epatel/discrete6502/pico-controller/README.md

# pico-controller: firmware for the discrete6502 bring-up Pico

The board carries an unpopulated **Raspberry Pi Pico 2 W** site. Factory-fitted
1k series resistors wire it to the CPU data bus, 14 address bits, clock, reset,
R/W and SYNC. Solder a Pico on and flash one of these firmwares. The Pico then
becomes the **clock master and memory emulator**, and the 6502 runs real
programs with no other hardware attached.

## Projects

| Folder | Purpose |
|---|---|
| `common/` | Shared bus engine (`bus6502.c/h`): pin map, clocking, memory serving, trace ring, reset. Also `functest.c/h` (functional-test watcher), `ihex.c/h` (streaming Intel hex loader), `retention.c/h` (charge-retention measurement) and the SDK import cmake. |
| `tester/` | **Bring-up harness.** A USB serial CLI. It resets the CPU, runs or traces N cycles, steps instructions, reads and writes memory, sets the clock speed, loads an Intel hex image, and runs the functional test. The default image is an A-register counter loop. Watch the A LEDs count. |
| `general/` | **Free-runner.** It boots the CPU and lets it run. A memory-mapped character-output port at `$3F00` prints to USB serial. The default image prints `HELLO 6502` forever. |
| `wifi/` | **Browser control panel.** The same bus engine runs on core 1. WiFi and a small HTTP server run on core 0. Upload an Intel hex, run, stop, step, reset, set the clock, and watch the bus and the functional-test progress live. It is built for unattended overnight test runs. |

Add a new project as a sibling folder (`pico-controller/<name>/`). Reuse
`common/`.

## Pin map (fixed by the board, do not change)

| Pico GPIO | Signal | Direction (Pico view) |
|---|---|---|
| GP0–7 | db0–7 | bidirectional |
| GP8–21 | ab0–13 | in |
| GP22 | clk0 | out (clock master) |
| GP26 | /res | out, open-drain |
| GP27 | r/w | in |
| GP28 | sync | in |

The CPU sees only 14 address bits. Memory is a **16 KB image**, mirrored across
the 64 KB space. The reset vector `$FFFC/D` is at offset `0x3FFC/D` in the
image.

## Bring-up sequence: read before first power-up

**The procedure of record is [`docs/bring-up.html`](../docs/bring-up.html)**
(live at `epatel.github.io/discrete6502/bring-up.html`), and what actually
happened, with every measurement, is in
[`docs/actual-bring-up.html`](../docs/actual-bring-up.html). This file used to
restate the whole sequence and drifted out of date against both — Step 1 kept a
gate that hardware falsified, Step 2 kept a prediction that was wrong by 4x. So
it no longer restates it. **The numbering below matches `docs/bring-up.html`
(Steps 0–8)**; what is written out here is the part that belongs to the
firmware, and everything else is a one-line pointer.

| | Step | Power |
|---|---|---|
| 0 | Receiving inspection | none |
| 1 | VCC↔VSS resistance | none |
| 2 | Board alone at 5 V, unclocked, no Pico | 5 V |
| 3 | Optional: external clock, watch the LEDs | 5 V |
| 4 | The eight-site 10 kΩ rework | none |
| 5 | **Solder the Pico** | none |
| 6 | First clocked run: the A-register counter | 5 V |
| 7 | Measure the clock window | 5 V |
| 8 | The functional test: the acceptance gate | 5 V |

Steps 0–4 need no Pico and no firmware — U1 is DNP, so the board arrives with no
3.3 V part on it and no logic-level question exists at any rail. Two results from
those steps set the numbers everything later is judged against, and **both
contradict what this file used to say**:

- **Step 1 does not "read high".** There is no resistor-only path between VCC and
  VSS at all: **1,899 FET body diodes across 947 nets** conduct VSS → drain → 10 kΩ
  → VCC, so the meter reads a *junction*, and the displayed value depends on the
  range. Board #1 read **195 Ω / 314 Ω / 3.77 kΩ** on the 200 Ω / 2k / 20k ranges
  while the voltage across it stayed at 0.36–0.47 V. **A fault is under 1 Ω, or a
  value that does not change with range.** And it is a *positive* test: that
  forward path cannot exist unless the pull-ups are populated, so one measurement
  confirms ~1,000 back-side 0402s are present.
- **Step 2 draws 1.4 A at 5 V, not 0.35 A** — but only because no Pico is fitted
  yet, so `clk0`, the data bus and reset are floating and the dynamic nodes drift.
  **Once the Pico is on, a parked clock draws 0.30 A** (the designed passive
  budget) and **executing draws 1.70 A** (measured, board #1, 2026-08-26). Treat a
  *change* from those figures as the signal, not an absolute.

Step 4's rework **has been done on board #1**. It is still required on any board
that has not had it; it fixes an invalid logic level, not a thermal problem —
that alarm was retracted on 2026-08-24.

### Step 5: solder the Pico

**Flash the firmware onto the bare module first**, on the bench, and confirm it
enumerates over USB. Then solder the Pico 2 W module on the underside site.
**Solder pin 39.** See Powering for why pin 39 must be a soldered joint and not a
decision.

Pin 38 is `vss` and pin 39 is `vcc`, side by side on 2.54 mm pitch. A solder
bridge between them is a dead short across the board supply. **Repeat the Step 1
resistance measurement after you solder the module**, and apply power only after
that measurement — reading it the range-aware way described above.

> **⚠ CHANGED 2026-08-25 — a powered board now clocks itself immediately.**
> This file used to say the firmware was "inert at boot", blocking on
> `while (!stdio_usb_connected())` so that a pre-programmed board powered with no
> terminal attached "does nothing: no clocking and no reset ceremony". **That is
> no longer true, and the change was deliberate.** No firmware here blocks
> waiting for a terminal, because the old blocking path left clk0 parked LOW —
> which was believed to be the board's peak current state. **That was wrong on a
> populated board** — see the correction under Powering: a parked clock draws
> **0.30 A** and executing draws **1.70 A**, so parking is the cheapest state, not
> the most expensive. Autorun remains the right default because you want the CPU
> doing something, not to save power.
>
> With `autorun` on, which is the **default**, applying power runs the reset
> ceremony and free-runs the stored or built-in image straight away. That is the
> cooler state and the more useful one, but it means **first power-up is now an
> event, not a decision.** Do the resistance measurement before you apply power,
> not after.
>
> If you want the old behaviour for a first power-up, set `S autorun off` (tester)
> or turn Autorun off in the panel's Diagnostics section *before* soldering — the
> setting lives in flash and survives. The clock then stays parked, which costs
> the extra 0.5 A but touches nothing.

#### Flash before soldering, even though it can be reflashed in place

The module can be reprogrammed in place indefinitely, and with no button press:
`pico_stdio_usb/reset_interface.c` is linked into all three firmwares, so the SDK
1200-baud-touch reset works and `picotool load -f -x` reboots the module into its
bootloader over USB. Flash it once beforehand anyway, for three reasons.

- **A bad module is cheap to reject before it is soldered.** The
  `RaspberryPi_Pico_W_SMD` pads are 3.2 × 1.6 mm and run *under* the module, so
  desoldering one is a poor operation to perform beside 4,051 transistors.
- **The first flash is the one that needs BOOTSEL**, held while the board
  power-cycles. That is the awkward step, and it is the step you can do off the
  board.
- **The first power-up becomes a known state**, not merely a harmless one. A blank
  module is safe, because RP2350 GPIOs default to inputs, but safe and known are
  not the same property.

**Verify what is on the module rather than trusting the banner**: the banner is
identical across recent builds, so use `picotool verify -f wifi/build/wifi.uf2`,
which diffs flash against the binary and prints the mismatching bytes. If you
have more than one module on the bench, `picotool` reports a per-board serial —
worth writing on a sticker, because two provisioned boards both answer to
`discrete6502.local` and you cannot tell from the panel which one you have.

**Unverified, worth checking before you choose a workholding setup:** the module
mounts pads-down, so its component side — USB connector and BOOTSEL button —
faces away from the PCB, which is downward when the board lies flat on its back.
Prop the board up or use standoffs to reach the connector. This is reasoned from
the footprint, not from a board in hand.

### Step 6: first clocked run

Power the board at 5 V. The firmware is already on the module from Step 5;
reflash in place if you have changed it, no button press needed. USB may stay
connected for serial.

With autorun on it is **already running** when you attach — the tester reports
how many cycles it free-ran while waiting, and the wifi firmware's banner reports
the cycle count. Run the default A-register counter image and watch the A LEDs
count.

Watch the supply current here. Measured on board #1, a clocked board sits at
**1.70 A executing against 0.30 A with the clock stopped** (2026-08-26). The
stopped figure is the passive network as designed; the 1.40 A difference is
contention. Treat a *change* as the signal.

**Two tie-offs that are not optional**, both learned the hard way on board #1:

- **Tie the data bus to `$EA` (NOP) through 10 kΩ** if the Pico is not driving it.
  A floating bus fetches random opcodes and **12 of the 256 are undocumented
  KIL/JAM**, so the CPU halts within ~20 instructions. With the Pico serving
  memory this is moot, but it matters for any external-clock experiment.
- **Tie `irq` and `nmi` high.** Neither has a pull-up on this board. A spurious
  IRQ is *absorbed* by the functional test's BRK handler at `$3819` — live code,
  not a trap — and resurfaces as a failure at an unrelated address. That is a
  wrong verdict that looks like a real CPU defect, which is worse than a stopped
  run. The firmware warns at load time.

### Step 7: measure the clock window

Walk the clock up with `p` (tester) or the panel's clock chips to find the real
ceiling; simulation says ~20 kHz at 5 V.

**The floor no longer needs measuring**: it was established at **456–871 Hz**
(leakage 1.9–2.3 nA per FET) from LED decay on board #1 — see
`docs/actual-bring-up.html` Step 2b. `W` is now a confirmation, not a first
measurement, and the "never run it before the rework" warning is retired along
with the thermal alarm. **Recommended working clock: 4–5 kHz**, the geometric
centre of the measured window.

Note the panel and the tester both display the clock as `1e6/(2*half)` — the
*nominal* rate. Measured, the loop costs about 1.2 µs per cycle, so 10,000 Hz
nominal is **9,878 Hz actual** (1.2% low; ~2.4% at the 20 kHz ceiling). It does
not matter for running programs, but it does if you are predicting frequencies —
`tools/pc_ripple.py` takes the true clock as an argument for exactly that reason.

### Step 8: the functional test

See "Running the 6502 functional test suite" below, and `docs/bring-up.html`
Step 8. Tie `irq` high first (above), and turn the console **off** — it
intercepts three addresses inside the range the suite checksums.

3.3 V is **not** a step in this sequence. It is a diagnostic fallback. See
"3.3 V operation" below.

## Logic levels

The Pico is a 3.3 V device. The CPU core runs at 5 V. This is the one
**unresolved hardware question** for bring-up. It does not affect the PCB.

- **Inputs to the Pico** (db on writes, ab, rw and sync at 5 V). The 1k series
  resistors limit the clamp current to about 1.4 mA per pin, and to about
  34 mA in total with all 24 input lines high. This is the common practical
  arrangement, but it is formally outside the RP2350 specification. It is
  acceptable for bring-up. Do not leave the CPU powered at 5 V while the Pico
  has no power. A soldered pin 39 makes that state impossible.
- **Clock drive.** The board has no pull-up on clk0. clk0 is a pure input: two
  FET gates, a 100R series resistor and the clamp diodes. Nothing holds a
  level. The clock source must therefore drive clk0 push-pull. An open-drain
  driver pulls clk0 low and then leaves it floating, and a dynamic CPU cannot
  survive that. `bus_init(false)` is the default and the correct mode.
  `bus_init(true)` works only if you first croc-clip an external **10k resistor
  from the Φ0 bond pad to the VCC bond pad**.
- **A 3.3 V clock into a 5 V core is safe**, and needs no pull-up. clk0 does
  not gate the pass transistors. It drives two pull-down gates, and the board
  regenerates the internal clock phases (`cclk`, 482 gates, and `cp1`, 198
  gates) at full VCC swing. In simulation, a 3.3 V clk0 into a 5 V core gives
  an input-inverter low of 1.7 mV and 17 ns of delay. A 5 V clock gives 1.4 mV
  and 7 ns. There is no functional difference.

## Powering

Board VCC feeds the Pico VSYS pin (pin 39). The two grounds are common. VSYS
accepts 1.8 V to 5.5 V, thus 3.3 V and 5 V are both in specification. Pin 39 is
the only supply pin. The Pico 3V3OUT pin (pin 36) is not connected, thus the
Pico regulator cannot feed the board.

### Either end can supply the power

A soldered pin 39 makes board VCC and Pico VSYS one node. Power therefore flows
in whichever direction you supply it, and **the bond pads are not mandatory**.

- **Bench supply on the bond pads.** The board runs, and the same rail feeds
  VSYS. The Pico then needs no USB power. Connect USB for serial only.
- **USB into the Pico.** VBUS goes through the module Schottky diode to VSYS
  and on to board VCC. One cable runs the whole CPU, with no croc clips.

Only Step 2 of the bring-up sequence needs the bond pads, and only because no
Pico is fitted at that point.

Use the bench supply for test runs, and USB-only mode to demonstrate the board.
The next two sections give the reasons.

### Pin 39 must be soldered

Solder pin 39 when you solder the module. Board VCC and Pico VSYS then become
the same node, and two problems disappear together.

- **No power-up sequence to remember.** The hazard is a 5 V core that drives 26
  clamp diodes into a dead 3V3 rail. One supply for both parts makes that
  condition unreachable.
- **No intermittent joint.** The `RaspberryPi_Pico_W_SMD` footprint has 3.2 x
  1.6 mm pads that extend inward, under the module. An unsoldered pin 39 is two
  flat copper faces that rest against each other, held apart only by the
  standoff that the adjacent solder joints happen to give. That gap is
  uncontrolled, and board flex or a croc clip can close it. An unsoldered pin 39
  is an intermittent contact, not an open circuit. A rail that makes and breaks
  corrupts every dynamic node at once, and the result looks like a random CPU
  fault.

The two rails do not rise together. Board VCC rises immediately. The Pico 3V3
rail follows some milliseconds later, through the buck-boost soft start. The
GPIO clamps do conduct during this interval, but from the same supply and
through the 1k series resistors. This is the usual arrangement on a Pico
carrier board. Board bulk capacitance is only about 50 uF (96 x 100 nF plus
4 x 10 uF), thus there is no inrush that can hold the ramp down.

At 5 V you can keep USB connected for serial at the same time. The module
Schottky diode drops USB VBUS to about 4.7 V to 4.8 V at VSYS, thus a 5.0 V
bench supply wins the node, and the diode blocks all back-feed into the host.

### USB-only demo mode

With no bench supply, Pico USB power runs the whole board through VBUS, the
module Schottky diode and VSYS. Three limits apply.

- **The rail is not 5.0 V.** It is VBUS minus the diode drop, and the board draws
  far more than this section once assumed, so through a Schottky and a USB cable
  it is a collapse rather than a droop. Cable resistance subtracts more still.
- **Current — USB-only mode is NOT viable at 5 V.** Measured on board #1:
  **0.30 A with the clock parked, 1.70 A executing** (measured 2026-08-26 with the
  Pico fitted; the 1.4 A recorded earlier was a *bare* board with clk0 and the bus
  floating). Use a **2–3 A bench supply**. The `wifi` firmware adds about 50 mA
  average with 200 mA transmit bursts on top of that.

  > **Corrected 2026-08-24.** This entry previously said ≈2.1 A from driver
  > contention — the eight data-bus drivers at 262 mA each — and before that
  > 0.35 A typical. **Both were wrong, in opposite directions.** Thermal imaging
  > found no hot spot anywhere (peak ~30 °C against 25 °C ambient), which a 0.9 W
  > SOT-323 could not hide, so the excess is spread over ~4,051 near-threshold
  > FETs at ~210 µA each rather than concentrated in a few contending pairs. The
  > 2 A charger that the 2.1 A figure ruled out is in fact adequate.
- **Use a bench supply for test runs.** This is dynamic logic. A rail sag does
  not degrade gracefully. It corrupts the dynamic nodes, and you read the
  result as a logic fault in the CPU. Use a bench supply with margin for the
  functional-test run, which is hours long. Keep USB-only mode for
  demonstrations.

All board current in this mode goes through one castellation and one via to
the In4 VCC plane. That is sufficient at these currents, but it is a single
feed.

### Talking to the CPU: a memory-mapped console

Three addresses, shared by all three firmwares (`common/console.c`):

| Address | Access | Meaning |
|---|---|---|
| `$3F00` | write | a character the CPU is printing |
| `$3F01` | read | the character waiting for the CPU, or 0 if none |
| `$3F01` | write | **acknowledge** — discards it, the next one appears |
| `$3F02` | read | bit0 = input waiting, bit1 = output has room |

The read at `$3F01` is **non-destructive**, and acknowledging is a separate
write. Consume-on-read is the usual design but it punishes ordinary 6502 code:
`LDA $3F01` then `CMP $3F01` reads twice and would silently eat a character.
Read as often as you like; say when you are done.

    wait:   LDA $3F01       ; character waiting?
            BEQ wait
            PHA
            STA $3F01       ; acknowledge; the next one appears
            PLA

Panel: a **Console** section with the CPU's output and a field to send text.
Tester: `C` shows it, `C on` / `C off`, and `C <text>` sends. `general` enables
it at boot and mirrors output to USB serial as well.

> **Off by default, and turn it off for the acceptance suite.** This board
> decodes 14 address bits, so every address is inside the 16 KB window, and the
> functional test checksums RAM up to `$3FFF` with `ram_top = $40`. An
> intercepted address never reaches memory, so the readback differs and the
> suite fails a RAM-integrity check that has nothing to do with the CPU. Both
> firmwares warn if you enable it with a test image loaded.

### There is no single-step, and the panel no longer pretends otherwise

This is dynamic logic. `bus_step_cycle()` rests the clock **LOW**, and the worst
node holds charge for about **1.1 ms** in exactly that state (measured, board #1).
A human takes 200 ms to click anything. So pressing step twice does not resume
the first step — it resumes decayed garbage that still looks like a machine.

The same applies to *any* two commands issued in sequence. The old documented
workflow was `R` then `t 40`; the clock parks while you type, and the reset state
is gone before the trace starts.

**The rule: the clock never stops, and a command is a bounded interruption.**
Anything needing a defined starting state must reset and run atomically.

| Instead of | Use | Why |
|---|---|---|
| step, step, step | `R N` / **Reset and run** | Deterministic — always starts from reset, so it is reproducible |
| stop, then trace | `t N` / **Capture 200 cycles** | The clock runs throughout the capture; reading the ring afterwards costs nothing |

**The trace ring is the debugger.** You cannot step through execution on this
machine, but you can step through *history*, and history does not decay.

### The panel

Summary first: a state pill (Running / Passed / Failed / Stopped), what is
loaded, a progress bar, and the time remaining. Then one primary button, then
everything else folded behind `<details>` — program, clock, activity log, bus
trace, diagnostics.

Progress comes from **cycles**, not checkpoints: `program_cycles` divided into
`bus_cycle_count` is exact, needs no checkpoint table, and works for any image
whose measured cycle count was stored.

**The verdict is now reported, not left to you.** Built with
`-DEMBED_FUNCTEST=ON`, the trap table maps a self-loop address to pass or fail
and its line in the assembly listing; `/status` carries `tk`, `tp` and `tl`, so
the panel says *"6502_functional_test complete — self-loop at $34D8, listing
line 3078"* with a green pill. Without the flag it reports the bare address and
says so, rather than guessing.

### Storing a program also stores the clock

`S store` (and the panel's **store as boot image**) writes the whole settings
record, so **whichever clock is set at that moment becomes the clock the stored
program boots at**. That is deliberate — a program and the speed it should run at
belong together — but it is worth stating, because getting it wrong is quiet and
expensive:

| clock | 6502 functional test |
|---|---|
| 20 kHz | 1 h 20 m |
| 10 kHz | **2 h 41 m** |
| 3 kHz | 8 h 58 m |
| 1 kHz | **26 h 52 m** |

Store the acceptance suite while the clock happens to sit at 1 kHz — perfectly
reasonable if you had been watching LEDs — and the board boots into a 27-hour run
instead of a 3-hour one, with nothing to tell you until it hasn't finished
overnight.

So the board now says so. Storing prints the image, the clock and the runtime;
`S` shows it; the panel's status line carries it:

    > S store
    stored 16 KB as the boot image, with the clock now set
      6502_functional_test at 50 us half-period (10000 Hz) -- runs for about 2 h 41 m

The estimate needs a known cycle count, which comes from the emulator runs that
validated the images (`tools/build_functest.py`, measured 2026-08-08: 96,779,996
cycles functional, 46,089,513 decimal). An image you upload yourself has no such
number and simply shows no estimate rather than a wrong one.

### Finding the board: discrete6502.local

Once it joins your network the board answers to **`http://discrete6502.local/`**, so you
never have to hunt for its address in the router's admin page. It also advertises the
panel over DNS-SD, so it shows up in network browsers.

mDNS runs on the station interface only. In setup mode the DNS hijack already
sends every name to us, so a responder there would be answering a question
nobody asks — use `http://192.168.4.1/`.

**Resolution is not universal.** macOS, iOS, Windows 10 (1703+) and Linux with
`avahi-daemon` all resolve `.local` natively. **Android is the gap** — system
`.local` resolution only arrived in Android 12 and Chrome on Android still often
fails. From an Android phone, expect to use the IP address, which the serial
console prints at boot and the panel shows in its heading.

Costs `LWIP_IGMP` (mDNS is multicast) and one netif client-data slot;
**+18 KB flash**.

### Storing a program as the boot image

A 6502 image saved to flash becomes what runs at power-up, on all three
firmwares. Load it however you like, then store it:

| Firmware | Store | Forget |
|---|---|---|
| `tester` | `S store` after `L`, `T f`/`T d` or `m` | `S forget` |
| `wifi` | **store as boot image** button, after uploading the hex | **forget stored image** |
| `general` | — (runs whatever is stored) | — |

The panel's status line says whether an image is stored and how large it is.

**Storing refuses while the CPU is running, and that is deliberate.** A flash
erase parks the bus engine's core for tens of milliseconds against a measured
~1.1 ms retention floor, so the 6502's state cannot survive one. Refusing is
better than silently corrupting a run that looked healthy a moment earlier. Both
firmwares reset the CPU after a successful store, so what runs next is what is
now stored.

`general` changed more than the others: it no longer waits for a USB terminal
before starting. It exists to free-run, and waiting meant a demo board with no
computer attached sat with its clock **parked** indefinitely — the board's peak
current state. It now resets and runs at boot, and prints a line if and when
somebody plugs a terminal in.

### WiFi setup: no credentials in the build

The `wifi` firmware no longer needs credentials at compile time. On boot it
tries what is stored in flash; with nothing stored, or if two attempts fail, it
raises its own access point and serves a setup page.

1. Join **`discrete6502-setup`** (open, no password).
2. The phone should offer "Sign in to network". If not, open **http://192.168.4.1/**.
3. Pick a network from the scan list, type the password, Save.
4. It stores them and reboots onto your network.

`common/netsrv.c` provides the two servers this needs, written from the
protocols rather than vendored. **DHCP is mandatory** — join an access point
that hands out no address and nothing can talk at all. **DNS is what makes it
*captive*:** answering every lookup with our own address means the phone's
connectivity probe reaches us instead of its expected reply, which is what
raises the sign-in prompt.

`-DWIFI_SSID=` / `-DWIFI_PASSWORD=` still exist, but only as a **one-time seed**
for a board you want to arrive pre-provisioned. They are copied into flash on
first boot and never used again. They still have no defaults, so nothing can be
committed by accident.

**The page is served from the Pico deliberately, and hosting it elsewhere is
impossible rather than merely worse.** GitHub Pages is HTTPS, and an HTTPS page
may not call an `http://` address on a private network — browsers block it as
mixed content and no CORS header changes that. And in setup mode there is no
internet at all, which is precisely when the page is needed. It costs 1.5% of
flash.

**The setup AP is open.** It only runs when the board is unprovisioned or its
network is unreachable, and it is a bench tool, but do not leave it in that
state on a network you do not control.

**To change networks later**, open the panel's **Network** section and use
*Forget this network*. It clears the stored credentials and reboots into setup
mode. That is a reboot rather than a teardown in place on purpose: the reply has
to reach the browser that asked for it, and that browser is on the link being
dropped, so the board answers first and reboots 1.2 s later. The CPU keeps
running throughout — only the way you talk to it changes.

### The link is watched, in both directions

Joining once at boot is not enough. Nothing in the SDK reconnects a dropped
station link, so an AP reboot, a lapsed DHCP lease or a walk out of range used to
cost the panel until someone power-cycled the board. That matters here because a
functional-test run is nearly three hours and **core 1 keeps clocking straight
through a network outage** — the run survives one, so the observability has to as
well.

`link_watch()` polls `cyw43_tcpip_link_status` every 5 s (not
`cyw43_wifi_link_status`: associated-but-no-address is still unreachable, and a
lapsed lease fails exactly that way). It allows **20 s of grace** before acting,
because roaming and rekeying both look like a brief outage and tearing down a
working setup for those is worse than the problem. Then it retries, and falls
back to the setup AP.

Setup mode is not terminal either: it **re-tries the stored network every 5
minutes**, but never while someone has the portal open. Without that, a board
whose network merely happened to be *down* at boot would sit in setup mode
forever after the network came back.

**Belt and braces: the verdict also prints on the serial banner.** It used to
exist only in `/status`, so a completed three-hour run was readable only over the
network. USB now reports PASS/FAIL with the trap address and its listing line, so
a network outage can cost you the live progress but never the result.

> **A trap worth remembering, fixed 2026-08-25.** A *wrong* stored password left
> the portal stuck on `scanning…` with no network list, while a virgin board
> worked fine. `try_sta()` enables station mode and nothing turned it off when it
> failed, so the AP came up on a radio still retrying an association — which
> starves the scan: it stays "active" forever, `busy` never clears, and the page
> never replaces its placeholder. A virgin board never hit it because `try_sta()`
> returns *before* enabling station mode when no SSID is stored. `start_ap()` now
> disables station mode first, and a scan that has not finished in 15 s is
> treated as finished, so the portal cannot hang on a spinner whatever the cause.

### Persistent settings and a stored boot image

The top **64 KB of flash** holds a settings record and a 16 KB 6502 image, so the
clock period, the boot behaviour, the WiFi credentials and a program all survive
a power cycle. `common/settings.c`; 1.6% of a 4 MB part.

From the tester CLI:

    S                    show current settings
    S autorun on|off     clock the CPU at boot, or park it
    S clock 50           half-period in us (50 us = 10 kHz)
    S store              save what is in memory as the boot image
    S forget             drop it; the built-in counter becomes default again
    S save               persist the above

**A flash write destroys the 6502's state, and that is not avoidable.** Erasing
turns XIP off, so the bus engine's core must be parked, and a sector erase takes
tens of milliseconds while the worst dynamic node holds charge for about
**1.1 ms** (measured, board #1). Stop the CPU and reset it after saving. Never
save while a program is running.

On the dual-core `wifi` build, core 1 calls `multicore_lockout_victim_init()` at
entry. Without it `flash_safe_execute()` refuses and every save fails.

### The board clocks itself at boot

`bus_init()` leaves clk0 an output driven **LOW**, so the old sequence -- init,
then block on `stdio_usb_connected()` -- left an unattended board with its clock
parked. That was believed to be the board's **peak** current state, from a
**1.4 A unclocked** measurement. > **⚠ CORRECTED 2026-08-26.** That 1.4 A was measured with **no Pico on the board**, so `clk0`
> (which has no pull-up here), the data bus and reset were all **floating** — which really does
> drift the dynamic nodes and bias thousands of FETs near threshold. **It is not the state a
> populated board sits in.** With the Pico fitted and the clock parked, board #1 draws **0.30 A**,
> the designed passive budget. Executing, it draws **1.70 A**. So on a board with a Pico,
> **clocking costs about 1.4 A rather than saving it**, and parking the clock is the *cheapest*
> state, not the most expensive.

So the clock-parked state is fine to leave a board in. Autorun is still the right
default, for the ordinary reason that a board on a shelf may as well be running,
not because it saves current.

With `autorun` on, which is the default, the tester runs the reset ceremony and
free-runs the stored or built-in image while nobody is attached, then stops and
reports the cycle count when a terminal appears. `g` resumes.

**No firmware here ever blocks waiting for a terminal.** That was fixed on
2026-08-25, and the `autorun off` path was the reason: it sat in
`while (!stdio_usb_connected()) sleep_ms(100)` with clk0 parked LOW, for as long
as nobody attached, which might be forever. (The current argument that originally
motivated this is corrected above — parking is not the expensive state — but a
firmware that waits forever for a terminal is wrong regardless.)
The tester now has one wait, in its main loop, and it does not block: with
autorun on the CPU free-runs in 500-cycle chunks, otherwise it polls cheaply.
`read_line()` polls rather than calling `getchar()` and returns −1 when the
terminal goes away, so a disconnect mid-line — or mid-paste during a 37.6 kB
Intel hex load — unwinds instead of wedging.

The banner also **reprints every time a terminal appears**, not just the first.
You cannot attach before the board boots, so a greeting emitted once into the
void tells nobody anything. The `wifi` firmware does the same on the DTR rising
edge. Its only blocking wait is under `-DBOOT_TRACE=ON`, which is off by default
precisely because a headless board must never wait for a terminal; `general`
never had one.

### Optional modification: bridge VBUS to VSYS (demo boards only)

Pin 40 is VBUS. On our board it is `nc40`, a net with one pad and nothing else
on it, thus a solder bridge across the pin 39 and pin 40 castellations ties
VBUS to VSYS and touches no other net. It bypasses the module Schottky diode.
The modification is reversible.

It improves USB-only mode:

- The rail becomes VBUS, about 5.0 V minus the cable drop, instead of 4.7 V to
  4.8 V. This is the full 5 V margin.
- The supply is stiffer for the WiFi bursts, because the diode dynamic
  resistance leaves the path.
- The diode stops dissipating the ~0.4 W it sees at the 1.70 A the board actually
  draws when executing. That is real, but it does not rescue USB-only
  operation at 5 V: the current is the limit, not the diode.

**It also removes the reverse blocking, thus a bridged board must never have a
bench supply on its bond pads.** Board VCC becomes VBUS, thus a bench supply
drives current back through the cable into the USB host port. This is outside
the USB specification, and different hosts tolerate it differently. The
"connect USB for serial while the bench supply runs the board" arrangement is
no longer available on a bridged board. Two smaller effects: the USB connector
VBUS contact sits at board voltage when no cable is connected, and the Pico W
VBUS sense reads "USB present" whenever the board has power.

Use this per board, not as a general change. One board of the four can become a
USB-only demonstration unit: one cable, a true 5 V rail and the brightest LEDs.
**Mark that board physically.** Leave the other boards unmodified, so they keep
the bench-supply and serial workflow.

## 3.3 V operation: a fallback, not a first step

The whole CPU can run at VCC = 3.3 V. Simulation clears it: `sim/passpair_33v.sp`
(2026-07-25) shows that the dynamic latches still work at 3.3 V and at 3.0 V,
and that the clock-edge bootstrap keeps the stored '1' at or above the rail.

**Do not use it as the first power-up.** 3.3 V is the tighter operating point,
not the safer one, and it squeezes the usable clock window from both ends.

| | 5 V | 3.3 V |
|---|---|---|
| Clock ceiling (`sim/fanout_speed.sp`) | about 20 kHz | about 10 kHz |
| Retention floor: worst-node leakage budget | under 53 nA per FET | under 27 nA per FET |
| Usable clock window | about 50x | about 13x |
| Register LED current (`sim/led_tap.sp`) | 1.42 mA | 0.67 mA |

The dim LEDs are cosmetic, not a fault, but the LEDs are one of the few
observation channels at bring-up. The important cost is the ambiguity: a board
that misbehaves at 3.3 V does not tell you whether the cause is an assembly
fault or the reduced margin, and you must go to 5 V to find out. A first test
with an ambiguous failure mode is a bad first test.

3.3 V is useful **after** Step 2 has given a good current reading, as a
diagnostic lever: if the CPU behaves erratically at 5 V, a lower rail changes
the timing and the LED currents, and the difference is informative.

To run at 3.3 V, remove the competing supply, because a soldered pin 39 plus
USB pulls board VCC to about 4.8 V and a 3.3 V bench setting cannot win against
it. Two ways:

- **No USB.** Flash over USB first. The board sits at about 4.8 V during
  flashing with the clock idle, which does no harm. Then disconnect USB and
  apply 3.3 V. Use the `wifi` firmware to keep full control with no cable.
- **A data-only USB cable**, if you want serial at 3.3 V. **Unverified:** the
  RP2350 may need VBUS present to enumerate when it is self-powered. Test this
  on a spare Pico before you rely on it.

## Build

The build needs the [pico-sdk](https://github.com/raspberrypi/pico-sdk) (2.x
for RP2350) and the ARM GCC toolchain. The build was **verified on 2026-07-26**
with pico-sdk 2.1.1 and arm-none-eabi-gcc. `tester` is 37 KB text and 32 KB
bss, and `general` is similar. The 16 KB memory image and the 1024-entry trace
ring dominate bss. Both fit the 520 KB of the RP2350 with room to spare. The
build needs only the `lib/tinyusb` submodule. Expect btstack, cyw43 and lwip
warnings, because neither firmware uses the radio.

A `Makefile` here wraps the cmake commands:

```sh
make                 # tester + general
make wifi WIFI_SSID=yournet WIFI_PASSWORD=secret
make all-wifi        # all three
make size            # flash/RAM use of whatever is built
make flash-tester    # hold BOOTSEL while plugging USB first
make clean
```

Put the credentials in `pico-controller/wifi.local.mk`. Git ignores this file,
so the credentials stay out of your shell history:

```make
WIFI_SSID := yournet
WIFI_PASSWORD := secret
```

You can also run cmake directly:

```sh
export PICO_SDK_PATH=/path/to/pico-sdk
cd pico-controller/tester        # or general/
cmake -B build && cmake --build build -j
```

The development machine is already set up. The SDK is at
**`~/Development/pico-sdk`**, version 2.1.1, with the `tinyusb`, `cyw43-driver`
and `lwip` submodules fetched. `btstack` and `mbedtls` are not needed.
`~/.zshrc` exports `PICO_SDK_PATH`, so `cmake -B build` works without more
setup. On another machine, clone the SDK and set the variable yourself. Nothing
in this repository depends on that path.

To flash a firmware:

1. **Board supply off**, hold BOOTSEL, **board supply on**, release.
2. Copy `build/tester.uf2` to the mass-storage device.

**"Hold BOOTSEL and plug in USB" does not work on this board** (corrected
2026-08-30). Pin 39 is soldered, so VSYS *is* board VCC: unplugging USB does not
remove power and therefore does not reset the module, and BOOTSEL is only
sampled at reset. Cycling the *board* supply is the real power-on reset. This is
doubly true with a data-only cable, where USB carries no power at all.

If cycling the supply is inconvenient, **`RUN` (pin 30) is `nc30` — unconnected,
a free castellation.** Hold BOOTSEL and momentarily short pin 30 (board
`30.31, 102.27`) to pin 28 (`vss`, `30.31, 107.35`). **Pin 29 sits between them
and it is `clk0`** — use a fine probe, not a clip.

You can also run `picotool load -f build/tester.uf2`, or
`python3 tools/pico_flash.py <target>`, which uses the 1200-baud touch and needs
no button at all — but that needs an already-enumerated port, so BOOTSEL remains
the recovery path when the firmware on the board will not stay up.

**BOOTSEL mode is always safe**: the bootrom runs instead of your firmware, so
nothing drives `clk0` and the board stays at its ~0.24 A rest current.

The `wifi/` build also needs the `lib/cyw43-driver` and `lib/lwip` SDK
submodules. It needs credentials as well. The credentials have no defaults, so
nobody can commit them by accident:

```sh
cd pico-controller/wifi
cmake -B build -DWIFI_SSID=yournet -DWIFI_PASSWORD=secret && cmake --build build -j
```

Measured on 2026-07-26, `wifi` uses 342 KB of flash and 92 KB of RAM. This is
8% of the 4 MB flash and 18% of the 520 KB SRAM, and about 430 KB of RAM stays
free. The fixed `w43439A0` radio firmware blob is two thirds of the flash, not
code.

## The wifi control panel

Flash the firmware. Watch the USB serial output for `[wifi] http://<address>/`.
Open that address in a browser. The firmware serves the page from flash with no
external dependencies. There is no CDN and no framework. The page therefore
works on a bench network with no internet, and on a phone next to the board.

The controls are reset, run, stop, step-instruction, clock half-period,
functional-test watcher on and off, `vector→$0400`, and Intel hex upload. The
page shows the live bus cycle and the last 24 cycles. It also builds a log of
`test_case` progress and the final verdict.

**Why the firmware has this structure.** The bus engine runs on **core 1** and
touches nothing else. WiFi, lwIP and HTTP run on **core 0**. This split is not
tidiness. The board uses dynamic logic, so a stretched clock phase is a
correctness bug. Association and DHCP block for milliseconds at a time. Inside
the clock loop that is fatal. On another core it is invisible. Two consequences
matter before you edit the firmware:

- The firmware puts the watcher in **quiet mode** (`functest_set_quiet`). Pico
  `stdio_usb` blocks for up to 500 ms when a terminal is attached but does not
  read. A `printf` on core 1 would stretch a 50 µs clock phase ten thousand
  times. Progress reaches the browser through the shared snapshot instead.
- Both cores share the memory image. The firmware therefore returns `409` for a
  hex upload or a vector patch while the CPU runs. Stop the CPU first. The page
  buttons follow this order.

The per-cycle snapshot that core 0 reads is lock-free on purpose. Every field
is word-sized and atomic on ARM. The worst case is a display that mixes two
adjacent cycles for one 500 ms refresh. A lock inside the clock loop would cost
more than this cosmetic race.

Two physical limits apply:

- **The range is short.** The module sits on the underside of a 291 × 322 mm
  board, between the GND and VCC planes. The antenna strip has an all-layer
  keepout, so the radio works. The antenna still radiates at the edge of a
  large ground structure. Expect same-room range, not whole-house range.
- **Power. Use a bench supply with this firmware.** WiFi adds about 50 mA
  average, with transmit bursts of 200 mA to 300 mA. The WL LED is also left on
  permanently. On top of the measured board current — **1.70 A executing**
  (board #1) — USB-only mode is **not viable** at 5 V. Two earlier
  figures here are superseded: 0.9 A worst case assumed a 0.35 A board, and
  ≈2.1 A assumed concentrated driver contention that thermal imaging falsified on
  2026-08-24.

  The bursts matter more than the average. A 200 mA to 300 mA step lands on the
  same rail that holds 456 dynamic storage nodes, and the board has only about
  50 uF of bulk capacitance to absorb it. Short croc leads from a bench supply
  make this a non-event. A USB cable and the module Schottky diode make it a
  real dip, and a dip that corrupts the dynamic nodes reads back as a CPU logic
  fault, not as a power problem. This firmware exists for the unattended
  overnight functional-test run, which is the longest possible exposure to that
  failure mode.

  This firmware does not manage power in any way. There is no `cyw43_wifi_pm()`
  call, no `set_sys_clock*` call, and no sleep or dormant mode. `cyw43_arch_init()`
  takes the SDK default, and the core 1 bus loop never idles. The core split is
  a timing decision, not a power decision.

## Using the tester

Connect a serial terminal to the Pico USB port at any baud rate, then:

```
R          # reset sequence
t 32       # run 32 cycles, watch the bus: cycle addr data r/W SYNC
s 5        # step 5 instructions
x 300 10   # hexdump $0300.. (the counter byte lives here)
p 100      # slow the clock to 5 kHz (half-period 100 us)
L          # load an Intel hex image pasted into the terminal
T f        # or load a built-in test image (needs -DEMBED_FUNCTEST=ON)
k on       # arm the functional-test watcher (see below)
g          # free-run with the watcher until a self-loop
```

After `R`, a healthy CPU shows the 7-cycle reset sequence and a vector fetch at
`3FFC/3FFD`. The fetch and execute rhythm follows, with SYNC on each opcode.
The default image increments A forever. The A-register LEDs count in binary and
`$0300` follows them.

## Running the 6502 functional test suite

[Klaus Dormann's `6502_65C02_functional_tests`](https://github.com/Klaus2m5/6502_65C02_functional_tests)
(GPLv3) is the standard acceptance test for a 6502 *re-implementation*. This
board is a re-implementation, not an emulator. The suite fits this hardware.
With the stock configuration (`zero_page = $0A`, `data_segment = $200`,
`code_segment = $400`, 13.1 kB of code) the image ends near `$3800`. That is
inside the 16 KB mirrored window, and it leaves the reset vector at `$3FFC`
clear. The `ram_top` option of the suite even offers `$40 = 16k` as a preset
for mirrored systems. **The loss of ab14 and ab15 does not block the suite.**

### Build the images with `tools/build_functest.py`

Do not assemble by hand. `tools/build_functest.py` drives the suite's own
assembler and then does the four board-specific things:

```sh
python3 tools/build_functest.py            # both tests
python3 tools/build_functest.py decimal    # just one
```

It expects a checkout of the suite as a sibling directory
(`../6502_65C02_functional_tests`, override with `--suite`) and Docker, because
AS65 1.42 is an i386 binary and the suite's `BUILDING.md` documents
`--platform linux/386` as the working recipe on Apple Silicon. Outputs go to
`gen/functest/`:

| file | what it is |
|---|---|
| `<test>.hex` | Intel hex of the folded 16 KB image, reset vector already patched |
| `<test>_traps.csv` | every self-loop: address, kind, `test_case` at that point, source line |

What the script does beyond assembling:

1. **Sets `ram_top = $40`**, the suite's own preset for a 16k mirrored system.
2. **Folds 64 KB to 16 KB** the way the hardware does, and **fails on a genuine
   aliasing collision.** The vectors at `$fffa` alias onto `$3ffa`, thus this is
   a real check and not a formality.
3. **Patches the reset vector**, because the suite aims RES at `res_trap` on
   purpose. `m 3FFC 00 04` is therefore no longer needed.
4. **Extracts the verdict map.** Pass and fail are both self-loops, told apart
   only by address, thus an address-to-source table is what makes a failure
   diagnosable.

Verified: with stock configuration the same toolchain reproduces upstream's
committed `bin_files/6502_functional_test.bin` **byte for byte**, and both
generated images were executed in an emulator against a mirrored 16 KB memory
before any hardware existed.

### The addresses you need

| | functional test | decimal test |
|---|---|---|
| Entry | `$0400` | `$0200` |
| Highest code byte | `$38A2` (1,880 bytes spare) | `$02F5` |
| Progress address | **`$0200`** (`test_case`) | **`$0001`** (`N2`) |
| Progress range | 0..43, then `$F0` for the final phase | 0..255, twice |
| **PASS** | **`$34D8`** | **`$024F`** |
| FAIL | any other self-loop — look it up in the CSV | `$0252` |
| Spurious NMI | `$380B` — a self-loop, so it stops visibly | `$02F3` |
| Spurious IRQ | `$3819` — **live code, NOT a self-loop** | `$02F3` |

**The IRQ row is the one to read twice** (established 2026-08-16 by reading
upstream's source against the generated trap map, correcting an earlier claim
that both were identifiable traps). `nmi_trap` uses the suite's `trap` macro and
so parks in a `jmp *` — a spurious NMI stops the CPU at `$380B`, which the
firmware names for you. `irq_trap` at `$3819` is **not a trap at all**: it is the
BRK-test handler, live code beginning `php / dey / dey / dey`. A spurious IRQ is
therefore *absorbed*, corrupts Y and the stack pointer, and surfaces later as a
failure at an unrelated address — a wrong verdict rather than a stopped run.

Since `irq` and `nmi` carry only a 100R and the clamp diodes on this board — no
pull-up, unlike `rdy` and `so` — **tie both bond pads high before any long run.**
That is not tidiness; for `irq` it is what separates a trustworthy result from a
plausible-looking lie. The decimal test is safe either way: our added `int_trap`
gives both vectors a distinct self-loop of their own.

### Optionally, skip the paste: `-DEMBED_FUNCTEST=ON`

Pasting 37.6 kB of Intel hex through a terminal by hand is the step most likely
to go wrong at the hour you are least fresh. The firmware can carry both images
instead:

```sh
cmake -B build -DEMBED_FUNCTEST=ON ..
```

Then `T f` (functional) or `T d` (decimal) loads the image, arms the watcher at
the right progress address, and warns about the IRQ vector above. `T` alone
lists what is built in. Cost: **+39 KB of flash and 0 bytes of RAM** — the
images are `const` and stay in XIP flash, and the 16 KB destination buffer
already existed. Tester text goes 41.6 KB → 81.3 KB, against 4 MB of flash.

It also buys a **named verdict**. Without it the firmware can only say "self-loop
at `$34D8`" and you go to the CSV; with it, it says which trap that is, its
listing line, and whether it is the PASS one.

**It is off by default for a licensing reason, not a technical one.** The suite
is GPLv3 and this project is CC BY-NC-SA 4.0 — incompatible, since GPLv3 forbids
adding a NonCommercial restriction. Separate files in `gen/functest/` are mere
aggregation; a binary with the images compiled in is a combined work. So the
generated `common/functest_images.c` is gitignored, no firmware binary
containing GPLv3 material is ever produced by default, and one you build with
the flag on is fine to use but not to redistribute. See
`gen/functest/README.md` and `common/functest_images.h`.

### Run it

```
p 50          # start at the conservative default clock
T f           # built-in image, if compiled with -DEMBED_FUNCTEST=ON;
              # otherwise: L, then paste gen/functest/<test>.hex
k 0200        # watcher on at the progress address ($0001 for the decimal test)
              # (T already does this for you)
R             # reset
g             # go: run until a self-loop, print progress
```

The suite has no I/O. The watcher therefore reads two side channels from the
bus:

- **Progress.** Every write to `test_case` marks a passed sub-test. The tester
  prints `[functest] test $NN at cycle N (+delta)`. The value `$F0` means the
  opcode tests are complete and the final RAM-integrity check has started.
- **Verdict.** A pass and a failure are both branch-to-self loops. The watcher
  reports any address whose opcode fetch repeats 4 times, and it stops the run.
  Look the address up in `gen/functest/<test>_traps.csv`. `$34D8` means **PASS**.
  Any other address is the trap for the opcode above it, and the CSV gives the
  source line and the `test_case` number that was current.

**Human-readable error messages are not available on this board, and that is
measured rather than assumed.** The suite's `report = 1` option produces text
through an I/O channel, but it adds 3.5 kB: the image then ends at **`$466B`**,
past the `$3FFA` ceiling of the mirrored window. The two side channels above are
the whole story. This is the reason the verdict map matters.

**Tie `irq` and `nmi` high before a long run.** Neither has a pull-up on the
board — only a 100R and the clamp diodes, unlike `rdy` and `so`, which carry 10k
(`R48`, `R991`) — and the Pico does not drive either one. Both float. A floating
gate on a dynamic input can drift across threshold and fire a spurious
interrupt, which would end an overnight run for no reason. Croc-clip both bond
pads to VCC, directly or through 10k. If one does fire anyway it is
**identifiable rather than confusing**: the run stops at `$380B` for NMI or
`$3819` for IRQ, and neither is a test trap.

**Plan the time — measured, not estimated.** Both images were executed to
completion in an emulator against a mirrored 16 KB memory:

| | cycles to PASS | at 10 kHz | at 20 kHz |
|---|---|---|---|
| `6502_decimal_test` | 46,089,513 | 1 h 17 m | 38 m |
| `6502_functional_test` | 96,779,996 | **2 h 41 m** | 1 h 21 m |

That is an afternoon, not an overnight run — the earlier "overnight" figure was
conservative, though the 10⁷ to 10⁸ order of magnitude was right. Run the
decimal test first: it is half the length, and decimal mode comes free from the
visual6502 netlist while emulators get it wrong more often than any other
feature. For runs of these lengths the **`wifi/` firmware is the better
harness**. It uses the same watcher, but you upload the hex over HTTP and read
the progress in a browser instead of a tethered terminal.

These are also the numbers to compare against. A run that reaches PASS in
substantially more cycles than the table says did not execute the same path.

`g` accepts an optional cycle cap, for example `g 500000`. Any keypress stops
it.

## Charge retention: measuring the clock's *lower* bound

This CPU uses dynamic NMOS logic. A bit is charge on the capacitance of a wire,
so the clock has a floor as well as a ceiling. If you stop the clock for too
long, the machine forgets its state mid-instruction.

> **SAFETY — read before running `w` or `W`.** Stalling the clock is not a
> read-only experiment. Eric Schlaepfer documents the MOnSter 6502's low-clock
> failure as *"if the clock slows down too much, the latch will change state,
> causing both pullup and pulldown to be turned on"* — **shoot-through, not just
> lost data**. He added protective resistors between pullup and pulldown to
> survive it, which is also what caps his clock speed.
>
> Our 1,018 pull-ups are 10k **resistors**, so those nodes are current-limited to
> 0.5 mA and are safe. But **266 nets have a FET-to-FET path** (a VCC-side FET
> sourcing against pull-down FETs, no series resistance), and only 105 of those
> also carry a 10k pull-up. Each is a **single** pull-up FET against its pull-downs
> — a 1:1 ratio where the die had a weak load — so a contended net draws about
> **262 mA and 0.90 W** (measured, `sim/driver_contention.sp`), well past the
> 220 mA and ~0.3 W a SOT-323 is rated for.
>
> Therefore, before any stall test:
> 1. **Use a current-limited bench supply, set to about 0.5 A. Never USB.** A
>    charger will deliver 3 A into a partially-conducting clock driver; a bench
>    supply folds back. This is the real reason for the bench-supply rule, more
>    than the rail-sag argument.
> 2. **Run the first scans at VCC = 3.3 V**, where the shoot-through current is
>    lower.
> 3. **Start sub-millisecond and ramp**, rather than jumping to `W`'s 4000 ms
>    default.
> 4. **Watch the supply current, not just the pass/fail line.** A rising current
>    during the stall is the signal to stop; the firmware cannot sense it.
>
> Caveat both ways: this is a topology result read out of `gen/netlist.json`, not
> proof that the overlap actually occurs at a stalled clock. It may be harmless.
> But the boards are built, protective resistors are not an option, and the
> mitigations above cost nothing.

**Nobody knows this number, and simulation cannot supply it.**
`tools/dynamic_nodes.py` finds the weakest node: the special-bus bits, 32 pF
against twelve leaking FET channels. Its retention spans three orders of
magnitude with part leakage. A typical 1 nA per FET gives 2.6 ms. The 500 nA
datasheet guardband gives 5.3 µs. `sim/retention.sp` records why ngspice cannot
resolve leakage at that level. Its answer moves 3.5 orders of magnitude with
the solver tolerances, and its leakage falls with temperature when it must
rise. You must therefore measure the number on real copper:

**Both commands take MICROSECONDS** (changed 2026-07-31 from milliseconds — the
change is in the safe direction, since an old `w 5` now stalls 5 µs instead of
5 ms):

```
w 500        # freeze the clock for 500 us. Did the CPU survive?
W            # ramp from 64 us, doubling, then bisect (default ceiling 4 s)
W 20000000   # if it survives 4 s, search further
```

`W` **ramps from 64 µs** rather than opening at a millisecond, so it approaches
the boundary from below instead of starting deep in the hazardous condition.
The bisection stops once the bracket is within about 6% of the answer, which is
all the precision the measurement deserves and saves ~18 trials.

`W` prints output like this:

```
control passed (0 us survives). searching...
        64 us -> survived
       128 us -> survived
       ...
   512.000 ms -> lost
retention boundary: survives 256.000 ms, fails at 512.000 ms
```

The counter image stores an incrementing A to `$0300` on every pass. The test
records one stored value. It then freezes the clock and requires the next store
to be exactly one greater. A forgotten register breaks the sequence. A
forgotten PC stops the stores. `W` runs a **0 µs control first**. If the CPU
cannot survive a stall of zero, the harness is broken and every later number is
meaningless. `W` then stops and reports the fault.

Two limits apply, besides the safety rules above:

- **Both commands reload the counter image**, because they need a known
  program. Upload your own hex again afterwards.
- The clock rests **low** between cycles, so the test measures retention during
  φ1. Retention in the other phase can differ. A test for it needs a half-step
  stall, which the firmware does not implement.

The result has a practical use. It is the hard limit on a single-step pause,
before the step corrupts the state you want to observe.

The **wifi firmware has the same test** in its own panel, with *one shot* and
*find the boundary* buttons. It logs each trial live and gives a stop button.
The measurement runs on core 1 with the bus engine, like everything else that
touches the clock. Core 0 only starts it and reports the result. A scan can
take minutes, so core 1 checks for a stop command between trials.
`common/retention.c` holds the shared implementation.

## Reading the LEDs

The 55 register LEDs sit at their die-true positions inside the transistor
field. There is no room for a silk label at each LED. A measurement found a
pad-free spot for only 3 of the 55, even at 1.0 mm text. Use `gen/led_map.svg`
as the reference. The layout is:

| Register | Column | Order |
|---|---|---|
| Y | x ≈ 60 mm | bit 0 top → bit 7 bottom |
| X | x ≈ 64 mm | bit 0 top → bit 7 bottom |
| S | x ≈ 75 mm | bit 0 top → bit 7 bottom |
| A | x ≈ 145 mm | bit 0 top → bit 7 bottom |
| PCH | x ≈ 164 mm | bit 0 top → bit 7 bottom |
| PCL | x ≈ 190 mm | bit 0 top → bit 7 bottom |

All six register columns span y ≈ 183 mm to 270 mm. The 7 **P status flags** are
not in a row. They sit where the die puts them, in the control-logic band:
`I(197,116) B(212,161) C(216,144) D(223,147) V(238,153) Z(242,161) N(264,144)`.
The two values are x and y in mm from the top-left of the front view.

The default tester image increments A forever. The A column at x ≈ 145 mm must
therefore count in binary. This is the fastest visual proof that the CPU is
alive.

## Clock speed: start slow

The firmware default is a **50 µs half-period**, which is 10 kHz. The project
first targeted 50 kHz. `sim/fanout_speed.sp` found the real ceiling. The
decode-PLA input lines drive up to 71 discrete gates, about 1.9 nF, behind one
10k pull-up. After the pull-down releases, the receiving stage needs about 7 µs
at 5 V to change state, and about 11 µs at 3.3 V. The line needs about 25 µs to
reach a comfortable level. A 50 kHz clock gives only a 10 µs half-cycle. That
is marginal at 5 V and too short at 3.3 V.

At bring-up, start at the default and confirm correct execution. Then increase
the clock with `p` (`p 25` is 20 kHz, `p 10` is 50 kHz) and find where it
fails. Expect decode errors first, because the PLA input lines are the slowest
nets on the board.

## Roadmap

- A PIO bus engine. It is cycle-accurate, faster than bit-banging, and it frees
  the CPU.
- A host-side loader script. The `L` command already accepts pasted Intel hex.
  A script would make overnight functional-test runs unattended.
- Lock-step co-verification against `tools/switchsim.py` traces. This compares
  the board against the golden model during bring-up.
- Address-bus and data-bus LED support, if the optional LEDs are added.
