epatel/discrete6502/initial-idea.md

Recreate this https://monster6502.com/

But maybe try to make it smaller if possible

Using these with as much assembly as possible https://jlcpcb.com/capabilities/pcb-capabilities

Maybe helpful? http://visual6502.org/JSSim/index.html
