epatel/discrete6502/docs/clk0-pulldown.md

# Proposal: a pull-down resistor from CLK0 to VSS

**Status: FITTED AND MEASURED 2026-08-30. The mechanism is confirmed; the SIZING BELOW IS WRONG.**

> **Correction, same day, from hardware.** A 31 kΩ pull-down was fitted and the node measured at
> **0.77 V (board 0.24 A) and 1.76 V (board 2.5 A)** — straddling the 0.8–1.5 V Vgs(th) band, which
> confirms §1 and §2 exactly. But it also shows **25–57 µA is being sourced into that node**, where
> §3 below assumed the only load was two FET gates drawing nothing. At that leak, 47 kΩ would sit at
> ~2.7 V — **fully on, the worst possible outcome** — and 31 kΩ demonstrably does. **Use 4.7 kΩ**:
> 0.12–0.27 V parked, still 2.72 V driven, against a 1.5 V worst-case threshold. 10 kΩ works with
> less margin (0.57 V at the observed leak). §3's table is left as written so the error is visible;
> read this box instead of it. **What sources the 25–57 µA is not yet known** and is question 5.

Origin: [user suggestion, endorsed] recorded in `project-plan.md`'s 2026-08-29 (later) handoff entry.

**The claim being reviewed:** fitting a 10 kΩ (better 47 kΩ) resistor from the `CLK0` bond pad to
`VSS` would hold the board in its ~0.30 A quiet state whenever nothing is driving the clock —
BOOTSEL, reset, power-up before firmware starts, and between firmware loads — which is when every
failure of the evening of 2026-08-29 happened. **A pull-UP would be the worst possible choice**, for
the reason developed below.

This file is self-contained. Every claim states how to check it; nothing needs to be taken from the
plan on trust.

---

## 1. The mechanism, traced rather than asserted

`clk0` reaches the internal clock phase `cclk` through **two inversions**, so the chain is
non-inverting: **the level on `clk0` is the level on `cclk`.**

```mermaid
flowchart LR
  clk0 -->|gate| Q2229 --> n519
  clk0 -->|gate| Q2420 --> n358
  n358 -->|gate| Q536 --> n1129
  n358 -->|gate| Q1175 --> n1467
  n1129 -->|gate Q432 vcc_side| cclk
  n1467 -->|gate Q3504 pulldown| cclk
  cclk -->|gate| P32["32 precharge FETs<br/>adh0-7 adl0-7 idb0-7 sb0-7"]
```

Walk it in both directions (`R219`, `R675` are 10 kΩ pull-ups):

| `clk0` | `n358` | `n1129` | `n1467` | `cclk` | the 32 precharge FETs |
|---|---|---|---|---|---|
| **HIGH** | Q2420 on ⇒ **LOW** | Q536 off, R675 ⇒ **HIGH** | Q2300 on ⇒ **LOW** | Q432 on, Q3504 off ⇒ **HIGH** | **all ON** |
| **LOW** | Q2420 off, R219 ⇒ **HIGH** | Q536 on ⇒ **LOW** | Q1175 on ⇒ **HIGH** | Q432 off, Q3504 on ⇒ **LOW** | **all OFF** |

Reproduce the whole table from the netlist alone:

```bash
python3 - <<'PY'
import json; C = json.load(open("gen/netlist.json"))["components"]
on = lambda n: [c for c in C if n in c["pins"].values()]
for n in ("clk0","n519","n358","n1129","n1467","cclk"):
    print(n, [(c["ref"], c.get("role"), c["pins"]) for c in on(n)])
pre = [c for c in C if c.get("role")=="vcc_side" and c["pins"].get("1")=="cclk"]
print(len(pre), "cclk-gated precharge FETs")
PY
```

It prints **32**, on `adh0-7`, `adl0-7`, `idb0-7`, `sb0-7`. Sixteen of them (`adh`, `adl`) have the
10 kΩ series rework; **`idb0-7` and `sb0-7` do not**, which is the standing hardware fault.

## 1b. THE HOLE IN §1, found 2026-08-30 by experiment

§1 traces `clk0` to `cclk` and stops. **It never traces `cp1`, and `cp1` is the other half of the
clock.** Traced now, from the same netlist:

`clk0` LOW → `n358` HIGH → Q2891 on → `n1715` LOW → Q1537 off → R841 pulls `n1399` HIGH →
Q2482 on → **`cp1` HIGH** (and Q1957 on → `n1105` LOW → Q1705 off, which agrees).

So `clk0` LOW gives **`cclk` LOW *and* `cp1` HIGH** — complementary, as a two-phase clock must be.
`cp1` gates **198 loads**, and in a 6502 φ1 is when the pass gates conduct. So "clk0 low is the
quiet state" was only ever half-established: the half that was checked (32 precharge FETs off) is
right, and the half that was not (198 gates on) may be where the current goes.

**The experiment that exposed this** (`SELFTEST_BUS_ONLY`, three builds, board #1):

| Test | Result |
|---|---|
| Nothing driven, `stdio` only | **91 lines over 45 s — stable** |
| `bus_init(open_drain=true)`: 22 pins to inputs, `clk0` left an input | **8.5 s, 17 prints — healthy** |
| Drive `clk0` LOW, push-pull | **dead in 230 ms** |
| Drive `clk0` LOW for **1 ms**, then release | **dead** |

So one millisecond of *driving* the pin is fatal, while leaving it undriven is indefinitely fine —
even though the undriven node sits at 0.77 V, below the 0.8 V threshold and therefore logically the
same level. **That contradiction is unresolved.** The DC states should be equivalent and the
observed behaviour is not.

Two things this rules out. The Mac is **not** cutting the port — macOS logs show no overcurrent and
no "device disabled" across the whole session. And 1 ms does **not** rule out a sagging rail, as an
earlier version of this note claimed: the Pico carries ~10 µF on VSYS, which at 2.5 A collapses in
microseconds, so a 1 ms current step is more than enough to brown it out.

**Consequence for the firmware:** `pico-controller/selftest/main.c` parks `clk0` LOW on the strength
of §1, and the tester and wifi builds do the same through `bus_init`. If `cp1` HIGH is the expensive
state, **that is backwards** — and it would be the second time the parking polarity has been wrong.
Do not treat either polarity as settled until the ammeter has been read in both.

## 2. Why the polarity matters so much

`clk0` has **no pull-up and no pull-down anywhere on the board.** Its only connections are:

| Part | Role | Note |
|---|---|---|
| `Q2229`, `Q2420` | pull-down FET gates | 2 gates ≈ 54 pF of Ciss, the whole DC load |
| `R1079` 100 R | input protect | `clk0_ext` → `clk0` |
| `D66` / `D67` | clamp to VCC / VSS | 1N4148WS, leakage only |
| `R1107` 1 k | Pico series | `clk0_ext` → `pico_p29` (GP29) |

So the pin floats whenever GP29 is an input — **which includes BOOTSEL, reset, and the whole
interval between power-up and firmware `bus_init()`**. A floating gate drifts, and if it drifts
above the ~1.5 V threshold the table above puts all 32 precharge FETs on at once.

**That is the entire supply problem.** At `sim/driver_contention.sp`'s 262 mA per contended pair,
eight simultaneously is ~2.1 A — the order that folded a 2.4 A charger to 3.6 V at 2.5 A and tripped
a 3 A adapter outright. It also reconciles two figures the plan carried as contradictory for weeks:

- *"clock parked, 0.30 A"* — measured with the Pico fitted, where `bus_init` **drives clk0 low**
- *"clock parked, 2.2 A"* — measured with clk0 **floating**

Same words, opposite pin states, 7× apart.

**Therefore: pull DOWN, never UP.** A pull-up parks `cclk` HIGH and turns all 32 precharge FETs on
permanently — it would guarantee the failure state rather than prevent it.

## 3. Sizing

Node capacitance is ~54 pF of gate plus the `TP25` bond pad (11.6 mm, over planes) and its track —
call it 100–200 pF. Drive is Pico GP29 at 3.3 V through 1.1 kΩ total (`R1107` + `R1079`).

| R | V(clk0) when driven high | Current while high | Decay when released (200 pF) |
|---|---|---|---|
| 10 kΩ | 3.3 × 10/11.1 = **2.97 V** | 297 µA | 2 µs |
| 47 kΩ | 3.3 × 47/48.1 = **3.22 V** | 69 µA | 9.4 µs |

Both leave the high level far above the 0.8–1.5 V threshold, and both are orders of magnitude faster
than the 400 µs low phase. **47 kΩ is the better choice** — it gives up almost nothing on the high
level and still slews in microseconds. 10 kΩ is acceptable and is what is already in the BOM.

Neither loads the Pico meaningfully (GP29 is rated 12 mA).

## 4. Where to fit it — and this is the part most worth reviewing

**Option A — `TP25` → `TP35`, i.e. the bond pads.** Croc clips onto two 11.6 mm pads, no soldering,
instantly reversible. **But they are on opposite edges of the board**: `TP25` (Φ0) is at
x 234.06, y 7.05 and `TP35` (VSS) at x 130.20, y 314.95 — **about 308 mm apart on a 322 mm board.**
There is exactly one VSS pad in the whole 36-pad ring, so this cannot be shortened.

**Option B — on the Pico side of the series resistors**, i.e. from `R1107`'s `pico_p29` pad to any
nearby VSS (a back-side decoupling pad). This is **electrically strictly better**: the pull-down sits
on the *driver* side of the 1.1 kΩ, so when GP29 drives high there is no DC path through the series
resistors and `clk0` sees the full 3.3 V with **no divider loss at all**, while a floating GP29 is
still pulled to VSS and takes `clk0` with it. Cost is 0402-scale soldering beside the Pico instead of
two croc clips.

**Recommendation: Option A with 47 kΩ for the bench, now.** The wire carries ~70 µA at ~2.3 kHz, so
its length is not a signal-integrity problem, and the value of the change is that it works when
nothing else is powered — which argues for the version that needs no soldering. Option B is the
right answer if this becomes permanent.

## 5. What this does *not* fix

- **It is not a fix for the 16 un-reworked precharge sites** (`idb0-7`, `sb0-7`). Those still contend
  whenever the clock is genuinely high, which is most of what a running board does. The pull-down
  only removes the *undriven* failure mode.
- **It does not preserve CPU state.** Parked low, the dynamic nodes decay in ~1.13 ms (measured,
  board #1, 2026-08-24). That is fine — nothing is running when nothing drives the clock.
- **The 2.1 A figure is directional, not exact.** It assumes eight pairs each at the simulated
  262 mA. Whether all eight (or sixteen) contend simultaneously at DC depends on the state of their
  pull-downs, which is undefined on an unclocked board. The *direction* is certain; the magnitude is
  an estimate.

## 6. Questions for the reviewer

1. Is the two-inversion trace in §1 right? It is the load-bearing claim, and it is derived from
   `gen/netlist.json` only — no simulation was run to confirm the DC levels.
2. Is there a reason to prefer 10 kΩ over 47 kΩ that the table in §3 misses — noise pickup on a
   308 mm wire, say, at a node whose only load is two FET gates?
3. Option A vs Option B: is the divider loss (3.3 → 2.97 V at 10 kΩ) worth any concern at all given
   Vgs(th) is 0.8–1.5 V, or is the convenience argument decisive?
4. Anything in `D66`/`D67` (the clamp pair) that a permanent DC path to VSS interacts with badly?
5. **What sources 25–57 µA into `clk0`?** Two FET gates draw no DC current and the clamp diodes leak
   nanoamps, so this was not predicted. Candidates: an internal pull-up on the Pico's GP pin (a
   ~30 kΩ pull-up through `R1107`'s 1 kΩ fits the arithmetic closely), or the meter reading the mean
   of a driven clock rather than a DC level. **A scope on TP25 settles it** — a flat 1.76 V is one
   answer, a 3.3 V square wave is quite another, and they call for opposite fixes.

## Sources

- `gen/netlist.json` — every part and net named above; the snippet in §1 regenerates the trace.
- `navigator/data/board.json` — the pad positions in mm (or query the navigator: `navctl.py part TP25`).
- `project-plan.md`, handoff 2026-08-29 (later) — where the finding and the suggestion are recorded.
- `cards/driver-contention.md` — the 262 mA figure, its provenance, and both of its retractions.
- `sim/driver_contention.sp`, `sim/fanout_speed.sp` — the contention current and the ~25 µs settling bound.
