epatel/discrete6502/docs/adl7-stuck-marked.jpg

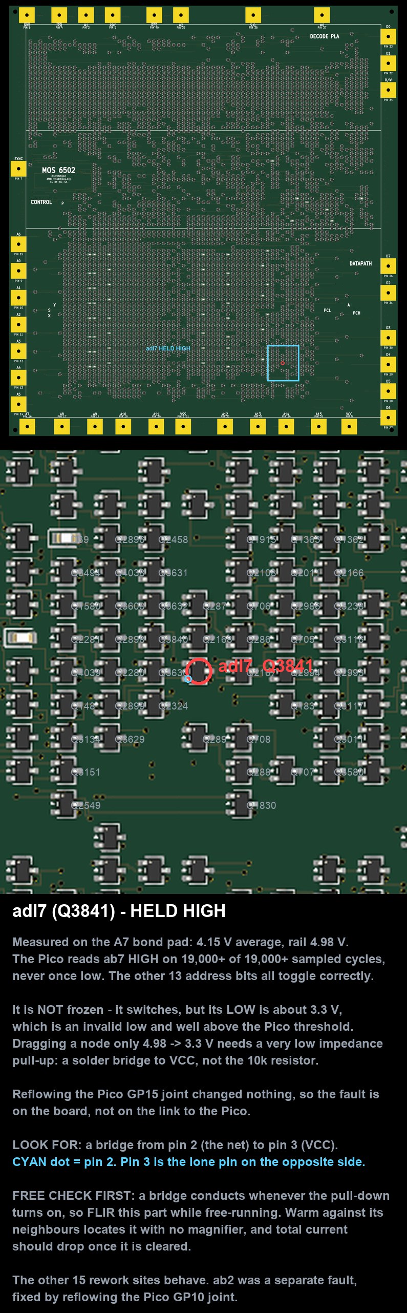
docs/adl7-stuck-marked.jpg
