epatel/discrete6502/docs/cclk-bridge-check.jpg

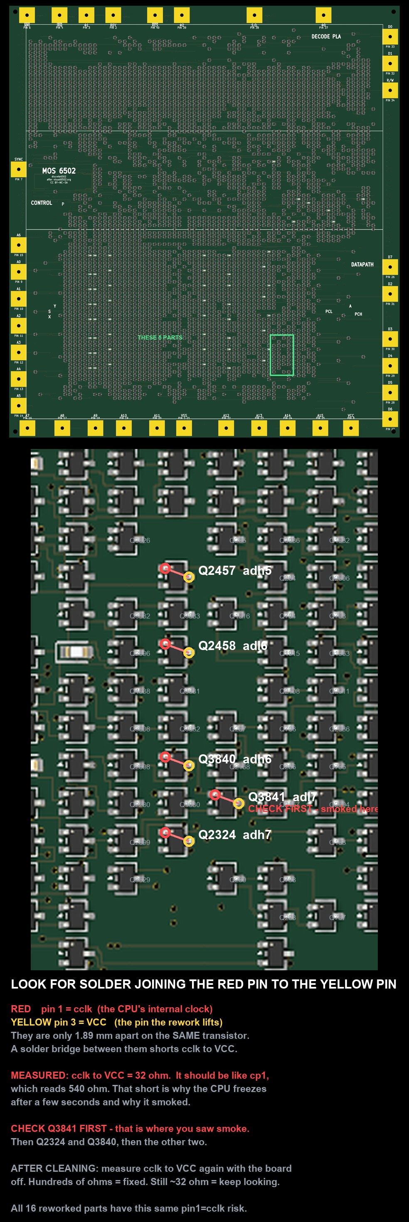
docs/cclk-bridge-check.jpg
