epatel/discrete6502/docs/hotsites-marked.jpg

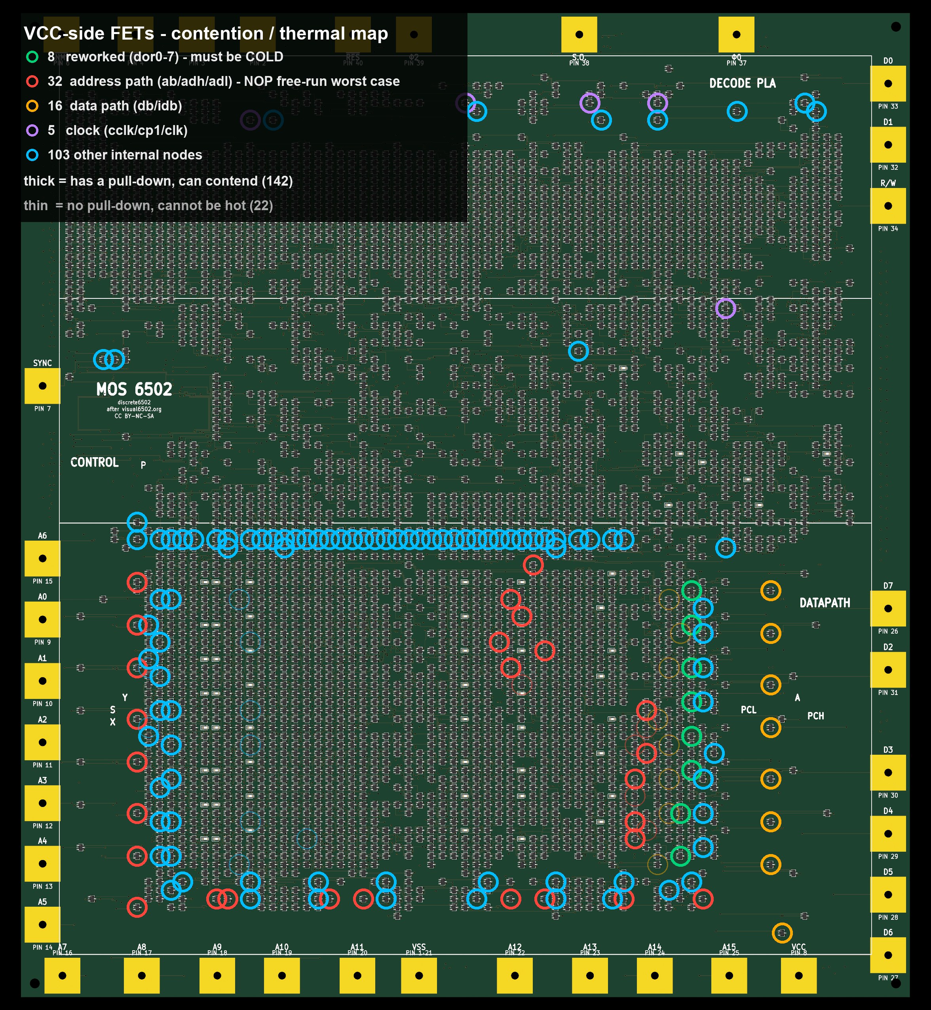
docs/hotsites-marked.jpg
