epatel/discrete6502/docs/img/detail-texture.jpg

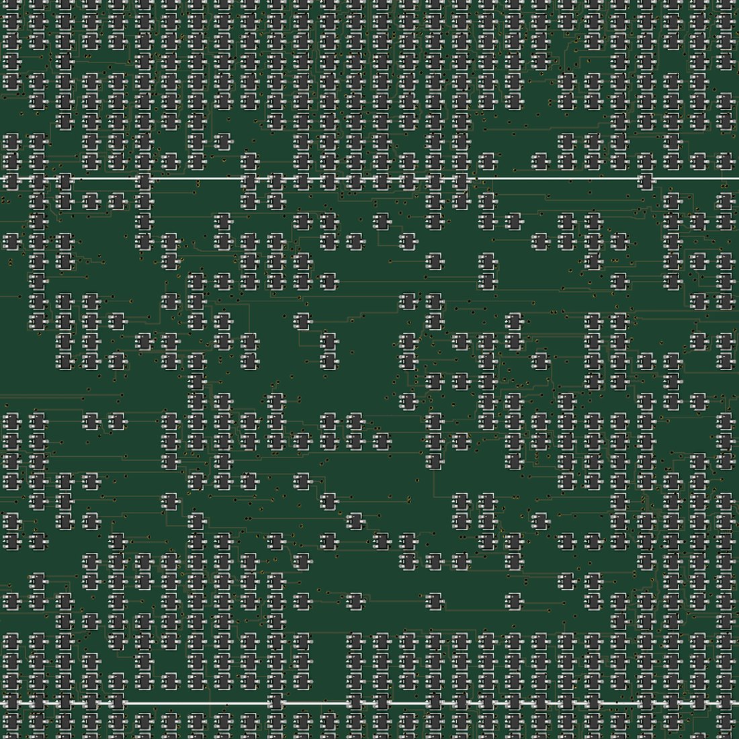
docs/img/detail-texture.jpg
