epatel/discrete6502/docs/img/die-vec.webp

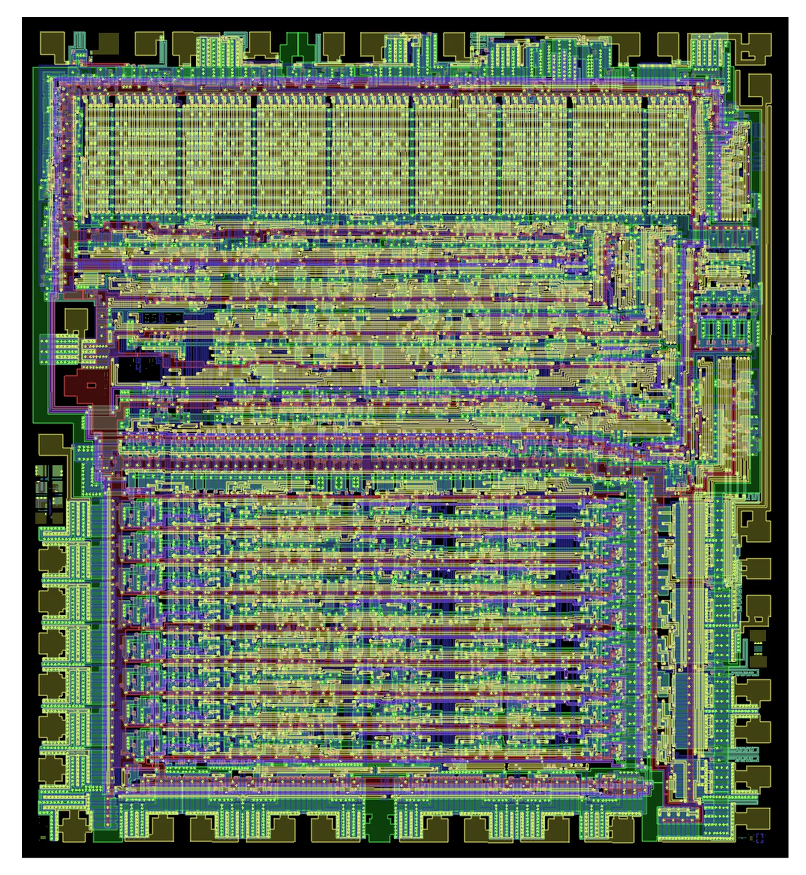
docs/img/die-vec.webp
