epatel/discrete6502/docs/img/og-card.jpg

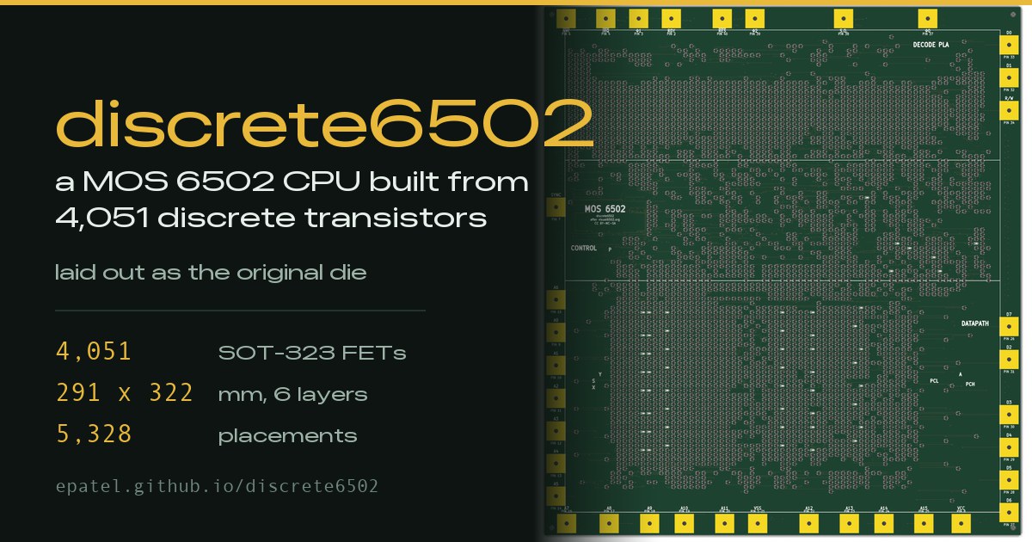
docs/img/og-card.jpg
