epatel/discrete6502/docs/img/rework-adh-sites.jpg

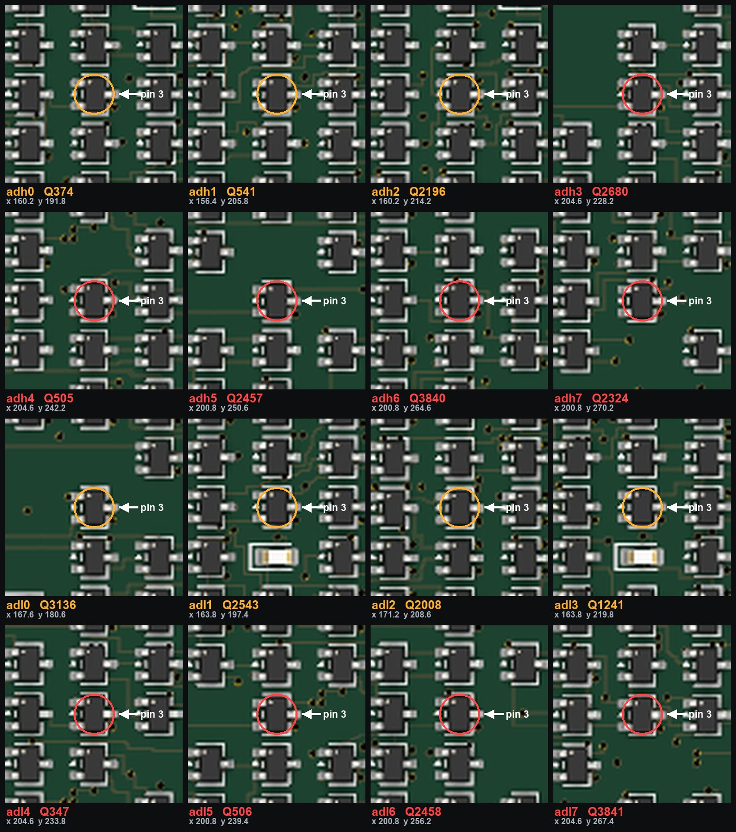
docs/img/rework-adh-sites.jpg
