epatel/discrete6502/docs/img/running-leds.jpg

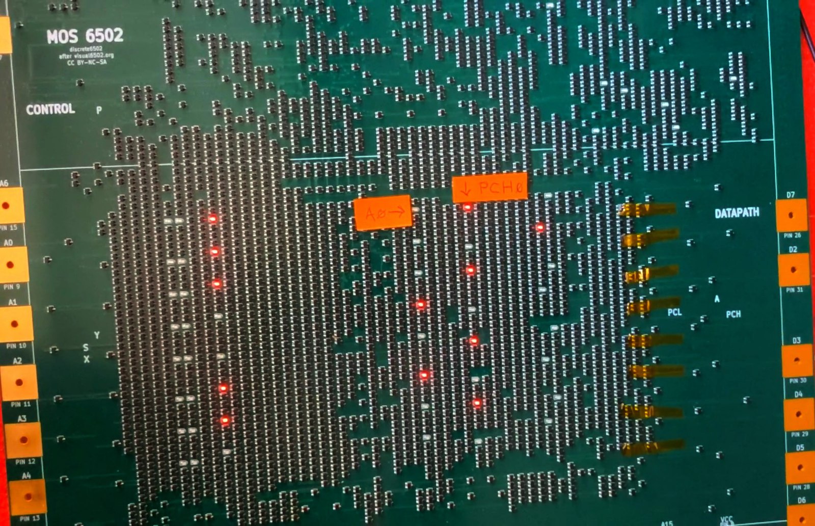
docs/img/running-leds.jpg
