epatel/discrete6502/docs/precharge-rework-idb-sb.jpg

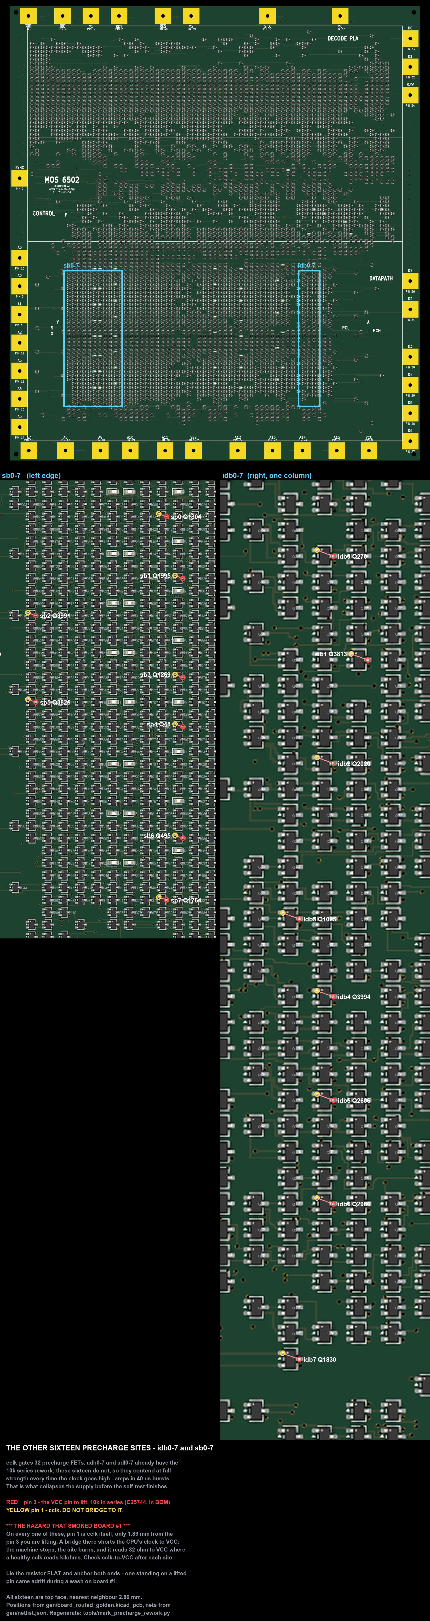
docs/precharge-rework-idb-sb.jpg
