epatel/discrete6502/docs/probe-cclk-cp1.jpg

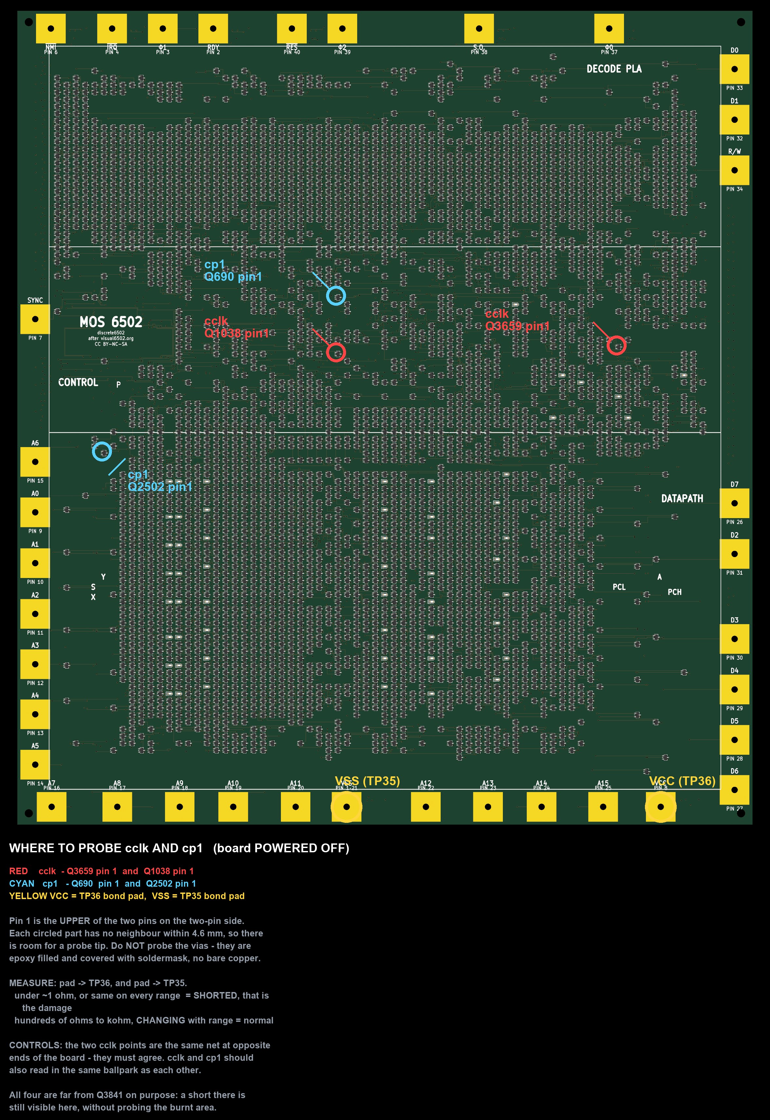
docs/probe-cclk-cp1.jpg
