epatel/discrete6502/docs/q289-vs-q3841.jpg

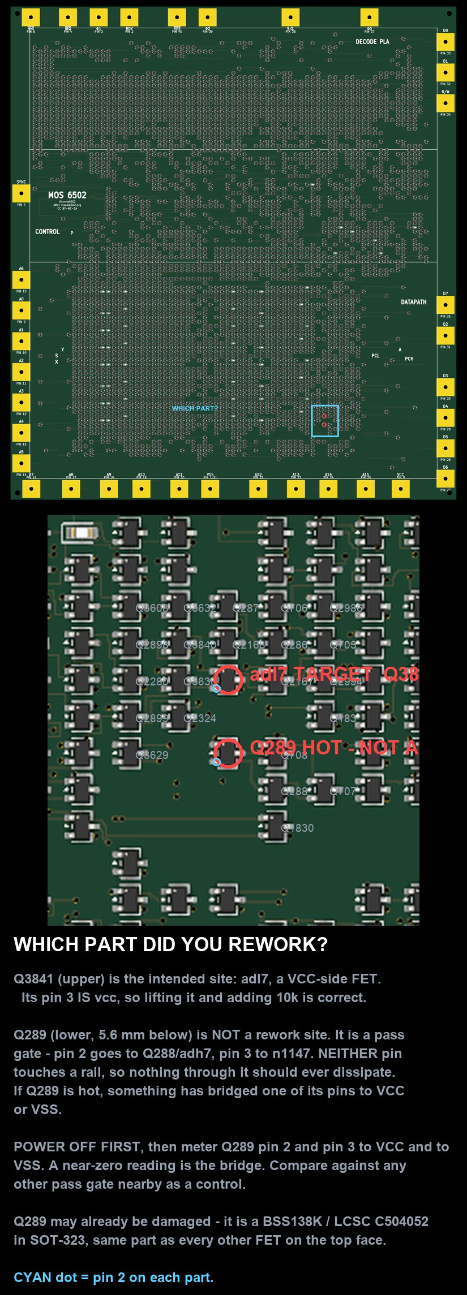
docs/q289-vs-q3841.jpg
