epatel/discrete6502/docs/q2577-transplant.jpg

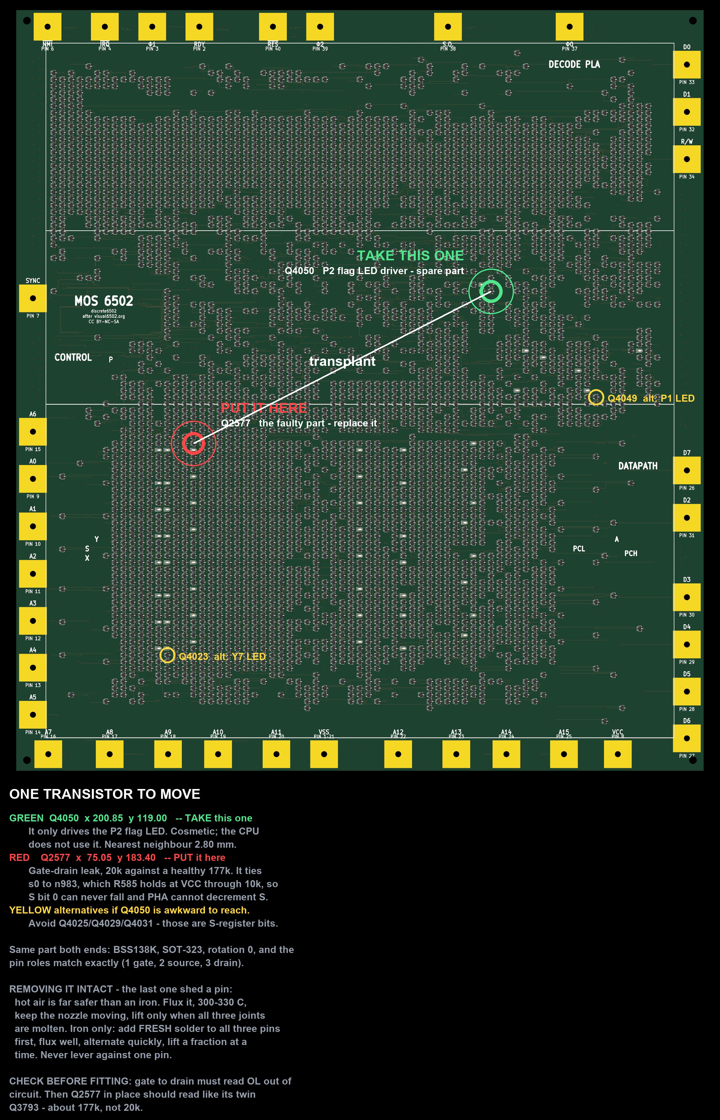
docs/q2577-transplant.jpg
