epatel/discrete6502/docs/rework-8-sites-marked.jpg

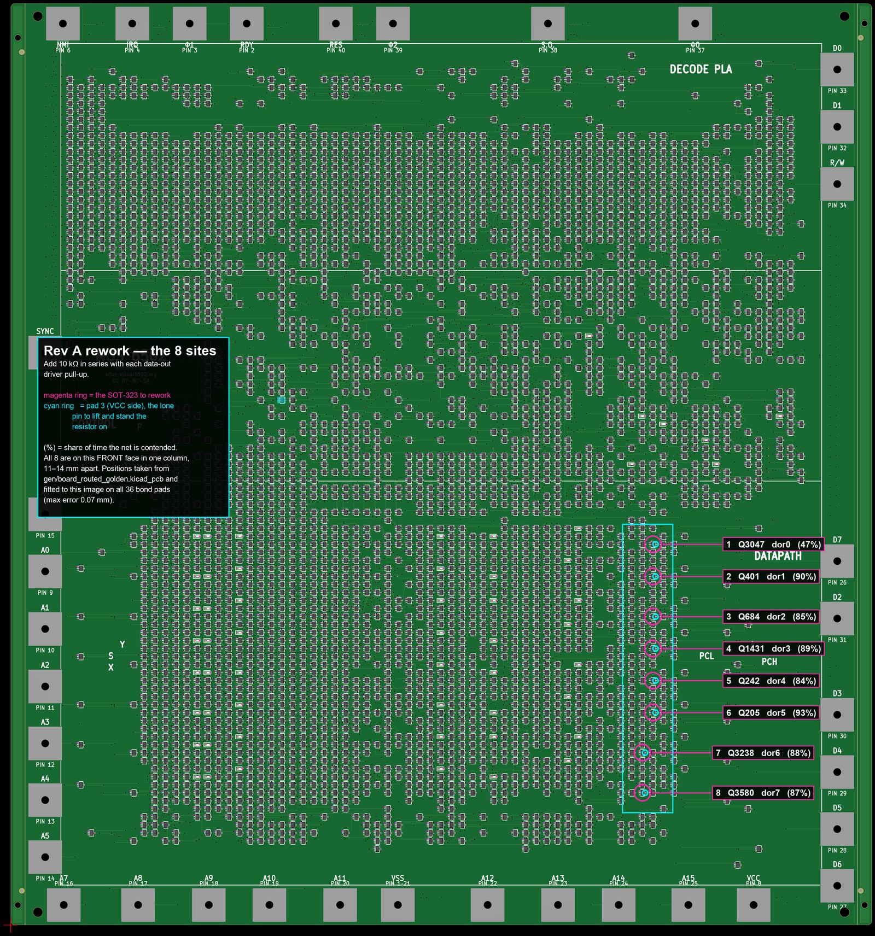
docs/rework-8-sites-marked.jpg
