epatel/discrete6502/docs/rework-adh-marked copy.jpeg

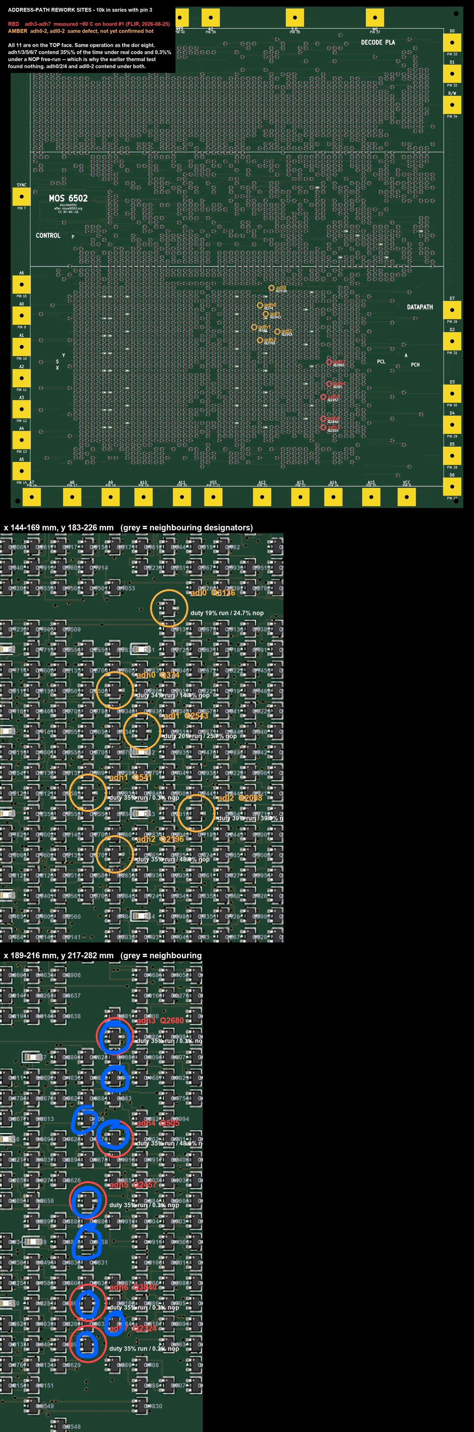
docs/rework-adh-marked copy.jpeg
