epatel/discrete6502/docs/rework-precharge-marked.jpg

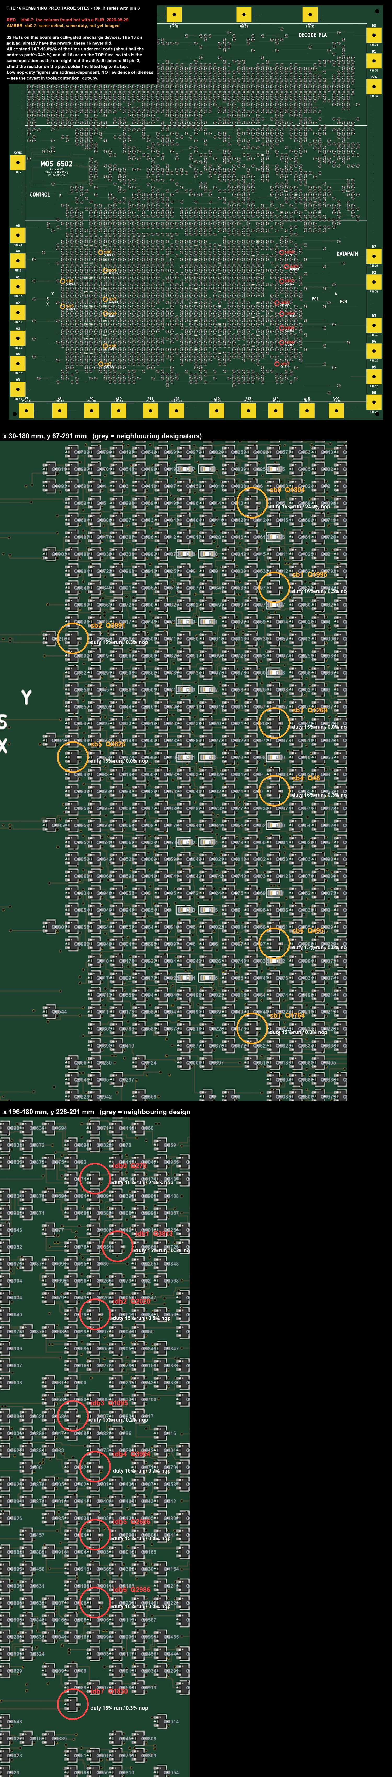
docs/rework-precharge-marked.jpg
