epatel/discrete6502/docs/s0-stuck-probe-map.jpg

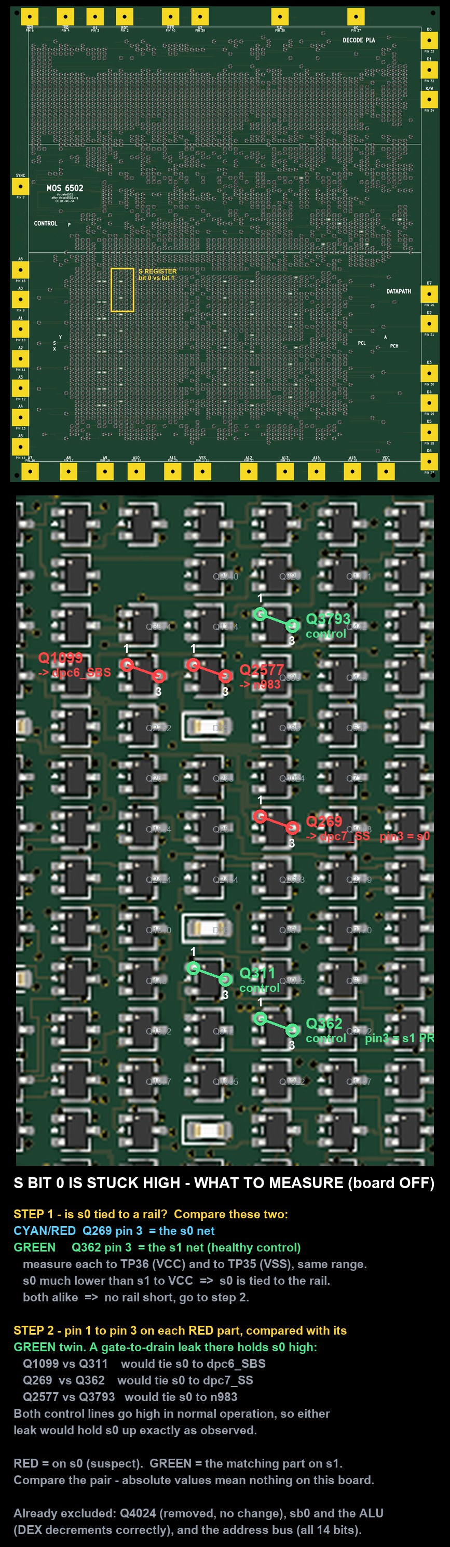
docs/s0-stuck-probe-map.jpg
