epatel/discrete6502/docs/stack-sites-marked.jpg

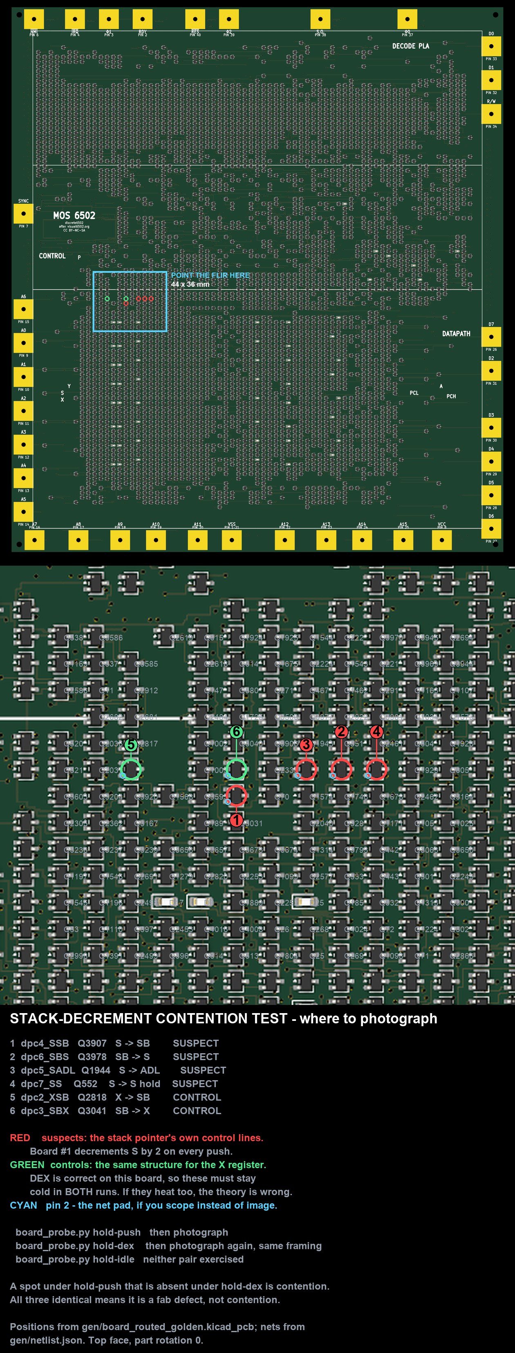
docs/stack-sites-marked.jpg
