epatel/discrete6502/cards/verification.md

# verification

How the transformed discrete netlist is proven correct — the switch-level equivalence harness, its results, and the analog vendor-model findings (M4, 2026-07-18).

**Switch-level equivalence** — `tools/switchsim.py` implements the visual6502/perfect6502 algorithm (conduction-group BFS; value priority vss > vcc > pulldown > pullup > "floating group is high if any member held charge") and runs the *same* 6502 program on both the original visual6502 netlist and `gen/netlist.json`, behind the same memory harness. Results: after the reset sequence flushes arbitrary initial charge (~20 half-cycles), traces (buses, rw, sync, A, X, PC) are **identical for the full run**, and a program exercising stack, JSR/RTS, ADC with carry, DEX/BNE looping, and PHA/PLA completes with correct state on both (A=$20, X=0, stores verified). Runtime ~1s. Pitfalls encoded in the code, learned the hard way:

- Group value resolution must be deterministic and prioritized (pulldown before pullup); early-returning on the first flag found in set order silently corrupts ALU results.
- A floating group reads high if *any* member was high (perfect6502 rule) — majority voting breaks DEX and friends.
- Memory harness order matters: service reads after driving clk low, capture writes after driving clk high; capturing on both halves writes garbage at transient addresses.

Extend the test by editing `TEST_PROGRAM`; any new netlist transform must keep this equivalence green.

**Analog verification with the manufacturer model** — `sim/2N7002_onsemi.lib` (onsemi BSIM3v3 subckt `F2N7002`, pins D G S; needs `set ngbehavior=psa`, provided by `sim/.spiceinit`). Testbench `sim/passpair_vendor.sp`: driver inverter → pass pair → 20pF bus → pass pair → 5pF storage node with LED-tap load → output inverter.

- **Source-driven transfers work for both levels**, even through a 4-FET series chain: stored '1' ≈ 5.1V (bootstrap-assisted, no threshold drop), stored '0' ≈ −1.6V, output inverter levels clean.
- **Writing '0' between two floating islands fails**: the clock edge injects gate-capacitance charge into the island (observed: −1.1V → +3.4V jump), starving both FETs of Vgs so the pair never conducts. Root cause: discrete gate caps (~30pF) rival node caps, inverting the die's Cnode >> Cgate hierarchy.
- Why this is acceptable: the 6502 never relies on floating-to-floating '0' transfer — buses are precharged high and conditionally discharged through driven pull-down paths, which is exactly what the golden model's "floating = high if any member high" rule encodes. The switch-level equivalence run passing under that rule is the logical-side evidence.
- Insurance for layout (M5): reserve DNP ballast-capacitor footprints (~100–220pF) on the main bus nets so the capacitance hierarchy can be restored at bring-up if edge injection misbehaves in reality. **Done** — 56 DNP 100pF 0402 sites are on the board, ready to hand-populate at bring-up.

**Board-level checks (M5, all green on the golden board):** `tools/check_parity.py` (5,421 components, board vs. netlist, 0 errors), `tools/check_gaps.py` (independent union-find over copper — the *only* trusted connectivity metric; 0 broken connections) and `kicad-cli pcb drc` (0 electrical violations; exactly 2 benign items internal to the Pico library footprint). Any board change must re-pass all three.

**Reverse validation — the netlist read back out of the copper** (`tools/extract_netlist.py`, 2026-07-27). Every gate above reads *forwards* and ultimately trusts KiCad's net bookkeeping: `check_parity` compares pad net labels to the netlist, and `check_gaps` groups copper **by KiCad's net codes** before asking whether each intended net is connected — and it never looks at zones at all, so the GND/VCC planes were covered only by KiCad's own unconnected count. This tool discards every net label and unions copper purely geometrically — pads, tracks, vias **and zone fill polygons**, with exact `SHAPE::Collide` — to recover the conductors that physically exist, then reports LVS in both directions and emits `gen/extracted_netlist.json` for `switchsim.py`'s third loader (`load_extracted`).

Results on the golden board: **2,639 conductors, 0 opens, 0 shorts, 0 unmapped pads**; 4,051 FETs and 1,078 pull-up conductors recovered; the VCC rail identified *from copper alone* (the conductor touched by 1,078 resistor pads) agreeing with the zone labels. The extracted netlist then runs the 6502 test program and matches the original visual6502 trace for half-cycles 28..219 — **the copper, read as copper, executes 6502 instructions**. Runtime ~85 s extraction, ~1 s simulation.

- **Negative controls, as a tool** — `tools/test_extract.py` (KiCad python, ~4 min). Builds damaged copies of the golden board in a temp dir and requires the extractor to notice: **clean** → 0/0, **cut** (longest track removed, `ab8`, 162 mm) → ≥1 OPEN, **bridge** (two adjacent pads joined) → ≥1 SHORT. All three PASS. Two things it taught: (a) deleting an *arbitrary* track often changes nothing — the router emits chains of short collinear segments and the neighbours still overlap across the gap, so the victim must be the longest segment; (b) each board edit needs its **own process**, because a second `LoadBoard` in a process that has already loaded and saved one returns a bare `SwigPyObject` instead of a `BOARD` (same fragility that splits `add_silk.py`). The bridge case reports `cp1 + pipeT4out + vss` — a *three-way* short, because it also clipped a VSS pad and the extractor traced it through that pad's stitching via into the ground plane; that transitive path through a zone is precisely what the forward gates cannot see.
- **Traps that cost a debug cycle each:** (a) KiCad's copper layer IDs are **not in stack order** (`[0,4,6,8,10,2]` — B_Cu is 2), so slicing a via's span out of the *numeric* range gives it only F and B; slice out of `GetEnabledLayers().CuStack()` instead (symptom: 1,153 phantom opens). (b) `board.Zones()` returns **new wrappers every call**, so keying anything on `id(z)` matches only by accidental address reuse — it silently dropped an entire plane (symptom: VCC split into 1,350 conductors). (c) Running the tool on a non-golden board must not overwrite the canonical artifact; it now suffixes the filename instead.
- **What this still assumes, because copper cannot show it:** pad number → device terminal (pad 1 of a SOT-323 is the gate) comes from the footprint library the generator also used; component *values* are invisible (10k and 100k are the same copper — switch-level does not need them, so this proves topology, not values); and the ~82 harness pin names are anchored from `gen/netlist.json` by `(ref, pad)` — the other ~2,600 nets are never consulted.
- The extracted netlist carries 55 spurious pull-ups (the LED ballast resistors also hang off VCC). They sit on LED anode nodes that nothing reads, so they are harmless — visible only as a slightly longer settling window (28 half-cycles vs the transformed netlist's 20).

**Structural blind spot — ratio errors (found 2026-08-01).** `switchsim._value()` returns low
whenever `vss` is in the conducting group: it *assumes* the pull-down wins any contention. The
gate is therefore incapable of seeing a **ratio** error, only a topology error. That is how a
1:1 pull-up/pull-down ratio on the eight data-out drivers survived five green gates — see
"Driver contention" in `project-plan.md` and `sim/driver_contention.sp`. Any future claim that
"switchsim is green" should be read as *the topology is right*, never as *the levels are right*.

**The blind spot's practical rule: a ratio change needs a SPICE deck, not a green gate.**
`sim/revb_driver.sp` (2026-08-01) is what that looks like for rev B — the same two-stage chain
taken out of `gen/netlist.json` (`dor1 → Q401 → n798 → Q192 → db1`, the worst-measured contender)
simulated as rev A and rev B side by side, at both rails and at typical *and* datasheet-max Vth.
It confirms the fix on the numbers switchsim cannot produce: contention current 262 mA → 0.5 mA,
contended level 1.86 V → 2.9 mV, rise 18 ns → 271 ns against a 25 µs budget, fall unchanged. Two
things it found that reasoning had not: rev B's high levels come out *higher* than rev A's (the
10k keeps bootstrap charge that rev A's stiff VCC drain dumps back into the supply), and the
**two 100R sites (`cclk`, `cp1`) dissipate 200 mW in an 0402 rated 0.0625 W while contended** —
harmless at ~4% duty, a real limit if the clock is ever stopped with `cclk` contended. It also
carries a **rev A worst-Vth chain purely so the comparison stays fair**, which is what showed the
3.3 V marginality is pre-existing rather than caused by rev B.

**Closed 2026-07-25:** the pass pair was SPICEd at VCC = 3.3 V — see `cards/pass-pair-validation.md`. 3.3 V is now a diagnostic fallback rather than the first bring-up rail (`pico-controller/README.md`).
