epatel/discrete6502/cards/pass-pair-validation.md

# pass-pair-validation

Decision + evidence: NMOS transmission gates are implemented as back-to-back 3-terminal MOSFET pairs; validated by SPICE on a 6502-style dynamic latch (2026-07-18).

Decision: every bidirectional pass transistor in the netlist becomes two identical N-MOSFETs in series — drains facing outward, common source/body node in the middle, both gates on the clock signal. No 4-terminal FETs or array chips anywhere in the design. Ordinary pull-downs stay single FETs; depletion pull-ups become 10k resistors (ratioed NMOS logic, 5V supply).

Evidence — `sim/passpair_latch.sp` (ngspice, VDMOS models): a full latch chain (ratioed driver inverter → pass pair → floating storage node → output inverter) simulated at 6502-like clocking for three candidates:

| FET (model approx.) | stored '1' | stored '0' | output low | output high |
|---|---|---|---|---|
| BSS138 (Vto 1.1V) | 6.06 V | −0.23 V | 1.3 mV | 5.00 V |
| 2N7002 worst (Vto 2.4V) | 6.05 V | −0.36 V | 1.5 mV | 5.00 V |
| AO3400A (Vto 0.9V, Ciss≈1nF) | 6.83 V | −0.42 V | 37 µV | 5.00 V |

Key findings:

- **Clock-edge bootstrap over-charges the stored '1' above VDD** (~6V): the floating common-source node couples up on clock edges through the two gate capacitances and rectifies charge into the storage node through the pair's body diodes. This *eliminates the classic pass-gate threshold drop* — even a worst-case Vto=2.4V 2N7002 stores a robust '1'. Result held from 5pF to 50pF storage-node loading. Caveat: this mechanism is doing load-bearing work; it must be re-verified with manufacturer SPICE models (the VDMOS models here are hand-approximated from datasheet values) and on other 6502 circuit topologies (series pass-gate chains, clock drivers, register file) before layout.
- **Retention** is a non-issue at 50 kHz: droop over a 25µs hold was <2mV.
- **Speed** rules out high-capacitance FETs: node rise time ≈ 2.2·R_pullup·C_node. At 10k, 2N7002/BSS138-class (~30pF) gives ~0.3µs (fine to a few hundred kHz); AO3400A (~1nF) gives ~10µs (too slow). Choose FETs by *low Ciss*, not low Rds_on.

Part selection (JLCPCB, checked 2026-07-18): primary FET **2N7002, part C8545** — basic library, SOT-23, huge stock, cheapest available; fallback **BSS138, C52895** if lower Vto proves necessary with real vendor models. Pull-ups: 10kΩ 0402 (basic). Power estimate at 10k pull-ups: ~half of 1,018 pulled-up nodes low at any time → ~0.25 A / ~1.3 W core power (vs. MOnSter's ~10 W incl. LEDs). A SOT-323/SOT-723 2N7002 variant (extended part, one-time reel fee only) is the lever for shrinking the board.

Board-size target derived from this: ~4,022 FETs + ~1,018 resistors, double-sided assembly, 4 layers → roughly 225×225 mm with SOT-23, ~180×185 mm with SOT-323. Target: **fit within 200×250 mm** (about half the MOnSter's 305×380 mm footprint).

**Superseded by later decisions (this section is the M2 record, kept for the reasoning):**
the part is now **BSS138W, LCSC C504052, SOT-323** (the fallback above, chosen at order time —
2N7002W was out of stock); the board is **290.7 × 322 mm, 6 layers**, deliberately larger than
the packing minimum because the die-mimicry directive requires preserving the die's empty space.
~~The power estimate held: measured-by-calculation ≈ 1.4–1.5 W at 5 V (see README).~~
**Wrong, corrected 2026-08-01: ≈ 10 W as built.** That estimate counted pull-up resistors, LEDs
and switching but not **driver contention** — eight data-bus output drivers burn 262 mA each
because their VCC-side FET is the same BSS138W as the pull-down it fights. See "Driver
contention" in `project-plan.md` and `sim/driver_contention.sp`. The rework restores ≈ 1.6 W.

## 3.3 V validation (2026-07-25) — `sim/passpair_33v.sp`

3.3 V operation was originally planned as the *first* power-up (one supply domain with the Pico),
so the bootstrap was re-checked at that rail. **Superseded 2026-07-28** — bring-up now starts at
5 V with no Pico fitted, and 3.3 V is a diagnostic fallback (rationale in
`pico-controller/README.md`); the simulation results below are unchanged and still gate the
fallback. Same worst-path topology as the M4 vendor bench
(driver → pass pair → 20 pF bus → pass pair → 5 pF storage node + LED tap → output inverter),
three FET flavours in parallel — onsemi vendor 2N7002 BSIM3v3 (pessimistic Vth), BSS138 typical
(Vto 1.1), BSS138W worst case (Vto 1.5) — swept over 5.0 / 3.3 / 3.0 V by `alterparam`.

| Measurement (vendor model — the pessimistic one) | 5.0 V | 3.3 V | 3.0 V |
|---|---|---|---|
| Stored '1' after transfer, held 13 µs | 5.17 V | 3.39 V | 3.08 V |
| … as a fraction of the rail | 1.035× | 1.027× | 1.027× |
| Next-stage output driven low by that '1' | 0.9 mV | 1.0 mV | 1.2 mV |
| Source-driven '0' through a pass pair | −1.11 V | −1.09 V | −1.08 V |
| 10k pull-up recovery (10→90%) | 1.10 µs | 1.31 µs | 1.36 µs |

**All four pass gates in the deck pass at every rail, including 3.0 V.** The bootstrap is not a
5 V-only effect: it over-charges the storage node slightly *above* the rail at 3.3 V too, so the
classic pass-gate threshold drop stays cancelled and the next stage sees full overdrive
(1.4 V over Vth on the vendor model, 2.7 V on BSS138W worst case — the ordered part is the
*better* case here, which is why its lower Vth was welcome). Pull-up recovery slows only 19% at
3.3 V (1.3 µs), so a 50 kHz clock (10 µs half-cycle) still has ~7× margin.

Known non-regression: writing '0' from one *floating* island to another still fails at 3.3 V
exactly as it does at 5 V (the M4 finding) — the storage node holds ~2.6 V instead of going low.
This is the documented, accepted limitation; the 6502 never relies on floating-to-floating '0'
transfer, and the switch-level equivalence run is the logic-side evidence. The 56 DNP ballast
caps exist as the hardware fallback if reality disagrees.

## Clock floor — the other end of the window (2026-07-27)

Dynamic logic is bounded on *both* sides: a stored bit is charge, so refresh it too late and it is gone. `tools/dynamic_nodes.py` finds the worst node from `gen/netlist.json` and `sim/retention.sp` tests the physics.

- **456 dynamic storage nodes** (no pull-up, drives at least one gate). The worst are the internal special-bus bits **`sb1..sb7`**: one gate driven (32 pF including copper) against **twelve** FET channel terminals leaking it. Least charge per leakage path on the board. Counter-intuitively the *big* nets are the safe ones — `cclk` holds 13 nF against 2 channels and survives ~259 ms.
- Retention is `t = C·ΔV/I`, **confirmed exactly** by `sim/retention.sp` section C (12 nA on 32 pF: predicted 4.625 V at 1 ms and 4.000 V at 2.67 ms; measured 4.62500 and 3.99875).
- The unknown is the leakage, and it spans three orders:

| per-FET I_DSS | worst-node retention | clock floor |
|---|---|---|
| 1 nA (typical part) | 2.6 ms | 378 Hz |
| 10 nA | 266 µs | 3.8 kHz |
| 100 nA | 26.7 µs | 37.5 kHz |
| 500 nA (datasheet max) | 5.3 µs | **187 kHz** |

- **The number that decides it:** at the measured 20 kHz ceiling the worst node must leak **< 53 nA per FET** (5 V), or < 27 nA at 3.3 V. Above that the floor rises through the ceiling and there is *no working clock at all*. Typical parts are ~1 nA, so expected margin is ~50×, i.e. about 57 °C of temperature rise before the window closes (leakage roughly doubles per 10 °C).
- **SPICE could not pin the leakage down, and the deck says so.** ngspice with the onsemi BSIM3 model does not converge reliably at tens of picoamps: the answer moves 3.5 orders with solver tolerances (0.49 nA at defaults, 2.3 µA with `abstol`/`gmin` tightened, "source stepping failed"), and the temperature control comes out **non-monotonic — leakage *falling* as the part heats**, which is physically impossible and is the tell that it is solver artifact. ngspice's default `gmin` alone injects 5 pA per node at 5 V, the same order as the quantity. The deck keeps that control visible rather than quoting a number from it.
- **Therefore: measure it at bring-up.** Two-line experiment with the existing firmware — run a program, stop the clock for N ms, restart, see whether the CPU carries on or has forgotten itself; bisect N. That is the real number on the real board, and it also directly bounds how long the tester's single-step pause may last.

## Clock ceiling is set by fanout, not by the pass pairs — `sim/fanout_speed.sp` (2026-07-25)

The M2 speed rule (`rise ≈ 2.2·R·C` = 0.3 µs at 10k/30pF) silently assumed a node driving
**one** gate. Real fanout, extracted from `gen/netlist.json` (gate pads per net × 27 pF Ciss):

| net | gates | C | pulled up by | 10–90% rise |
|---|---|---|---|---|
| `cclk` | 482 | 13.0 nF | vcc_side FET (source follower) | fast — FET sources ~100 mA |
| `cp1` | 198 | 5.4 nF | vcc_side FET | fast |
| `ir2` | 71 | 1.9 nF | **10 kΩ resistor** | **43 µs** |
| `ir4` | 69 | 1.9 nF | 10 kΩ resistor | 41 µs |
| `irline3` | 63 | 1.7 nF | 10 kΩ resistor | 37 µs |

Of 760 resistor-pulled nets, 17 rise slower than 10 µs and 2 slower than 40 µs — all of them
decode-PLA input lines, exactly where you would expect the fanout to concentrate. The big
clock nets are fine because the transform gave them FET pull-ups (`vcc_side`), not resistors.

Simulated with a receiving stage on the far end, the functional numbers are better than the
10–90% figure suggests, because the receiver flips as soon as the line crosses its threshold:

| | 5.0 V | 3.3 V |
|---|---|---|
| Worst line (1.9 nF): delay until receiving stage flips | 7.0 µs | 11.4 µs |
| Worst line: level reached 10 µs after release | 1.98 V | 1.31 V |
| Worst line: level reached 25 µs after release | 3.60 V | 2.37 V |
| Median net (27 pF): delay until receiver flips | 0.32 µs | 0.48 µs |

**Consequence: the ≥50 kHz target from M2 is optimistic.** A 50 kHz clock gives a 10 µs
half-cycle — marginal at 5 V, insufficient at 3.3 V. A realistic figure is **~20 kHz at 5 V**
(25 µs half-cycle, ~3.5× margin) and **~10 kHz at 3.3 V**. The bring-up firmware default was
changed to a 50 µs half-period (10 kHz) accordingly; the `p` command walks it up so the real
ceiling can be measured rather than guessed. Expect *decode* errors first when it breaks.

Levers if more speed is ever wanted: smaller pull-ups on the ~17 slow nets (costs static power,
6.8k would buy ~30%), or a lower-Ciss FET. Neither is worth a respin — the MOnSter 6502 itself
tops out at ~50 kHz with lower-capacitance array transistors.

## LED tap brightness vs rail — `sim/led_tap.sp` (2026-07-25)

The only practical 3.3 V caveat, and it is not a logic problem. Deck models the real topology
(VCC → 2.2 kΩ → red 0603 LED → tap FET → GND) with a diode fitted to Vf ≈ 1.90 V at 2 mA;
the tap FET's saturation voltage turns out to be negligible (2–4 mV), so brightness is set
entirely by (VCC − Vf)/2.2 kΩ.

| VCC | LED current | LED Vf | vs 5 V | perceived (∝ I^⅓) |
|---|---|---|---|---|
| 5.0 V | 1.42 mA | 1.88 V | 100% | 100% |
| 3.3 V | 0.67 mA | 1.83 V | 47% | ~78% |
| 3.0 V | 0.54 mA | 1.82 V | 38% | ~72% |

So the 3.3 V bring-up loses over half the LED *current* but only about a fifth of the apparent
brightness — dim, clearly readable, not a fault. Nothing can be done about it without reworking
the 2.2 kΩ ballasts, and it is not worth it.

Consequence for the power budget: 55 LEDs at 1.42 mA is **~78 mA / 0.39 W at 5 V** with every
LED lit (about half that in typical operation) — the README's earlier 75 mW figure for this row
confused mA with mW. Board total is ≈ 1.6–1.8 W at 5 V, ≈ 0.7 W at 3.3 V.
