epatel/discrete6502/gen/functest/6502_functional_test_traps.csv

address | kind | test_case | listing_line | source
$0412 | jmp * | 0 | 766 | jmp * ;failed anyway
$0421 | jmp * | 0 | 781 | jmp * ;failed anyway
$0430 | jmp * | 0 | 797 | jmp * ;failed anyway
$0435 | jmp * | 0 | 802 | jmp * ;failed anyway
$0470 | bne * | 0 | 872 | bne * ;failed not equal (non zero)
$05a0 | jmp * | 1 | 1175 | jmp * ;failed anyway
$05b9 | bne * | 1 | 1197 | bne * ;failed not equal (non zero)
$05c4 | jmp * | 2 | 1209 | jmp * ;failed anyway
$05cb | bne * | 2 | 1215 | bne * ;failed not equal (non zero)
$05cd | bcc * | 2 | 1218 | bcc * ;failed carry clear
$05cf | bmi * | 2 | 1221 | bmi * ;failed minus (bit 7 set)
$05d3 | beq * | 2 | 1225 | beq * ;failed equal (zero)
$05d5 | bcs * | 2 | 1228 | bcs * ;failed carry set
$05d7 | bpl * | 2 | 1231 | bpl * ;failed plus (bit 7 clear)
$05dc | bne * | 2 | 1236 | bne * ;failed not equal (non zero)
$05de | bcc * | 2 | 1239 | bcc * ;failed carry clear
$05e0 | bmi * | 2 | 1242 | bmi * ;failed minus (bit 7 set)
$05e4 | beq * | 2 | 1246 | beq * ;failed equal (zero)
$05e6 | bcs * | 2 | 1249 | bcs * ;failed carry set
$05e8 | bpl * | 2 | 1252 | bpl * ;failed plus (bit 7 clear)
$05ed | bne * | 2 | 1257 | bne * ;failed not equal (non zero)
$05ef | bcc * | 2 | 1260 | bcc * ;failed carry clear
$05f1 | bmi * | 2 | 1263 | bmi * ;failed minus (bit 7 set)
$05f5 | beq * | 2 | 1267 | beq * ;failed equal (zero)
$05f7 | bcs * | 2 | 1270 | bcs * ;failed carry set
$05f9 | bpl * | 2 | 1273 | bpl * ;failed plus (bit 7 clear)
$0600 | bne * | 2 | 1279 | bne * ;failed not equal (non zero)
$0613 | bne * | 3 | 1296 | bne * ;failed not equal (non zero)
$0619 | bne * | 3 | 1302 | bne * ;failed not equal (non zero)
$061e | bne * | 3 | 1307 | bne * ;failed not equal (non zero)
$0623 | bne * | 3 | 1312 | bne * ;failed not equal (non zero)
$0628 | bne * | 3 | 1316 | bne * ;failed not equal (non zero)
$062d | bne * | 3 | 1321 | bne * ;failed not equal (non zero)
$0634 | bne * | 3 | 1327 | bne * ;failed not equal (non zero)
$0649 | jmp * | 4 | 1349 | jmp * ;failed anyway
$064e | jmp * | 4 | 1353 | jmp * ;failed anyway
$0653 | jmp * | 4 | 1357 | jmp * ;failed anyway
$0658 | jmp * | 4 | 1361 | jmp * ;failed anyway
$065b | jmp * | 4 | 1365 | jmp * ;failed anyway
$065e | jmp * | 4 | 1369 | jmp * ;failed anyway
$0661 | jmp * | 4 | 1373 | jmp * ;failed anyway
$0664 | jmp * | 4 | 1377 | jmp * ;failed anyway
$066b | bne * | 4 | 1383 | bne * ;failed not equal (non zero)
$0670 | bne * | 4 | 1390 | bne * ;failed not equal (non zero)
$0675 | bne * | 4 | 1395 | bne * ;failed not equal (non zero)
$0685 | jmp * | 4 | 1410 | jmp * ;failed anyway
$068a | jmp * | 4 | 1414 | jmp * ;failed anyway
$068f | jmp * | 4 | 1418 | jmp * ;failed anyway
$0694 | jmp * | 4 | 1422 | jmp * ;failed anyway
$0697 | jmp * | 4 | 1426 | jmp * ;failed anyway
$069a | jmp * | 4 | 1430 | jmp * ;failed anyway
$069d | jmp * | 4 | 1434 | jmp * ;failed anyway
$06a0 | jmp * | 4 | 1438 | jmp * ;failed anyway
$06a7 | bne * | 4 | 1446 | bne * ;failed not equal (non zero)
$06b1 | jmp * | 4 | 1460 | jmp * ;failed anyway
$06b8 | jmp * | 4 | 1466 | jmp * ;failed anyway
$06bf | jmp * | 4 | 1472 | jmp * ;failed anyway
$06c6 | jmp * | 4 | 1478 | jmp * ;failed anyway
$06d1 | jmp * | 4 | 1492 | jmp * ;failed anyway
$06d8 | jmp * | 4 | 1498 | jmp * ;failed anyway
$06df | jmp * | 4 | 1504 | jmp * ;failed anyway
$06e6 | jmp * | 4 | 1510 | jmp * ;failed anyway
$06f1 | jmp * | 4 | 1525 | jmp * ;failed anyway
$06f8 | jmp * | 4 | 1531 | jmp * ;failed anyway
$06ff | jmp * | 4 | 1537 | jmp * ;failed anyway
$0706 | jmp * | 4 | 1543 | jmp * ;failed anyway
$0711 | jmp * | 4 | 1557 | jmp * ;failed anyway
$0718 | jmp * | 4 | 1563 | jmp * ;failed anyway
$071f | jmp * | 4 | 1569 | jmp * ;failed anyway
$0726 | jmp * | 4 | 1575 | jmp * ;failed anyway
$0731 | jmp * | 4 | 1589 | jmp * ;failed anyway
$0738 | jmp * | 4 | 1595 | jmp * ;failed anyway
$073f | jmp * | 4 | 1601 | jmp * ;failed anyway
$0746 | jmp * | 4 | 1607 | jmp * ;failed anyway
$0751 | jmp * | 4 | 1621 | jmp * ;failed anyway
$0758 | jmp * | 4 | 1627 | jmp * ;failed anyway
$075f | jmp * | 4 | 1633 | jmp * ;failed anyway
$0766 | jmp * | 4 | 1639 | jmp * ;failed anyway
$0771 | jmp * | 4 | 1653 | jmp * ;failed anyway
$0778 | jmp * | 4 | 1659 | jmp * ;failed anyway
$077f | jmp * | 4 | 1665 | jmp * ;failed anyway
$0786 | jmp * | 4 | 1671 | jmp * ;failed anyway
$0791 | jmp * | 4 | 1685 | jmp * ;failed anyway
$0798 | jmp * | 4 | 1691 | jmp * ;failed anyway
$079f | jmp * | 4 | 1697 | jmp * ;failed anyway
$07a6 | jmp * | 4 | 1703 | jmp * ;failed anyway
$07ae | bne * | 4 | 1710 | bne * ;failed not equal (non zero)
$07c3 | bne * | 5 | 1734 | bne * ;failed not equal (non zero)
$07c9 | bne * | 5 | 1742 | bne * ;failed not equal (non zero)
$07d6 | bne * | 5 | 1759 | bne * ;failed not equal (non zero)
$07dc | bne * | 5 | 1767 | bne * ;failed not equal (non zero)
$07e9 | bne * | 5 | 1784 | bne * ;failed not equal (non zero)
$07ef | bne * | 5 | 1792 | bne * ;failed not equal (non zero)
$07fc | bne * | 5 | 1809 | bne * ;failed not equal (non zero)
$0802 | bne * | 5 | 1817 | bne * ;failed not equal (non zero)
$080f | bne * | 5 | 1834 | bne * ;failed not equal (non zero)
$0815 | bne * | 5 | 1842 | bne * ;failed not equal (non zero)
$0822 | bne * | 5 | 1859 | bne * ;failed not equal (non zero)
$0828 | bne * | 5 | 1867 | bne * ;failed not equal (non zero)
$0835 | bne * | 5 | 1884 | bne * ;failed not equal (non zero)
$083b | bne * | 5 | 1892 | bne * ;failed not equal (non zero)
$0848 | bne * | 5 | 1909 | bne * ;failed not equal (non zero)
$084e | bne * | 5 | 1917 | bne * ;failed not equal (non zero)
$085b | bne * | 5 | 1934 | bne * ;failed not equal (non zero)
$0861 | bne * | 5 | 1942 | bne * ;failed not equal (non zero)
$086e | bne * | 5 | 1959 | bne * ;failed not equal (non zero)
$0874 | bne * | 5 | 1967 | bne * ;failed not equal (non zero)
$0881 | bne * | 5 | 1984 | bne * ;failed not equal (non zero)
$0887 | bne * | 5 | 1992 | bne * ;failed not equal (non zero)
$0894 | bne * | 5 | 2009 | bne * ;failed not equal (non zero)
$089a | bne * | 5 | 2017 | bne * ;failed not equal (non zero)
$089f | bne * | 5 | 2023 | bne * ;failed not equal (non zero)
$08a3 | bne * | 5 | 2027 | bne * ;failed not equal (non zero)
$08aa | bne * | 5 | 2033 | bne * ;failed not equal (non zero)
$08bc | bne * | 6 | 2055 | bne * ;failed not equal (non zero)
$08c2 | bne * | 6 | 2063 | bne * ;failed not equal (non zero)
$08d0 | bne * | 6 | 2080 | bne * ;failed not equal (non zero)
$08d6 | bne * | 6 | 2088 | bne * ;failed not equal (non zero)
$08de | bne * | 6 | 2096 | bne * ;failed not equal (non zero)
$08f3 | bne * | 7 | 2121 | bne * ;failed not equal (non zero)
$08f9 | bne * | 7 | 2129 | bne * ;failed not equal (non zero)
$08fe | bne * | 7 | 2135 | bne * ;failed not equal (non zero)
$0902 | bne * | 7 | 2139 | bne * ;failed not equal (non zero)
$0912 | bne * | 7 | 2156 | bne * ;failed not equal (non zero)
$0918 | bne * | 7 | 2164 | bne * ;failed not equal (non zero)
$091d | bne * | 7 | 2170 | bne * ;failed not equal (non zero)
$0921 | bne * | 7 | 2174 | bne * ;failed not equal (non zero)
$0928 | bne * | 7 | 2180 | bne * ;failed not equal (non zero)
$093e | bne * | 8 | 2203 | bne * ;failed not equal (non zero)
$0942 | beq * | 8 | 2209 | beq * ;failed equal (zero)
$0944 | bpl * | 8 | 2212 | bpl * ;failed plus (bit 7 clear)
$0946 | bcc * | 8 | 2215 | bcc * ;failed carry clear
$0948 | bvc * | 8 | 2218 | bvc * ;failed overflow clear
$094c | bne * | 8 | 2222 | bne * ;failed not equal (non zero)
$0950 | bne * | 8 | 2226 | bne * ;failed not equal (non zero)
$0954 | bne * | 8 | 2230 | bne * ;failed not equal (non zero)
$0961 | bne * | 8 | 2241 | bne * ;failed not equal (non zero)
$0965 | beq * | 8 | 2247 | beq * ;failed equal (zero)
$0967 | bmi * | 8 | 2250 | bmi * ;failed minus (bit 7 set)
$0969 | bcc * | 8 | 2253 | bcc * ;failed carry clear
$096b | bvc * | 8 | 2256 | bvc * ;failed overflow clear
$096f | bne * | 8 | 2260 | bne * ;failed not equal (non zero)
$0973 | bne * | 8 | 2264 | bne * ;failed not equal (non zero)
$0977 | bne * | 8 | 2268 | bne * ;failed not equal (non zero)
$097e | bne * | 8 | 2274 | bne * ;failed not equal (non zero)
$0993 | bne * | 9 | 2296 | bne * ;failed not equal (non zero)
$099c | beq * | 9 | 2307 | beq * ;failed equal (zero)
$099e | bpl * | 9 | 2310 | bpl * ;failed plus (bit 7 clear)
$09a0 | bcc * | 9 | 2313 | bcc * ;failed carry clear
$09a2 | bvc * | 9 | 2316 | bvc * ;failed overflow clear
$09a6 | bne * | 9 | 2320 | bne * ;failed not equal (non zero)
$09aa | bne * | 9 | 2324 | bne * ;failed not equal (non zero)
$09ae | bne * | 9 | 2328 | bne * ;failed not equal (non zero)
$09b3 | bne * | 9 | 2333 | bne * ;failed not equal (non zero)
$09ba | bne * | 9 | 2339 | bne * ;failed not equal (non zero)
$09d3 | beq * | 10 | 2366 | beq * ;failed equal (zero)
$09d5 | bpl * | 10 | 2369 | bpl * ;failed plus (bit 7 clear)
$09d7 | bcc * | 10 | 2372 | bcc * ;failed carry clear
$09d9 | bvc * | 10 | 2375 | bvc * ;failed overflow clear
$09dd | bne * | 10 | 2379 | bne * ;failed not equal (non zero)
$09e1 | bne * | 10 | 2383 | bne * ;failed not equal (non zero)
$09e5 | bne * | 10 | 2387 | bne * ;failed not equal (non zero)
$09ea | bne * | 10 | 2392 | bne * ;failed not equal (non zero)
$09f1 | bne * | 10 | 2398 | bne * ;failed not equal (non zero)
$0a0a | bne * | 11 | 2441 | bne * ;failed not equal (non zero)
$0a0e | bne * | 11 | 2445 | bne * ;failed not equal (non zero)
$0a12 | bne * | 11 | 2449 | bne * ;failed not equal (non zero)
$0a17 | bne * | 11 | 2456 | bne * ;failed not equal (non zero)
$0a1c | bne * | 11 | 2461 | bne * ;failed not equal (non zero)
$0a30 | bne * | 11 | 2496 | bne * ;failed not equal (non zero)
$0a34 | bne * | 11 | 2500 | bne * ;failed not equal (non zero)
$0a38 | bne * | 11 | 2504 | bne * ;failed not equal (non zero)
$0a3d | bne * | 11 | 2511 | bne * ;failed not equal (non zero)
$0a42 | bne * | 11 | 2516 | bne * ;failed not equal (non zero)
$0a49 | bne * | 11 | 2522 | bne * ;failed not equal (non zero)
$0a5a | bne * | 12 | 2547 | bne * ;failed not equal (non zero)
$0a63 | bne * | 12 | 2560 | bne * ;failed not equal (non zero)
$0a6c | bne * | 12 | 2574 | bne * ;failed not equal (non zero)
$0a75 | bne * | 12 | 2587 | bne * ;failed not equal (non zero)
$0a7e | bne * | 12 | 2601 | bne * ;failed not equal (non zero)
$0a87 | bne * | 12 | 2614 | bne * ;failed not equal (non zero)
$0a90 | bne * | 12 | 2627 | bne * ;failed not equal (non zero)
$0a9c | bne * | 12 | 2646 | bne * ;failed not equal (non zero)
$0aa5 | bne * | 12 | 2659 | bne * ;failed not equal (non zero)
$0aae | bne * | 12 | 2672 | bne * ;failed not equal (non zero)
$0ab7 | bne * | 12 | 2686 | bne * ;failed not equal (non zero)
$0ac0 | bne * | 12 | 2699 | bne * ;failed not equal (non zero)
$0ac9 | bne * | 12 | 2713 | bne * ;failed not equal (non zero)
$0ad2 | bne * | 12 | 2726 | bne * ;failed not equal (non zero)
$0ade | bne * | 12 | 2745 | bne * ;failed not equal (non zero)
$0ae7 | bne * | 12 | 2758 | bne * ;failed not equal (non zero)
$0aef | bne * | 12 | 2766 | bne * ;failed not equal (non zero)
$0b00 | bne * | 13 | 2788 | bne * ;failed not equal (non zero)
$0b06 | bne * | 13 | 2796 | bne * ;failed not equal (non zero)
$0b0d | bne * | 13 | 2805 | bne * ;failed not equal (non zero)
$0b13 | bne * | 13 | 2813 | bne * ;failed not equal (non zero)
$0b1a | bne * | 13 | 2822 | bne * ;failed not equal (non zero)
$0b20 | bne * | 13 | 2830 | bne * ;failed not equal (non zero)
$0b27 | bne * | 13 | 2839 | bne * ;failed not equal (non zero)
$0b2d | bne * | 13 | 2847 | bne * ;failed not equal (non zero)
$0b34 | bne * | 13 | 2856 | bne * ;failed not equal (non zero)
$0b3a | bne * | 13 | 2864 | bne * ;failed not equal (non zero)
$0b46 | bne * | 13 | 2881 | bne * ;failed not equal (non zero)
$0b4c | bne * | 13 | 2889 | bne * ;failed not equal (non zero)
$0b53 | bne * | 13 | 2898 | bne * ;failed not equal (non zero)
$0b59 | bne * | 13 | 2906 | bne * ;failed not equal (non zero)
$0b60 | bne * | 13 | 2915 | bne * ;failed not equal (non zero)
$0b66 | bne * | 13 | 2923 | bne * ;failed not equal (non zero)
$0b6d | bne * | 13 | 2932 | bne * ;failed not equal (non zero)
$0b73 | bne * | 13 | 2940 | bne * ;failed not equal (non zero)
$0b7a | bne * | 13 | 2949 | bne * ;failed not equal (non zero)
$0b80 | bne * | 13 | 2957 | bne * ;failed not equal (non zero)
$0b8d | bne * | 13 | 2975 | bne * ;failed not equal (non zero)
$0b93 | bne * | 13 | 2983 | bne * ;failed not equal (non zero)
$0b9a | bne * | 13 | 2992 | bne * ;failed not equal (non zero)
$0ba0 | bne * | 13 | 3000 | bne * ;failed not equal (non zero)
$0ba7 | bne * | 13 | 3009 | bne * ;failed not equal (non zero)
$0bad | bne * | 13 | 3017 | bne * ;failed not equal (non zero)
$0bb4 | bne * | 13 | 3026 | bne * ;failed not equal (non zero)
$0bba | bne * | 13 | 3034 | bne * ;failed not equal (non zero)
$0bc1 | bne * | 13 | 3043 | bne * ;failed not equal (non zero)
$0bc7 | bne * | 13 | 3051 | bne * ;failed not equal (non zero)
$0bd3 | bne * | 13 | 3068 | bne * ;failed not equal (non zero)
$0bd9 | bne * | 13 | 3076 | bne * ;failed not equal (non zero)
$0be0 | bne * | 13 | 3085 | bne * ;failed not equal (non zero)
$0be6 | bne * | 13 | 3093 | bne * ;failed not equal (non zero)
$0bed | bne * | 13 | 3102 | bne * ;failed not equal (non zero)
$0bf3 | bne * | 13 | 3110 | bne * ;failed not equal (non zero)
$0bfa | bne * | 13 | 3119 | bne * ;failed not equal (non zero)
$0c00 | bne * | 13 | 3127 | bne * ;failed not equal (non zero)
$0c07 | bne * | 13 | 3136 | bne * ;failed not equal (non zero)
$0c0d | bne * | 13 | 3144 | bne * ;failed not equal (non zero)
$0c1a | bne * | 13 | 3162 | bne * ;failed not equal (non zero)
$0c20 | bne * | 13 | 3170 | bne * ;failed not equal (non zero)
$0c2a | bne * | 13 | 3182 | bne * ;failed not equal (non zero)
$0c30 | bne * | 13 | 3190 | bne * ;failed not equal (non zero)
$0c3a | bne * | 13 | 3202 | bne * ;failed not equal (non zero)
$0c40 | bne * | 13 | 3210 | bne * ;failed not equal (non zero)
$0c4b | bne * | 13 | 3226 | bne * ;failed not equal (non zero)
$0c51 | bne * | 13 | 3234 | bne * ;failed not equal (non zero)
$0c5b | bne * | 13 | 3246 | bne * ;failed not equal (non zero)
$0c61 | bne * | 13 | 3254 | bne * ;failed not equal (non zero)
$0c6b | bne * | 13 | 3266 | bne * ;failed not equal (non zero)
$0c71 | bne * | 13 | 3274 | bne * ;failed not equal (non zero)
$0c7e | bne * | 13 | 3292 | bne * ;failed not equal (non zero)
$0c84 | bne * | 13 | 3300 | bne * ;failed not equal (non zero)
$0c8e | bne * | 13 | 3312 | bne * ;failed not equal (non zero)
$0c94 | bne * | 13 | 3320 | bne * ;failed not equal (non zero)
$0c9e | bne * | 13 | 3332 | bne * ;failed not equal (non zero)
$0ca4 | bne * | 13 | 3340 | bne * ;failed not equal (non zero)
$0caf | bne * | 13 | 3356 | bne * ;failed not equal (non zero)
$0cb5 | bne * | 13 | 3364 | bne * ;failed not equal (non zero)
$0cbf | bne * | 13 | 3376 | bne * ;failed not equal (non zero)
$0cc5 | bne * | 13 | 3384 | bne * ;failed not equal (non zero)
$0ccf | bne * | 13 | 3396 | bne * ;failed not equal (non zero)
$0cd5 | bne * | 13 | 3404 | bne * ;failed not equal (non zero)
$0ce3 | bne * | 13 | 3421 | bne * ;failed not equal (non zero)
$0ce9 | bne * | 13 | 3429 | bne * ;failed not equal (non zero)
$0cf4 | bne * | 13 | 3442 | bne * ;failed not equal (non zero)
$0cfa | bne * | 13 | 3450 | bne * ;failed not equal (non zero)
$0d05 | bne * | 13 | 3463 | bne * ;failed not equal (non zero)
$0d0b | bne * | 13 | 3471 | bne * ;failed not equal (non zero)
$0d19 | bne * | 13 | 3487 | bne * ;failed not equal (non zero)
$0d1f | bne * | 13 | 3495 | bne * ;failed not equal (non zero)
$0d2a | bne * | 13 | 3508 | bne * ;failed not equal (non zero)
$0d30 | bne * | 13 | 3516 | bne * ;failed not equal (non zero)
$0d3b | bne * | 13 | 3529 | bne * ;failed not equal (non zero)
$0d41 | bne * | 13 | 3537 | bne * ;failed not equal (non zero)
$0d4f | bne * | 13 | 3555 | bne * ;failed not equal (non zero)
$0d55 | bne * | 13 | 3563 | bne * ;failed not equal (non zero)
$0d60 | bne * | 13 | 3576 | bne * ;failed not equal (non zero)
$0d66 | bne * | 13 | 3584 | bne * ;failed not equal (non zero)
$0d71 | bne * | 13 | 3597 | bne * ;failed not equal (non zero)
$0d77 | bne * | 13 | 3605 | bne * ;failed not equal (non zero)
$0d85 | bne * | 13 | 3621 | bne * ;failed not equal (non zero)
$0d8b | bne * | 13 | 3629 | bne * ;failed not equal (non zero)
$0d96 | bne * | 13 | 3642 | bne * ;failed not equal (non zero)
$0d9c | bne * | 13 | 3650 | bne * ;failed not equal (non zero)
$0da7 | bne * | 13 | 3663 | bne * ;failed not equal (non zero)
$0dad | bne * | 13 | 3671 | bne * ;failed not equal (non zero)
$0db5 | bne * | 13 | 3679 | bne * ;failed not equal (non zero)
$0dc9 | bne * | 14 | 3704 | bne * ;failed not equal (non zero)
$0dd6 | bne * | 14 | 3720 | bne * ;failed not equal (non zero)
$0de4 | bne * | 14 | 3737 | bne * ;failed not equal (non zero)
$0df1 | bne * | 14 | 3753 | bne * ;failed not equal (non zero)
$0dff | bne * | 14 | 3770 | bne * ;failed not equal (non zero)
$0e17 | bne * | 14 | 3799 | bne * ;failed not equal (non zero)
$0e1e | bne * | 14 | 3806 | bne * ;failed not equal (non zero)
$0e28 | bne * | 14 | 3819 | bne * ;failed not equal (non zero)
$0e2f | bne * | 14 | 3826 | bne * ;failed not equal (non zero)
$0e39 | bne * | 14 | 3839 | bne * ;failed not equal (non zero)
$0e40 | bne * | 14 | 3846 | bne * ;failed not equal (non zero)
$0e4d | bne * | 14 | 3862 | bne * ;failed not equal (non zero)
$0e54 | bne * | 14 | 3869 | bne * ;failed not equal (non zero)
$0e5e | bne * | 14 | 3882 | bne * ;failed not equal (non zero)
$0e65 | bne * | 14 | 3889 | bne * ;failed not equal (non zero)
$0e6f | bne * | 14 | 3902 | bne * ;failed not equal (non zero)
$0e76 | bne * | 14 | 3909 | bne * ;failed not equal (non zero)
$0e7e | bne * | 14 | 3916 | bne * ;failed not equal (non zero)
$0e9b | bne * | 15 | 3945 | bne * ;failed not equal (non zero)
$0ea3 | bne * | 15 | 3953 | bne * ;failed not equal (non zero)
$0ebe | bne * | 15 | 3977 | bne * ;failed not equal (non zero)
$0ec6 | bne * | 15 | 3985 | bne * ;failed not equal (non zero)
$0ee2 | bne * | 15 | 4010 | bne * ;failed not equal (non zero)
$0eea | bne * | 15 | 4018 | bne * ;failed not equal (non zero)
$0f06 | bne * | 15 | 4043 | bne * ;failed not equal (non zero)
$0f0e | bne * | 15 | 4051 | bne * ;failed not equal (non zero)
$0f1f | bne * | 15 | 4062 | bne * ;failed not equal (non zero)
$0f2b | bne * | 15 | 4069 | bne * ;failed not equal (non zero)
$0f39 | bne * | 15 | 4079 | bne * ;failed not equal (non zero)
$0f63 | bne * | 16 | 4106 | bne * ;failed not equal (non zero)
$0f6d | bne * | 16 | 4112 | bne * ;failed not equal (non zero)
$0f7b | bne * | 16 | 4122 | bne * ;failed not equal (non zero)
$0f98 | bne * | 17 | 4150 | bne * ;failed not equal (non zero)
$0fa0 | bne * | 17 | 4158 | bne * ;failed not equal (non zero)
$0fbb | bne * | 17 | 4182 | bne * ;failed not equal (non zero)
$0fc3 | bne * | 17 | 4190 | bne * ;failed not equal (non zero)
$0fde | bne * | 17 | 4215 | bne * ;failed not equal (non zero)
$0fe6 | bne * | 17 | 4223 | bne * ;failed not equal (non zero)
$1001 | bne * | 17 | 4248 | bne * ;failed not equal (non zero)
$1009 | bne * | 17 | 4256 | bne * ;failed not equal (non zero)
$1018 | bne * | 17 | 4267 | bne * ;failed not equal (non zero)
$1024 | bne * | 17 | 4274 | bne * ;failed not equal (non zero)
$1032 | bne * | 17 | 4284 | bne * ;failed not equal (non zero)
$105a | bne * | 18 | 4311 | bne * ;failed not equal (non zero)
$1064 | bne * | 18 | 4317 | bne * ;failed not equal (non zero)
$1072 | bne * | 18 | 4327 | bne * ;failed not equal (non zero)
$108e | bne * | 19 | 4355 | bne * ;failed not equal (non zero)
$1096 | bne * | 19 | 4363 | bne * ;failed not equal (non zero)
$10ad | bne * | 19 | 4384 | bne * ;failed not equal (non zero)
$10b5 | bne * | 19 | 4392 | bne * ;failed not equal (non zero)
$10cc | bne * | 19 | 4413 | bne * ;failed not equal (non zero)
$10d4 | bne * | 19 | 4421 | bne * ;failed not equal (non zero)
$10eb | bne * | 19 | 4442 | bne * ;failed not equal (non zero)
$10f3 | bne * | 19 | 4450 | bne * ;failed not equal (non zero)
$110a | bne * | 19 | 4472 | bne * ;failed not equal (non zero)
$1112 | bne * | 19 | 4480 | bne * ;failed not equal (non zero)
$1129 | bne * | 19 | 4501 | bne * ;failed not equal (non zero)
$1131 | bne * | 19 | 4509 | bne * ;failed not equal (non zero)
$1148 | bne * | 19 | 4530 | bne * ;failed not equal (non zero)
$1150 | bne * | 19 | 4538 | bne * ;failed not equal (non zero)
$1167 | bne * | 19 | 4559 | bne * ;failed not equal (non zero)
$116f | bne * | 19 | 4567 | bne * ;failed not equal (non zero)
$1185 | bne * | 19 | 4588 | bne * ;failed not equal (non zero)
$118d | bne * | 19 | 4596 | bne * ;failed not equal (non zero)
$11a3 | bne * | 19 | 4616 | bne * ;failed not equal (non zero)
$11ab | bne * | 19 | 4624 | bne * ;failed not equal (non zero)
$11c1 | bne * | 19 | 4644 | bne * ;failed not equal (non zero)
$11c9 | bne * | 19 | 4652 | bne * ;failed not equal (non zero)
$11df | bne * | 19 | 4672 | bne * ;failed not equal (non zero)
$11e7 | bne * | 19 | 4680 | bne * ;failed not equal (non zero)
$11fe | bne * | 19 | 4702 | bne * ;failed not equal (non zero)
$1206 | bne * | 19 | 4710 | bne * ;failed not equal (non zero)
$121d | bne * | 19 | 4731 | bne * ;failed not equal (non zero)
$1225 | bne * | 19 | 4739 | bne * ;failed not equal (non zero)
$123c | bne * | 19 | 4760 | bne * ;failed not equal (non zero)
$1244 | bne * | 19 | 4768 | bne * ;failed not equal (non zero)
$125b | bne * | 19 | 4789 | bne * ;failed not equal (non zero)
$1263 | bne * | 19 | 4797 | bne * ;failed not equal (non zero)
$126f | bne * | 19 | 4811 | bne * ;failed not equal (non zero)
$1277 | bne * | 19 | 4819 | bne * ;failed not equal (non zero)
$1283 | bne * | 19 | 4832 | bne * ;failed not equal (non zero)
$128b | bne * | 19 | 4840 | bne * ;failed not equal (non zero)
$1297 | bne * | 19 | 4853 | bne * ;failed not equal (non zero)
$129f | bne * | 19 | 4861 | bne * ;failed not equal (non zero)
$12ab | bne * | 19 | 4874 | bne * ;failed not equal (non zero)
$12b3 | bne * | 19 | 4882 | bne * ;failed not equal (non zero)
$12bf | bne * | 19 | 4896 | bne * ;failed not equal (non zero)
$12c7 | bne * | 19 | 4904 | bne * ;failed not equal (non zero)
$12d3 | bne * | 19 | 4917 | bne * ;failed not equal (non zero)
$12db | bne * | 19 | 4925 | bne * ;failed not equal (non zero)
$12e7 | bne * | 19 | 4938 | bne * ;failed not equal (non zero)
$12ef | bne * | 19 | 4946 | bne * ;failed not equal (non zero)
$12fb | bne * | 19 | 4959 | bne * ;failed not equal (non zero)
$1303 | bne * | 19 | 4967 | bne * ;failed not equal (non zero)
$130d | bne * | 19 | 4975 | bne * ;failed not equal (non zero)
$1319 | bne * | 19 | 4982 | bne * ;failed not equal (non zero)
$1324 | bne * | 19 | 4989 | bne * ;failed not equal (non zero)
$1330 | bne * | 19 | 4996 | bne * ;failed not equal (non zero)
$133b | bne * | 19 | 5003 | bne * ;failed not equal (non zero)
$1347 | bne * | 19 | 5010 | bne * ;failed not equal (non zero)
$1352 | bne * | 19 | 5017 | bne * ;failed not equal (non zero)
$135e | bne * | 19 | 5024 | bne * ;failed not equal (non zero)
$1368 | bne * | 19 | 5031 | bne * ;failed not equal (non zero)
$1384 | bne * | 20 | 5059 | bne * ;failed not equal (non zero)
$138c | bne * | 20 | 5067 | bne * ;failed not equal (non zero)
$13a3 | bne * | 20 | 5088 | bne * ;failed not equal (non zero)
$13ab | bne * | 20 | 5096 | bne * ;failed not equal (non zero)
$13c2 | bne * | 20 | 5117 | bne * ;failed not equal (non zero)
$13ca | bne * | 20 | 5125 | bne * ;failed not equal (non zero)
$13e1 | bne * | 20 | 5146 | bne * ;failed not equal (non zero)
$13e9 | bne * | 20 | 5154 | bne * ;failed not equal (non zero)
$1400 | bne * | 20 | 5176 | bne * ;failed not equal (non zero)
$1408 | bne * | 20 | 5184 | bne * ;failed not equal (non zero)
$141f | bne * | 20 | 5205 | bne * ;failed not equal (non zero)
$1427 | bne * | 20 | 5213 | bne * ;failed not equal (non zero)
$143e | bne * | 20 | 5234 | bne * ;failed not equal (non zero)
$1446 | bne * | 20 | 5242 | bne * ;failed not equal (non zero)
$145d | bne * | 20 | 5263 | bne * ;failed not equal (non zero)
$1465 | bne * | 20 | 5271 | bne * ;failed not equal (non zero)
$147c | bne * | 20 | 5293 | bne * ;failed not equal (non zero)
$1484 | bne * | 20 | 5301 | bne * ;failed not equal (non zero)
$149b | bne * | 20 | 5322 | bne * ;failed not equal (non zero)
$14a3 | bne * | 20 | 5330 | bne * ;failed not equal (non zero)
$14ba | bne * | 20 | 5351 | bne * ;failed not equal (non zero)
$14c2 | bne * | 20 | 5359 | bne * ;failed not equal (non zero)
$14d9 | bne * | 20 | 5380 | bne * ;failed not equal (non zero)
$14e1 | bne * | 20 | 5388 | bne * ;failed not equal (non zero)
$14f8 | bne * | 20 | 5410 | bne * ;failed not equal (non zero)
$1500 | bne * | 20 | 5418 | bne * ;failed not equal (non zero)
$1517 | bne * | 20 | 5439 | bne * ;failed not equal (non zero)
$151f | bne * | 20 | 5447 | bne * ;failed not equal (non zero)
$1536 | bne * | 20 | 5468 | bne * ;failed not equal (non zero)
$153e | bne * | 20 | 5476 | bne * ;failed not equal (non zero)
$1555 | bne * | 20 | 5497 | bne * ;failed not equal (non zero)
$155d | bne * | 20 | 5505 | bne * ;failed not equal (non zero)
$1569 | bne * | 20 | 5520 | bne * ;failed not equal (non zero)
$1571 | bne * | 20 | 5528 | bne * ;failed not equal (non zero)
$157d | bne * | 20 | 5541 | bne * ;failed not equal (non zero)
$1585 | bne * | 20 | 5549 | bne * ;failed not equal (non zero)
$1591 | bne * | 20 | 5562 | bne * ;failed not equal (non zero)
$1599 | bne * | 20 | 5570 | bne * ;failed not equal (non zero)
$15a5 | bne * | 20 | 5583 | bne * ;failed not equal (non zero)
$15ad | bne * | 20 | 5591 | bne * ;failed not equal (non zero)
$15b9 | bne * | 20 | 5605 | bne * ;failed not equal (non zero)
$15c1 | bne * | 20 | 5613 | bne * ;failed not equal (non zero)
$15cd | bne * | 20 | 5626 | bne * ;failed not equal (non zero)
$15d5 | bne * | 20 | 5634 | bne * ;failed not equal (non zero)
$15e1 | bne * | 20 | 5647 | bne * ;failed not equal (non zero)
$15e9 | bne * | 20 | 5655 | bne * ;failed not equal (non zero)
$15f5 | bne * | 20 | 5668 | bne * ;failed not equal (non zero)
$15fd | bne * | 20 | 5676 | bne * ;failed not equal (non zero)
$1607 | bne * | 20 | 5684 | bne * ;failed not equal (non zero)
$1613 | bne * | 20 | 5691 | bne * ;failed not equal (non zero)
$161e | bne * | 20 | 5698 | bne * ;failed not equal (non zero)
$162a | bne * | 20 | 5705 | bne * ;failed not equal (non zero)
$1635 | bne * | 20 | 5712 | bne * ;failed not equal (non zero)
$1641 | bne * | 20 | 5719 | bne * ;failed not equal (non zero)
$164c | bne * | 20 | 5726 | bne * ;failed not equal (non zero)
$1658 | bne * | 20 | 5733 | bne * ;failed not equal (non zero)
$1662 | bne * | 20 | 5740 | bne * ;failed not equal (non zero)
$167e | bne * | 21 | 5768 | bne * ;failed not equal (non zero)
$1686 | bne * | 21 | 5776 | bne * ;failed not equal (non zero)
$16a0 | bne * | 21 | 5799 | bne * ;failed not equal (non zero)
$16a8 | bne * | 21 | 5807 | bne * ;failed not equal (non zero)
$16c1 | bne * | 21 | 5830 | bne * ;failed not equal (non zero)
$16c9 | bne * | 21 | 5838 | bne * ;failed not equal (non zero)
$16e2 | bne * | 21 | 5861 | bne * ;failed not equal (non zero)
$16ea | bne * | 21 | 5869 | bne * ;failed not equal (non zero)
$16f9 | bne * | 21 | 5880 | bne * ;failed not equal (non zero)
$1705 | bne * | 21 | 5887 | bne * ;failed not equal (non zero)
$1713 | bne * | 21 | 5897 | bne * ;failed not equal (non zero)
$172f | bne * | 22 | 5924 | bne * ;failed not equal (non zero)
$1737 | bne * | 22 | 5932 | bne * ;failed not equal (non zero)
$1751 | bne * | 22 | 5955 | bne * ;failed not equal (non zero)
$1759 | bne * | 22 | 5963 | bne * ;failed not equal (non zero)
$176a | bne * | 22 | 5974 | bne * ;failed not equal (non zero)
$1787 | bne * | 22 | 5999 | bne * ;failed not equal (non zero)
$178f | bne * | 22 | 6007 | bne * ;failed not equal (non zero)
$17a8 | bne * | 22 | 6030 | bne * ;failed not equal (non zero)
$17b0 | bne * | 22 | 6038 | bne * ;failed not equal (non zero)
$17c1 | bne * | 22 | 6049 | bne * ;failed not equal (non zero)
$17e0 | bne * | 22 | 6075 | bne * ;failed not equal (non zero)
$17e8 | bne * | 22 | 6083 | bne * ;failed not equal (non zero)
$1805 | bne * | 22 | 6109 | bne * ;failed not equal (non zero)
$180d | bne * | 22 | 6117 | bne * ;failed not equal (non zero)
$1820 | bne * | 22 | 6130 | bne * ;failed not equal (non zero)
$182e | bne * | 22 | 6140 | bne * ;failed not equal (non zero)
$1855 | bne * | 23 | 6167 | bne * ;failed not equal (non zero)
$185f | bne * | 23 | 6173 | bne * ;failed not equal (non zero)
$1882 | bne * | 23 | 6194 | bne * ;failed not equal (non zero)
$18a1 | bne * | 23 | 6212 | bne * ;failed not equal (non zero)
$18c3 | bne * | 23 | 6233 | bne * ;failed not equal (non zero)
$18d1 | bne * | 23 | 6243 | bne * ;failed not equal (non zero)
$18ea | bne * | 24 | 6268 | bne * ;failed not equal (non zero)
$18f2 | bne * | 24 | 6276 | bne * ;failed not equal (non zero)
$1906 | bne * | 24 | 6294 | bne * ;failed not equal (non zero)
$190e | bne * | 24 | 6302 | bne * ;failed not equal (non zero)
$1922 | bne * | 24 | 6320 | bne * ;failed not equal (non zero)
$192a | bne * | 24 | 6328 | bne * ;failed not equal (non zero)
$193e | bne * | 24 | 6346 | bne * ;failed not equal (non zero)
$1946 | bne * | 24 | 6354 | bne * ;failed not equal (non zero)
$195a | bne * | 24 | 6372 | bne * ;failed not equal (non zero)
$1962 | bne * | 24 | 6380 | bne * ;failed not equal (non zero)
$1976 | bne * | 24 | 6398 | bne * ;failed not equal (non zero)
$197e | bne * | 24 | 6406 | bne * ;failed not equal (non zero)
$1992 | bne * | 24 | 6424 | bne * ;failed not equal (non zero)
$199a | bne * | 24 | 6432 | bne * ;failed not equal (non zero)
$19ae | bne * | 24 | 6450 | bne * ;failed not equal (non zero)
$19b6 | bne * | 24 | 6458 | bne * ;failed not equal (non zero)
$19ca | bne * | 24 | 6476 | bne * ;failed not equal (non zero)
$19d2 | bne * | 24 | 6484 | bne * ;failed not equal (non zero)
$19e6 | bne * | 24 | 6502 | bne * ;failed not equal (non zero)
$19ee | bne * | 24 | 6510 | bne * ;failed not equal (non zero)
$1a02 | bne * | 24 | 6528 | bne * ;failed not equal (non zero)
$1a0a | bne * | 24 | 6536 | bne * ;failed not equal (non zero)
$1a1e | bne * | 24 | 6554 | bne * ;failed not equal (non zero)
$1a26 | bne * | 24 | 6562 | bne * ;failed not equal (non zero)
$1a3a | bne * | 24 | 6580 | bne * ;failed not equal (non zero)
$1a42 | bne * | 24 | 6588 | bne * ;failed not equal (non zero)
$1a56 | bne * | 24 | 6606 | bne * ;failed not equal (non zero)
$1a5e | bne * | 24 | 6614 | bne * ;failed not equal (non zero)
$1a72 | bne * | 24 | 6632 | bne * ;failed not equal (non zero)
$1a7a | bne * | 24 | 6640 | bne * ;failed not equal (non zero)
$1a8e | bne * | 24 | 6658 | bne * ;failed not equal (non zero)
$1a96 | bne * | 24 | 6666 | bne * ;failed not equal (non zero)
$1aa2 | bne * | 24 | 6679 | bne * ;failed not equal (non zero)
$1aaa | bne * | 24 | 6687 | bne * ;failed not equal (non zero)
$1ab6 | bne * | 24 | 6700 | bne * ;failed not equal (non zero)
$1abe | bne * | 24 | 6708 | bne * ;failed not equal (non zero)
$1aca | bne * | 24 | 6721 | bne * ;failed not equal (non zero)
$1ad2 | bne * | 24 | 6729 | bne * ;failed not equal (non zero)
$1ade | bne * | 24 | 6742 | bne * ;failed not equal (non zero)
$1ae6 | bne * | 24 | 6750 | bne * ;failed not equal (non zero)
$1af2 | bne * | 24 | 6764 | bne * ;failed not equal (non zero)
$1afa | bne * | 24 | 6772 | bne * ;failed not equal (non zero)
$1b06 | bne * | 24 | 6785 | bne * ;failed not equal (non zero)
$1b0e | bne * | 24 | 6793 | bne * ;failed not equal (non zero)
$1b1a | bne * | 24 | 6806 | bne * ;failed not equal (non zero)
$1b22 | bne * | 24 | 6814 | bne * ;failed not equal (non zero)
$1b2e | bne * | 24 | 6827 | bne * ;failed not equal (non zero)
$1b36 | bne * | 24 | 6835 | bne * ;failed not equal (non zero)
$1b40 | bne * | 24 | 6843 | bne * ;failed not equal (non zero)
$1b4c | bne * | 24 | 6850 | bne * ;failed not equal (non zero)
$1b57 | bne * | 24 | 6857 | bne * ;failed not equal (non zero)
$1b63 | bne * | 24 | 6864 | bne * ;failed not equal (non zero)
$1b6e | bne * | 24 | 6871 | bne * ;failed not equal (non zero)
$1b7a | bne * | 24 | 6878 | bne * ;failed not equal (non zero)
$1b85 | bne * | 24 | 6885 | bne * ;failed not equal (non zero)
$1b91 | bne * | 24 | 6892 | bne * ;failed not equal (non zero)
$1b9b | bne * | 24 | 6899 | bne * ;failed not equal (non zero)
$1bad | bne * | 25 | 6922 | bne * ;failed not equal (non zero)
$1bb3 | bne * | 25 | 6930 | bne * ;failed not equal (non zero)
$1bc1 | bne * | 25 | 6947 | bne * ;failed not equal (non zero)
$1bc7 | bne * | 25 | 6955 | bne * ;failed not equal (non zero)
$1bd5 | bne * | 25 | 6972 | bne * ;failed not equal (non zero)
$1bdb | bne * | 25 | 6980 | bne * ;failed not equal (non zero)
$1be9 | bne * | 25 | 6997 | bne * ;failed not equal (non zero)
$1bef | bne * | 25 | 7005 | bne * ;failed not equal (non zero)
$1bfd | bne * | 25 | 7023 | bne * ;failed not equal (non zero)
$1c03 | bne * | 25 | 7031 | bne * ;failed not equal (non zero)
$1c11 | bne * | 25 | 7048 | bne * ;failed not equal (non zero)
$1c17 | bne * | 25 | 7056 | bne * ;failed not equal (non zero)
$1c25 | bne * | 25 | 7073 | bne * ;failed not equal (non zero)
$1c2b | bne * | 25 | 7081 | bne * ;failed not equal (non zero)
$1c39 | bne * | 25 | 7098 | bne * ;failed not equal (non zero)
$1c3f | bne * | 25 | 7106 | bne * ;failed not equal (non zero)
$1c4e | bne * | 25 | 7124 | bne * ;failed not equal (non zero)
$1c54 | bne * | 25 | 7132 | bne * ;failed not equal (non zero)
$1c63 | bne * | 25 | 7149 | bne * ;failed not equal (non zero)
$1c69 | bne * | 25 | 7157 | bne * ;failed not equal (non zero)
$1c78 | bne * | 25 | 7174 | bne * ;failed not equal (non zero)
$1c7e | bne * | 25 | 7182 | bne * ;failed not equal (non zero)
$1c8d | bne * | 25 | 7199 | bne * ;failed not equal (non zero)
$1c93 | bne * | 25 | 7207 | bne * ;failed not equal (non zero)
$1ca2 | bne * | 25 | 7225 | bne * ;failed not equal (non zero)
$1ca8 | bne * | 25 | 7233 | bne * ;failed not equal (non zero)
$1cb7 | bne * | 25 | 7250 | bne * ;failed not equal (non zero)
$1cbd | bne * | 25 | 7258 | bne * ;failed not equal (non zero)
$1ccc | bne * | 25 | 7275 | bne * ;failed not equal (non zero)
$1cd2 | bne * | 25 | 7283 | bne * ;failed not equal (non zero)
$1ce1 | bne * | 25 | 7300 | bne * ;failed not equal (non zero)
$1ce7 | bne * | 25 | 7308 | bne * ;failed not equal (non zero)
$1cef | bne * | 25 | 7316 | bne * ;failed not equal (non zero)
$1d03 | bne * | 26 | 7342 | bne * ;failed not equal (non zero)
$1d0e | bne * | 26 | 7356 | bne * ;failed not equal (non zero)
$1d17 | bne * | 26 | 7366 | bne * ;failed not equal (non zero)
$1d1d | bne * | 26 | 7374 | bne * ;failed not equal (non zero)
$1d2d | bne * | 26 | 7395 | bne * ;failed not equal (non zero)
$1d38 | bne * | 26 | 7409 | bne * ;failed not equal (non zero)
$1d41 | bne * | 26 | 7419 | bne * ;failed not equal (non zero)
$1d47 | bne * | 26 | 7427 | bne * ;failed not equal (non zero)
$1d58 | bne * | 26 | 7449 | bne * ;failed not equal (non zero)
$1d64 | bne * | 26 | 7463 | bne * ;failed not equal (non zero)
$1d6e | bne * | 26 | 7473 | bne * ;failed not equal (non zero)
$1d74 | bne * | 26 | 7481 | bne * ;failed not equal (non zero)
$1d85 | bne * | 26 | 7502 | bne * ;failed not equal (non zero)
$1d91 | bne * | 26 | 7516 | bne * ;failed not equal (non zero)
$1d9b | bne * | 26 | 7526 | bne * ;failed not equal (non zero)
$1da1 | bne * | 26 | 7534 | bne * ;failed not equal (non zero)
$1db1 | bne * | 26 | 7556 | bne * ;failed not equal (non zero)
$1dbc | bne * | 26 | 7570 | bne * ;failed not equal (non zero)
$1dc5 | bne * | 26 | 7580 | bne * ;failed not equal (non zero)
$1dcb | bne * | 26 | 7588 | bne * ;failed not equal (non zero)
$1ddb | bne * | 26 | 7609 | bne * ;failed not equal (non zero)
$1de6 | bne * | 26 | 7623 | bne * ;failed not equal (non zero)
$1def | bne * | 26 | 7633 | bne * ;failed not equal (non zero)
$1df5 | bne * | 26 | 7641 | bne * ;failed not equal (non zero)
$1dfd | bne * | 26 | 7649 | bne * ;failed not equal (non zero)
$1e11 | bne * | 27 | 7675 | bne * ;failed not equal (non zero)
$1e1c | bne * | 27 | 7689 | bne * ;failed not equal (non zero)
$1e25 | bne * | 27 | 7699 | bne * ;failed not equal (non zero)
$1e2b | bne * | 27 | 7707 | bne * ;failed not equal (non zero)
$1e3b | bne * | 27 | 7728 | bne * ;failed not equal (non zero)
$1e46 | bne * | 27 | 7742 | bne * ;failed not equal (non zero)
$1e4f | bne * | 27 | 7752 | bne * ;failed not equal (non zero)
$1e55 | bne * | 27 | 7760 | bne * ;failed not equal (non zero)
$1e66 | bne * | 27 | 7782 | bne * ;failed not equal (non zero)
$1e72 | bne * | 27 | 7796 | bne * ;failed not equal (non zero)
$1e7c | bne * | 27 | 7806 | bne * ;failed not equal (non zero)
$1e82 | bne * | 27 | 7814 | bne * ;failed not equal (non zero)
$1e93 | bne * | 27 | 7835 | bne * ;failed not equal (non zero)
$1e9f | bne * | 27 | 7849 | bne * ;failed not equal (non zero)
$1ea9 | bne * | 27 | 7859 | bne * ;failed not equal (non zero)
$1eaf | bne * | 27 | 7867 | bne * ;failed not equal (non zero)
$1ebf | bne * | 27 | 7889 | bne * ;failed not equal (non zero)
$1eca | bne * | 27 | 7903 | bne * ;failed not equal (non zero)
$1ed3 | bne * | 27 | 7913 | bne * ;failed not equal (non zero)
$1ed9 | bne * | 27 | 7921 | bne * ;failed not equal (non zero)
$1ee9 | bne * | 27 | 7942 | bne * ;failed not equal (non zero)
$1ef4 | bne * | 27 | 7956 | bne * ;failed not equal (non zero)
$1efd | bne * | 27 | 7966 | bne * ;failed not equal (non zero)
$1f03 | bne * | 27 | 7974 | bne * ;failed not equal (non zero)
$1f0b | bne * | 27 | 7982 | bne * ;failed not equal (non zero)
$1f1d | bne * | 28 | 8004 | bne * ;failed not equal (non zero)
$1f23 | bne * | 28 | 8012 | bne * ;failed not equal (non zero)
$1f31 | bne * | 28 | 8029 | bne * ;failed not equal (non zero)
$1f37 | bne * | 28 | 8037 | bne * ;failed not equal (non zero)
$1f45 | bne * | 28 | 8054 | bne * ;failed not equal (non zero)
$1f4b | bne * | 28 | 8062 | bne * ;failed not equal (non zero)
$1f59 | bne * | 28 | 8079 | bne * ;failed not equal (non zero)
$1f5f | bne * | 28 | 8087 | bne * ;failed not equal (non zero)
$1f6d | bne * | 28 | 8104 | bne * ;failed not equal (non zero)
$1f73 | bne * | 28 | 8112 | bne * ;failed not equal (non zero)
$1f81 | bne * | 28 | 8129 | bne * ;failed not equal (non zero)
$1f87 | bne * | 28 | 8137 | bne * ;failed not equal (non zero)
$1f96 | bne * | 28 | 8155 | bne * ;failed not equal (non zero)
$1f9c | bne * | 28 | 8163 | bne * ;failed not equal (non zero)
$1fab | bne * | 28 | 8180 | bne * ;failed not equal (non zero)
$1fb1 | bne * | 28 | 8188 | bne * ;failed not equal (non zero)
$1fc0 | bne * | 28 | 8205 | bne * ;failed not equal (non zero)
$1fc6 | bne * | 28 | 8213 | bne * ;failed not equal (non zero)
$1fd5 | bne * | 28 | 8230 | bne * ;failed not equal (non zero)
$1fdb | bne * | 28 | 8238 | bne * ;failed not equal (non zero)
$1fea | bne * | 28 | 8255 | bne * ;failed not equal (non zero)
$1ff0 | bne * | 28 | 8263 | bne * ;failed not equal (non zero)
$1fff | bne * | 28 | 8280 | bne * ;failed not equal (non zero)
$2005 | bne * | 28 | 8288 | bne * ;failed not equal (non zero)
$2013 | bne * | 28 | 8306 | bne * ;failed not equal (non zero)
$2019 | bne * | 28 | 8314 | bne * ;failed not equal (non zero)
$2027 | bne * | 28 | 8331 | bne * ;failed not equal (non zero)
$202d | bne * | 28 | 8339 | bne * ;failed not equal (non zero)
$203b | bne * | 28 | 8356 | bne * ;failed not equal (non zero)
$2041 | bne * | 28 | 8364 | bne * ;failed not equal (non zero)
$204f | bne * | 28 | 8381 | bne * ;failed not equal (non zero)
$2055 | bne * | 28 | 8389 | bne * ;failed not equal (non zero)
$2063 | bne * | 28 | 8406 | bne * ;failed not equal (non zero)
$2069 | bne * | 28 | 8414 | bne * ;failed not equal (non zero)
$2077 | bne * | 28 | 8431 | bne * ;failed not equal (non zero)
$207d | bne * | 28 | 8439 | bne * ;failed not equal (non zero)
$208d | bne * | 28 | 8458 | bne * ;failed not equal (non zero)
$2093 | bne * | 28 | 8466 | bne * ;failed not equal (non zero)
$20a1 | bne * | 28 | 8483 | bne * ;failed not equal (non zero)
$20a7 | bne * | 28 | 8491 | bne * ;failed not equal (non zero)
$20b5 | bne * | 28 | 8508 | bne * ;failed not equal (non zero)
$20bb | bne * | 28 | 8516 | bne * ;failed not equal (non zero)
$20c9 | bne * | 28 | 8533 | bne * ;failed not equal (non zero)
$20cf | bne * | 28 | 8541 | bne * ;failed not equal (non zero)
$20dd | bne * | 28 | 8558 | bne * ;failed not equal (non zero)
$20e3 | bne * | 28 | 8566 | bne * ;failed not equal (non zero)
$20f1 | bne * | 28 | 8583 | bne * ;failed not equal (non zero)
$20f7 | bne * | 28 | 8591 | bne * ;failed not equal (non zero)
$2106 | bne * | 28 | 8609 | bne * ;failed not equal (non zero)
$210c | bne * | 28 | 8617 | bne * ;failed not equal (non zero)
$211b | bne * | 28 | 8634 | bne * ;failed not equal (non zero)
$2121 | bne * | 28 | 8642 | bne * ;failed not equal (non zero)
$2130 | bne * | 28 | 8659 | bne * ;failed not equal (non zero)
$2136 | bne * | 28 | 8667 | bne * ;failed not equal (non zero)
$2145 | bne * | 28 | 8684 | bne * ;failed not equal (non zero)
$214b | bne * | 28 | 8692 | bne * ;failed not equal (non zero)
$215a | bne * | 28 | 8709 | bne * ;failed not equal (non zero)
$2160 | bne * | 28 | 8717 | bne * ;failed not equal (non zero)
$216f | bne * | 28 | 8734 | bne * ;failed not equal (non zero)
$2175 | bne * | 28 | 8742 | bne * ;failed not equal (non zero)
$2188 | bne * | 28 | 8762 | bne * ;failed not equal (non zero)
$218e | bne * | 28 | 8770 | bne * ;failed not equal (non zero)
$219d | bne * | 28 | 8787 | bne * ;failed not equal (non zero)
$21a3 | bne * | 28 | 8795 | bne * ;failed not equal (non zero)
$21b2 | bne * | 28 | 8812 | bne * ;failed not equal (non zero)
$21b8 | bne * | 28 | 8820 | bne * ;failed not equal (non zero)
$21c7 | bne * | 28 | 8837 | bne * ;failed not equal (non zero)
$21cd | bne * | 28 | 8845 | bne * ;failed not equal (non zero)
$21dc | bne * | 28 | 8862 | bne * ;failed not equal (non zero)
$21e2 | bne * | 28 | 8870 | bne * ;failed not equal (non zero)
$21f1 | bne * | 28 | 8887 | bne * ;failed not equal (non zero)
$21f7 | bne * | 28 | 8895 | bne * ;failed not equal (non zero)
$2205 | bne * | 28 | 8913 | bne * ;failed not equal (non zero)
$220b | bne * | 28 | 8921 | bne * ;failed not equal (non zero)
$2219 | bne * | 28 | 8938 | bne * ;failed not equal (non zero)
$221f | bne * | 28 | 8946 | bne * ;failed not equal (non zero)
$222d | bne * | 28 | 8963 | bne * ;failed not equal (non zero)
$2233 | bne * | 28 | 8971 | bne * ;failed not equal (non zero)
$2241 | bne * | 28 | 8988 | bne * ;failed not equal (non zero)
$2247 | bne * | 28 | 8996 | bne * ;failed not equal (non zero)
$2255 | bne * | 28 | 9013 | bne * ;failed not equal (non zero)
$225b | bne * | 28 | 9021 | bne * ;failed not equal (non zero)
$2269 | bne * | 28 | 9038 | bne * ;failed not equal (non zero)
$226f | bne * | 28 | 9046 | bne * ;failed not equal (non zero)
$227d | bne * | 28 | 9064 | bne * ;failed not equal (non zero)
$2283 | bne * | 28 | 9072 | bne * ;failed not equal (non zero)
$2291 | bne * | 28 | 9089 | bne * ;failed not equal (non zero)
$2297 | bne * | 28 | 9097 | bne * ;failed not equal (non zero)
$22a5 | bne * | 28 | 9114 | bne * ;failed not equal (non zero)
$22ab | bne * | 28 | 9122 | bne * ;failed not equal (non zero)
$22b9 | bne * | 28 | 9139 | bne * ;failed not equal (non zero)
$22bf | bne * | 28 | 9147 | bne * ;failed not equal (non zero)
$22cd | bne * | 28 | 9164 | bne * ;failed not equal (non zero)
$22d3 | bne * | 28 | 9172 | bne * ;failed not equal (non zero)
$22e1 | bne * | 28 | 9189 | bne * ;failed not equal (non zero)
$22e7 | bne * | 28 | 9197 | bne * ;failed not equal (non zero)
$22ef | bne * | 28 | 9205 | bne * ;failed not equal (non zero)
$2303 | bne * | 29 | 9230 | bne * ;failed not equal (non zero)
$230b | bne * | 29 | 9238 | bne * ;failed not equal (non zero)
$231d | bne * | 29 | 9258 | bne * ;failed not equal (non zero)
$2325 | bne * | 29 | 9266 | bne * ;failed not equal (non zero)
$2337 | bne * | 29 | 9287 | bne * ;failed not equal (non zero)
$233f | bne * | 29 | 9295 | bne * ;failed not equal (non zero)
$2351 | bne * | 29 | 9315 | bne * ;failed not equal (non zero)
$2359 | bne * | 29 | 9323 | bne * ;failed not equal (non zero)
$236b | bne * | 29 | 9344 | bne * ;failed not equal (non zero)
$2373 | bne * | 29 | 9352 | bne * ;failed not equal (non zero)
$2385 | bne * | 29 | 9372 | bne * ;failed not equal (non zero)
$238d | bne * | 29 | 9380 | bne * ;failed not equal (non zero)
$239f | bne * | 29 | 9401 | bne * ;failed not equal (non zero)
$23a7 | bne * | 29 | 9409 | bne * ;failed not equal (non zero)
$23b9 | bne * | 29 | 9429 | bne * ;failed not equal (non zero)
$23c1 | bne * | 29 | 9437 | bne * ;failed not equal (non zero)
$23d3 | bne * | 29 | 9458 | bne * ;failed not equal (non zero)
$23db | bne * | 29 | 9466 | bne * ;failed not equal (non zero)
$23ed | bne * | 29 | 9486 | bne * ;failed not equal (non zero)
$23f5 | bne * | 29 | 9494 | bne * ;failed not equal (non zero)
$2407 | bne * | 29 | 9515 | bne * ;failed not equal (non zero)
$240f | bne * | 29 | 9523 | bne * ;failed not equal (non zero)
$2421 | bne * | 29 | 9543 | bne * ;failed not equal (non zero)
$2429 | bne * | 29 | 9551 | bne * ;failed not equal (non zero)
$2433 | bne * | 29 | 9560 | bne * ;failed not equal (non zero)
$244c | bne * | 30 | 9586 | bne * ;failed not equal (non zero)
$2454 | bne * | 30 | 9594 | bne * ;failed not equal (non zero)
$246b | bne * | 30 | 9616 | bne * ;failed not equal (non zero)
$2473 | bne * | 30 | 9624 | bne * ;failed not equal (non zero)
$248a | bne * | 30 | 9647 | bne * ;failed not equal (non zero)
$2492 | bne * | 30 | 9655 | bne * ;failed not equal (non zero)
$24a9 | bne * | 30 | 9677 | bne * ;failed not equal (non zero)
$24b1 | bne * | 30 | 9685 | bne * ;failed not equal (non zero)
$24c8 | bne * | 30 | 9708 | bne * ;failed not equal (non zero)
$24d0 | bne * | 30 | 9716 | bne * ;failed not equal (non zero)
$24e7 | bne * | 30 | 9738 | bne * ;failed not equal (non zero)
$24ef | bne * | 30 | 9746 | bne * ;failed not equal (non zero)
$2506 | bne * | 30 | 9769 | bne * ;failed not equal (non zero)
$250e | bne * | 30 | 9777 | bne * ;failed not equal (non zero)
$2525 | bne * | 30 | 9799 | bne * ;failed not equal (non zero)
$252d | bne * | 30 | 9807 | bne * ;failed not equal (non zero)
$2544 | bne * | 30 | 9830 | bne * ;failed not equal (non zero)
$254c | bne * | 30 | 9838 | bne * ;failed not equal (non zero)
$2563 | bne * | 30 | 9860 | bne * ;failed not equal (non zero)
$256b | bne * | 30 | 9868 | bne * ;failed not equal (non zero)
$2582 | bne * | 30 | 9891 | bne * ;failed not equal (non zero)
$258a | bne * | 30 | 9899 | bne * ;failed not equal (non zero)
$25a1 | bne * | 30 | 9921 | bne * ;failed not equal (non zero)
$25a9 | bne * | 30 | 9929 | bne * ;failed not equal (non zero)
$25b3 | bne * | 30 | 9938 | bne * ;failed not equal (non zero)
$25cf | bne * | 31 | 9964 | bne * ;failed not equal (non zero)
$25d7 | bne * | 31 | 9972 | bne * ;failed not equal (non zero)
$25f1 | bne * | 31 | 9994 | bne * ;failed not equal (non zero)
$25f9 | bne * | 31 | 10002 | bne * ;failed not equal (non zero)
$2613 | bne * | 31 | 10025 | bne * ;failed not equal (non zero)
$261b | bne * | 31 | 10033 | bne * ;failed not equal (non zero)
$2635 | bne * | 31 | 10055 | bne * ;failed not equal (non zero)
$263d | bne * | 31 | 10063 | bne * ;failed not equal (non zero)
$2657 | bne * | 31 | 10086 | bne * ;failed not equal (non zero)
$265f | bne * | 31 | 10094 | bne * ;failed not equal (non zero)
$2679 | bne * | 31 | 10116 | bne * ;failed not equal (non zero)
$2681 | bne * | 31 | 10124 | bne * ;failed not equal (non zero)
$269b | bne * | 31 | 10147 | bne * ;failed not equal (non zero)
$26a3 | bne * | 31 | 10155 | bne * ;failed not equal (non zero)
$26bd | bne * | 31 | 10177 | bne * ;failed not equal (non zero)
$26c5 | bne * | 31 | 10185 | bne * ;failed not equal (non zero)
$26df | bne * | 31 | 10208 | bne * ;failed not equal (non zero)
$26e7 | bne * | 31 | 10216 | bne * ;failed not equal (non zero)
$2701 | bne * | 31 | 10238 | bne * ;failed not equal (non zero)
$2709 | bne * | 31 | 10246 | bne * ;failed not equal (non zero)
$2723 | bne * | 31 | 10269 | bne * ;failed not equal (non zero)
$272b | bne * | 31 | 10277 | bne * ;failed not equal (non zero)
$2745 | bne * | 31 | 10299 | bne * ;failed not equal (non zero)
$274d | bne * | 31 | 10307 | bne * ;failed not equal (non zero)
$2757 | bne * | 31 | 10316 | bne * ;failed not equal (non zero)
$2770 | bne * | 32 | 10342 | bne * ;failed not equal (non zero)
$2778 | bne * | 32 | 10350 | bne * ;failed not equal (non zero)
$278f | bne * | 32 | 10372 | bne * ;failed not equal (non zero)
$2797 | bne * | 32 | 10380 | bne * ;failed not equal (non zero)
$27ae | bne * | 32 | 10403 | bne * ;failed not equal (non zero)
$27b6 | bne * | 32 | 10411 | bne * ;failed not equal (non zero)
$27cd | bne * | 32 | 10433 | bne * ;failed not equal (non zero)
$27d5 | bne * | 32 | 10441 | bne * ;failed not equal (non zero)
$27ec | bne * | 32 | 10464 | bne * ;failed not equal (non zero)
$27f4 | bne * | 32 | 10472 | bne * ;failed not equal (non zero)
$280b | bne * | 32 | 10494 | bne * ;failed not equal (non zero)
$2813 | bne * | 32 | 10502 | bne * ;failed not equal (non zero)
$282a | bne * | 32 | 10525 | bne * ;failed not equal (non zero)
$2832 | bne * | 32 | 10533 | bne * ;failed not equal (non zero)
$2849 | bne * | 32 | 10555 | bne * ;failed not equal (non zero)
$2851 | bne * | 32 | 10563 | bne * ;failed not equal (non zero)
$2868 | bne * | 32 | 10586 | bne * ;failed not equal (non zero)
$2870 | bne * | 32 | 10594 | bne * ;failed not equal (non zero)
$2887 | bne * | 32 | 10616 | bne * ;failed not equal (non zero)
$288f | bne * | 32 | 10624 | bne * ;failed not equal (non zero)
$28a6 | bne * | 32 | 10647 | bne * ;failed not equal (non zero)
$28ae | bne * | 32 | 10655 | bne * ;failed not equal (non zero)
$28c5 | bne * | 32 | 10677 | bne * ;failed not equal (non zero)
$28cd | bne * | 32 | 10685 | bne * ;failed not equal (non zero)
$28d7 | bne * | 32 | 10694 | bne * ;failed not equal (non zero)
$28f3 | bne * | 33 | 10720 | bne * ;failed not equal (non zero)
$28fb | bne * | 33 | 10728 | bne * ;failed not equal (non zero)
$2915 | bne * | 33 | 10750 | bne * ;failed not equal (non zero)
$291d | bne * | 33 | 10758 | bne * ;failed not equal (non zero)
$2937 | bne * | 33 | 10781 | bne * ;failed not equal (non zero)
$293f | bne * | 33 | 10789 | bne * ;failed not equal (non zero)
$2959 | bne * | 33 | 10811 | bne * ;failed not equal (non zero)
$2961 | bne * | 33 | 10819 | bne * ;failed not equal (non zero)
$297b | bne * | 33 | 10842 | bne * ;failed not equal (non zero)
$2983 | bne * | 33 | 10850 | bne * ;failed not equal (non zero)
$299d | bne * | 33 | 10872 | bne * ;failed not equal (non zero)
$29a5 | bne * | 33 | 10880 | bne * ;failed not equal (non zero)
$29bf | bne * | 33 | 10903 | bne * ;failed not equal (non zero)
$29c7 | bne * | 33 | 10911 | bne * ;failed not equal (non zero)
$29e1 | bne * | 33 | 10933 | bne * ;failed not equal (non zero)
$29e9 | bne * | 33 | 10941 | bne * ;failed not equal (non zero)
$2a03 | bne * | 33 | 10964 | bne * ;failed not equal (non zero)
$2a0b | bne * | 33 | 10972 | bne * ;failed not equal (non zero)
$2a25 | bne * | 33 | 10994 | bne * ;failed not equal (non zero)
$2a2d | bne * | 33 | 11002 | bne * ;failed not equal (non zero)
$2a47 | bne * | 33 | 11025 | bne * ;failed not equal (non zero)
$2a4f | bne * | 33 | 11033 | bne * ;failed not equal (non zero)
$2a69 | bne * | 33 | 11055 | bne * ;failed not equal (non zero)
$2a71 | bne * | 33 | 11063 | bne * ;failed not equal (non zero)
$2a7b | bne * | 33 | 11072 | bne * ;failed not equal (non zero)
$2a94 | bne * | 34 | 11099 | bne * ;failed not equal (non zero)
$2a9c | bne * | 34 | 11107 | bne * ;failed not equal (non zero)
$2aba | bne * | 34 | 11133 | bne * ;failed not equal (non zero)
$2ac2 | bne * | 34 | 11141 | bne * ;failed not equal (non zero)
$2ae3 | bne * | 34 | 11169 | bne * ;failed not equal (non zero)
$2aeb | bne * | 34 | 11177 | bne * ;failed not equal (non zero)
$2b09 | bne * | 34 | 11203 | bne * ;failed not equal (non zero)
$2b11 | bne * | 34 | 11211 | bne * ;failed not equal (non zero)
$2b25 | bne * | 34 | 11226 | bne * ;failed not equal (non zero)
$2b41 | bne * | 35 | 11252 | bne * ;failed not equal (non zero)
$2b49 | bne * | 35 | 11260 | bne * ;failed not equal (non zero)
$2b6b | bne * | 35 | 11286 | bne * ;failed not equal (non zero)
$2b73 | bne * | 35 | 11294 | bne * ;failed not equal (non zero)
$2b98 | bne * | 35 | 11322 | bne * ;failed not equal (non zero)
$2ba0 | bne * | 35 | 11330 | bne * ;failed not equal (non zero)
$2bc2 | bne * | 35 | 11356 | bne * ;failed not equal (non zero)
$2bca | bne * | 35 | 11364 | bne * ;failed not equal (non zero)
$2bdf | bne * | 35 | 11379 | bne * ;failed not equal (non zero)
$2bf8 | bne * | 36 | 11404 | bne * ;failed not equal (non zero)
$2c00 | bne * | 36 | 11412 | bne * ;failed not equal (non zero)
$2c20 | bne * | 36 | 11438 | bne * ;failed not equal (non zero)
$2c28 | bne * | 36 | 11446 | bne * ;failed not equal (non zero)
$2c49 | bne * | 36 | 11473 | bne * ;failed not equal (non zero)
$2c51 | bne * | 36 | 11481 | bne * ;failed not equal (non zero)
$2c71 | bne * | 36 | 11507 | bne * ;failed not equal (non zero)
$2c79 | bne * | 36 | 11515 | bne * ;failed not equal (non zero)
$2c8d | bne * | 36 | 11530 | bne * ;failed not equal (non zero)
$2ca9 | bne * | 37 | 11555 | bne * ;failed not equal (non zero)
$2cb1 | bne * | 37 | 11563 | bne * ;failed not equal (non zero)
$2cd5 | bne * | 37 | 11589 | bne * ;failed not equal (non zero)
$2cdd | bne * | 37 | 11597 | bne * ;failed not equal (non zero)
$2d02 | bne * | 37 | 11624 | bne * ;failed not equal (non zero)
$2d0a | bne * | 37 | 11632 | bne * ;failed not equal (non zero)
$2d2e | bne * | 37 | 11658 | bne * ;failed not equal (non zero)
$2d36 | bne * | 37 | 11666 | bne * ;failed not equal (non zero)
$2d4b | bne * | 37 | 11681 | bne * ;failed not equal (non zero)
$2d67 | bne * | 38 | 11707 | bne * ;failed not equal (non zero)
$2d6f | bne * | 38 | 11715 | bne * ;failed not equal (non zero)
$2d89 | bne * | 38 | 11736 | bne * ;failed not equal (non zero)
$2d91 | bne * | 38 | 11744 | bne * ;failed not equal (non zero)
$2da9 | bne * | 38 | 11766 | bne * ;failed not equal (non zero)
$2db1 | bne * | 38 | 11774 | bne * ;failed not equal (non zero)
$2dc9 | bne * | 38 | 11795 | bne * ;failed not equal (non zero)
$2dd1 | bne * | 38 | 11803 | bne * ;failed not equal (non zero)
$2deb | bne * | 38 | 11825 | bne * ;failed not equal (non zero)
$2df3 | bne * | 38 | 11833 | bne * ;failed not equal (non zero)
$2e0d | bne * | 38 | 11854 | bne * ;failed not equal (non zero)
$2e15 | bne * | 38 | 11862 | bne * ;failed not equal (non zero)
$2e29 | bne * | 38 | 11883 | bne * ;failed not equal (non zero)
$2e31 | bne * | 38 | 11891 | bne * ;failed not equal (non zero)
$2e45 | bne * | 38 | 11911 | bne * ;failed not equal (non zero)
$2e4d | bne * | 38 | 11919 | bne * ;failed not equal (non zero)
$2e62 | bne * | 38 | 11940 | bne * ;failed not equal (non zero)
$2e6a | bne * | 38 | 11948 | bne * ;failed not equal (non zero)
$2e7f | bne * | 38 | 11968 | bne * ;failed not equal (non zero)
$2e87 | bne * | 38 | 11976 | bne * ;failed not equal (non zero)
$2e9c | bne * | 38 | 11997 | bne * ;failed not equal (non zero)
$2ea4 | bne * | 38 | 12005 | bne * ;failed not equal (non zero)
$2eb9 | bne * | 38 | 12025 | bne * ;failed not equal (non zero)
$2ec1 | bne * | 38 | 12033 | bne * ;failed not equal (non zero)
$2ed7 | bne * | 38 | 12055 | bne * ;failed not equal (non zero)
$2edf | bne * | 38 | 12063 | bne * ;failed not equal (non zero)
$2ef7 | bne * | 38 | 12086 | bne * ;failed not equal (non zero)
$2eff | bne * | 38 | 12094 | bne * ;failed not equal (non zero)
$2f15 | bne * | 38 | 12117 | bne * ;failed not equal (non zero)
$2f1d | bne * | 38 | 12125 | bne * ;failed not equal (non zero)
$2f31 | bne * | 38 | 12145 | bne * ;failed not equal (non zero)
$2f39 | bne * | 38 | 12153 | bne * ;failed not equal (non zero)
$2f43 | bne * | 38 | 12162 | bne * ;failed not equal (non zero)
$2f5f | bne * | 39 | 12187 | bne * ;failed not equal (non zero)
$2f67 | bne * | 39 | 12195 | bne * ;failed not equal (non zero)
$2f81 | bne * | 39 | 12216 | bne * ;failed not equal (non zero)
$2f89 | bne * | 39 | 12224 | bne * ;failed not equal (non zero)
$2fa1 | bne * | 39 | 12246 | bne * ;failed not equal (non zero)
$2fa9 | bne * | 39 | 12254 | bne * ;failed not equal (non zero)
$2fc1 | bne * | 39 | 12275 | bne * ;failed not equal (non zero)
$2fc9 | bne * | 39 | 12283 | bne * ;failed not equal (non zero)
$2fe3 | bne * | 39 | 12305 | bne * ;failed not equal (non zero)
$2feb | bne * | 39 | 12313 | bne * ;failed not equal (non zero)
$3005 | bne * | 39 | 12334 | bne * ;failed not equal (non zero)
$300d | bne * | 39 | 12342 | bne * ;failed not equal (non zero)
$3021 | bne * | 39 | 12363 | bne * ;failed not equal (non zero)
$3029 | bne * | 39 | 12371 | bne * ;failed not equal (non zero)
$303d | bne * | 39 | 12391 | bne * ;failed not equal (non zero)
$3045 | bne * | 39 | 12399 | bne * ;failed not equal (non zero)
$305a | bne * | 39 | 12420 | bne * ;failed not equal (non zero)
$3062 | bne * | 39 | 12428 | bne * ;failed not equal (non zero)
$3077 | bne * | 39 | 12448 | bne * ;failed not equal (non zero)
$307f | bne * | 39 | 12456 | bne * ;failed not equal (non zero)
$3094 | bne * | 39 | 12477 | bne * ;failed not equal (non zero)
$309c | bne * | 39 | 12485 | bne * ;failed not equal (non zero)
$30b1 | bne * | 39 | 12505 | bne * ;failed not equal (non zero)
$30b9 | bne * | 39 | 12513 | bne * ;failed not equal (non zero)
$30cf | bne * | 39 | 12535 | bne * ;failed not equal (non zero)
$30d7 | bne * | 39 | 12543 | bne * ;failed not equal (non zero)
$30ef | bne * | 39 | 12566 | bne * ;failed not equal (non zero)
$30f7 | bne * | 39 | 12574 | bne * ;failed not equal (non zero)
$310d | bne * | 39 | 12597 | bne * ;failed not equal (non zero)
$3115 | bne * | 39 | 12605 | bne * ;failed not equal (non zero)
$3129 | bne * | 39 | 12625 | bne * ;failed not equal (non zero)
$3131 | bne * | 39 | 12633 | bne * ;failed not equal (non zero)
$313b | bne * | 39 | 12642 | bne * ;failed not equal (non zero)
$3157 | bne * | 40 | 12667 | bne * ;failed not equal (non zero)
$315f | bne * | 40 | 12675 | bne * ;failed not equal (non zero)
$3179 | bne * | 40 | 12696 | bne * ;failed not equal (non zero)
$3181 | bne * | 40 | 12704 | bne * ;failed not equal (non zero)
$3199 | bne * | 40 | 12726 | bne * ;failed not equal (non zero)
$31a1 | bne * | 40 | 12734 | bne * ;failed not equal (non zero)
$31b9 | bne * | 40 | 12755 | bne * ;failed not equal (non zero)
$31c1 | bne * | 40 | 12763 | bne * ;failed not equal (non zero)
$31db | bne * | 40 | 12785 | bne * ;failed not equal (non zero)
$31e3 | bne * | 40 | 12793 | bne * ;failed not equal (non zero)
$31fd | bne * | 40 | 12814 | bne * ;failed not equal (non zero)
$3205 | bne * | 40 | 12822 | bne * ;failed not equal (non zero)
$3219 | bne * | 40 | 12843 | bne * ;failed not equal (non zero)
$3221 | bne * | 40 | 12851 | bne * ;failed not equal (non zero)
$3235 | bne * | 40 | 12871 | bne * ;failed not equal (non zero)
$323d | bne * | 40 | 12879 | bne * ;failed not equal (non zero)
$3252 | bne * | 40 | 12900 | bne * ;failed not equal (non zero)
$325a | bne * | 40 | 12908 | bne * ;failed not equal (non zero)
$326f | bne * | 40 | 12928 | bne * ;failed not equal (non zero)
$3277 | bne * | 40 | 12936 | bne * ;failed not equal (non zero)
$328c | bne * | 40 | 12957 | bne * ;failed not equal (non zero)
$3294 | bne * | 40 | 12965 | bne * ;failed not equal (non zero)
$32a9 | bne * | 40 | 12985 | bne * ;failed not equal (non zero)
$32b1 | bne * | 40 | 12993 | bne * ;failed not equal (non zero)
$32c7 | bne * | 40 | 13015 | bne * ;failed not equal (non zero)
$32cf | bne * | 40 | 13023 | bne * ;failed not equal (non zero)
$32e7 | bne * | 40 | 13046 | bne * ;failed not equal (non zero)
$32ef | bne * | 40 | 13054 | bne * ;failed not equal (non zero)
$3305 | bne * | 40 | 13077 | bne * ;failed not equal (non zero)
$330d | bne * | 40 | 13085 | bne * ;failed not equal (non zero)
$3321 | bne * | 40 | 13105 | bne * ;failed not equal (non zero)
$3329 | bne * | 40 | 13113 | bne * ;failed not equal (non zero)
$3334 | bne * | 40 | 13125 | bne * ;failed not equal (non zero)
$3399 | bne * | 41 | 13187 | bne * ;failed not equal (non zero)
$343d | bne * | 42 | 13280 | bne * ;failed not equal (non zero)
$344d | bne * | 43 | 13298 | bne * ;failed not equal (non zero)
$3458 | bne * | 43 | 13307 | bne * ;failed not equal (non zero)
$3462 | bne * | 43 | 13315 | bne * ;failed not equal (non zero)
$346b | bne * | 43 | 13322 | bne * ;failed not equal (non zero)
$3485 | bne * | 43 | 13343 | bne * ;failed not equal (non zero)
$348e | bne * | 43 | 13351 | bne * ;failed not equal (non zero)
$3495 | bne * | 43 | 13358 | bne * ;failed not equal (non zero)
$34cf | bne * | 240 | 13398 | bne * ;failed not equal (non zero)
$34d6 | bne * | 240 | 13403 | bne * ;failed not equal (non zero)
$34d8 | jmp * (PASS) | 240 | 13416 | jmp * ;test passed, no errors
$34e6 | bne * | 240 | 13436 | bne * ;failed not equal (non zero)
$34ed | bne * | 240 | 13442 | bne * ;failed not equal (non zero)
$34f8 | bne * | 240 | 13451 | bne * ;failed not equal (non zero)
$34ff | bne * | 240 | 13457 | bne * ;failed not equal (non zero)
$350b | bne * | 240 | 13467 | bne * ;failed not equal (non zero)
$3512 | bne * | 240 | 13473 | bne * ;failed not equal (non zero)
$351e | bne * | 240 | 13482 | bne * ;failed not equal (non zero)
$3525 | bne * | 240 | 13488 | bne * ;failed not equal (non zero)
$3536 | bne * | 240 | 13500 | bne * ;failed not equal (non zero)
$353d | bne * | 240 | 13506 | bne * ;failed not equal (non zero)
$354e | bne * | 240 | 13517 | bne * ;failed not equal (non zero)
$3555 | bne * | 240 | 13523 | bne * ;failed not equal (non zero)
$3560 | bne * | 240 | 13533 | bne * ;failed not equal (non zero)
$3567 | bne * | 240 | 13539 | bne * ;failed not equal (non zero)
$3572 | bne * | 240 | 13548 | bne * ;failed not equal (non zero)
$3579 | bne * | 240 | 13554 | bne * ;failed not equal (non zero)
$3585 | bne * | 240 | 13564 | bne * ;failed not equal (non zero)
$358c | bne * | 240 | 13570 | bne * ;failed not equal (non zero)
$3598 | bne * | 240 | 13579 | bne * ;failed not equal (non zero)
$359f | bne * | 240 | 13585 | bne * ;failed not equal (non zero)
$35ab | bne * | 240 | 13595 | bne * ;failed not equal (non zero)
$35b2 | bne * | 240 | 13601 | bne * ;failed not equal (non zero)
$35be | bne * | 240 | 13610 | bne * ;failed not equal (non zero)
$35c5 | bne * | 240 | 13616 | bne * ;failed not equal (non zero)
$35d0 | bne * | 240 | 13626 | bne * ;failed not equal (non zero)
$35d7 | bne * | 240 | 13632 | bne * ;failed not equal (non zero)
$35e2 | bne * | 240 | 13641 | bne * ;failed not equal (non zero)
$35e9 | bne * | 240 | 13647 | bne * ;failed not equal (non zero)
$35f4 | bne * | 240 | 13657 | bne * ;failed not equal (non zero)
$35fb | bne * | 240 | 13663 | bne * ;failed not equal (non zero)
$3606 | bne * | 240 | 13672 | bne * ;failed not equal (non zero)
$360d | bne * | 240 | 13678 | bne * ;failed not equal (non zero)
$3631 | bne * | 240 | 13708 | bne * ;failed not equal (non zero)
$3638 | bne * | 240 | 13714 | bne * ;failed not equal (non zero)
$3643 | bne * | 240 | 13723 | bne * ;failed not equal (non zero)
$364a | bne * | 240 | 13729 | bne * ;failed not equal (non zero)
$3656 | bne * | 240 | 13739 | bne * ;failed not equal (non zero)
$365d | bne * | 240 | 13745 | bne * ;failed not equal (non zero)
$3669 | bne * | 240 | 13754 | bne * ;failed not equal (non zero)
$3670 | bne * | 240 | 13760 | bne * ;failed not equal (non zero)
$3681 | bne * | 240 | 13772 | bne * ;failed not equal (non zero)
$3688 | bne * | 240 | 13778 | bne * ;failed not equal (non zero)
$3699 | bne * | 240 | 13789 | bne * ;failed not equal (non zero)
$36a0 | bne * | 240 | 13795 | bne * ;failed not equal (non zero)
$36ab | bne * | 240 | 13805 | bne * ;failed not equal (non zero)
$36b2 | bne * | 240 | 13811 | bne * ;failed not equal (non zero)
$36bd | bne * | 240 | 13820 | bne * ;failed not equal (non zero)
$36c4 | bne * | 240 | 13826 | bne * ;failed not equal (non zero)
$36d0 | bne * | 240 | 13836 | bne * ;failed not equal (non zero)
$36d7 | bne * | 240 | 13842 | bne * ;failed not equal (non zero)
$36e3 | bne * | 240 | 13851 | bne * ;failed not equal (non zero)
$36ea | bne * | 240 | 13857 | bne * ;failed not equal (non zero)
$36f6 | bne * | 240 | 13867 | bne * ;failed not equal (non zero)
$36fd | bne * | 240 | 13873 | bne * ;failed not equal (non zero)
$3709 | bne * | 240 | 13882 | bne * ;failed not equal (non zero)
$3710 | bne * | 240 | 13888 | bne * ;failed not equal (non zero)
$371b | bne * | 240 | 13898 | bne * ;failed not equal (non zero)
$3722 | bne * | 240 | 13904 | bne * ;failed not equal (non zero)
$372d | bne * | 240 | 13913 | bne * ;failed not equal (non zero)
$3734 | bne * | 240 | 13919 | bne * ;failed not equal (non zero)
$373f | bne * | 240 | 13929 | bne * ;failed not equal (non zero)
$3746 | bne * | 240 | 13935 | bne * ;failed not equal (non zero)
$3751 | bne * | 240 | 13944 | bne * ;failed not equal (non zero)
$3758 | bne * | 240 | 13950 | bne * ;failed not equal (non zero)
$3763 | bcs * | 240 | 13965 | bcs * ;failed carry set
$3765 | bvs * | 240 | 13968 | bvs * ;failed overflow set
$3767 | bmi * | 240 | 13971 | bmi * ;failed minus (bit 7 set)
$3769 | beq * | 240 | 13974 | beq * ;failed equal (zero)
$376d | bne * | 240 | 13978 | bne * ;failed not equal (non zero)
$3771 | bne * | 240 | 13982 | bne * ;failed not equal (non zero)
$3775 | bne * | 240 | 13986 | bne * ;failed not equal (non zero)
$377d | bne * | 240 | 13994 | bne * ;failed not equal (non zero)
$3790 | jmp * | 240 | 14015 | jmp * ;failed anyway
$379a | bcs * | 240 | 14026 | bcs * ;failed carry set
$379c | bvs * | 240 | 14029 | bvs * ;failed overflow set
$379e | bmi * | 240 | 14032 | bmi * ;failed minus (bit 7 set)
$37a0 | beq * | 240 | 14035 | beq * ;failed equal (zero)
$37a4 | bne * | 240 | 14039 | bne * ;failed not equal (non zero)
$37a8 | bne * | 240 | 14043 | bne * ;failed not equal (non zero)
$37ac | bne * | 240 | 14047 | bne * ;failed not equal (non zero)
$37b4 | bne * | 240 | 14055 | bne * ;failed not equal (non zero)
$37c3 | jmp * | 240 | 14071 | jmp * ;failed anyway
$37d0 | bcs * | 240 | 14085 | bcs * ;failed carry set
$37d2 | bvs * | 240 | 14088 | bvs * ;failed overflow set
$37d4 | bmi * | 240 | 14091 | bmi * ;failed minus (bit 7 set)
$37d6 | beq * | 240 | 14094 | beq * ;failed equal (zero)
$37da | bne * | 240 | 14098 | bne * ;failed not equal (non zero)
$37de | bne * | 240 | 14102 | bne * ;failed not equal (non zero)
$37e2 | bne * | 240 | 14106 | bne * ;failed not equal (non zero)
$37ea | bne * | 240 | 14114 | bne * ;failed not equal (non zero)
$37f1 | bne * | 240 | 14119 | bne * ;failed not equal (non zero)
$37f8 | bne * | 240 | 14124 | bne * ;failed not equal (non zero)
$3805 | jmp * | 240 | 14140 | jmp * ;failed anyway
$380b | jmp * | 240 | 14147 | jmp * ;failed anyway
$3811 | jmp * | 240 | 14152 | jmp * ;failed anyway
$3823 | bne * | 240 | 14170 | bne * ;failed not equal (non zero)
$3827 | bne * | 240 | 14174 | bne * ;failed not equal (non zero)
$382b | bne * | 240 | 14178 | bne * ;failed not equal (non zero)
$3837 | bne * | 240 | 14188 | bne * ;failed not equal (non zero)
$383c | bne * | 240 | 14195 | bne * ;failed not equal (non zero)
$3841 | bne * | 240 | 14200 | bne * ;failed not equal (non zero)
$3848 | bne * | 240 | 14205 | bne * ;failed not equal (non zero)
$384f | bne * | 240 | 14210 | bne * ;failed not equal (non zero)
$385d | jmp * | 240 | 14223 | jmp * ;failed anyway
$3865 | bne * | 240 | 14230 | bne * ;failed not equal (non zero)
$3869 | bne * | 240 | 14234 | bne * ;failed not equal (non zero)
$3875 | bne * | 240 | 14244 | bne * ;failed not equal (non zero)
$387c | bne * | 240 | 14252 | bne * ;failed not equal (non zero)
$3881 | bne * | 240 | 14257 | bne * ;failed not equal (non zero)
$3888 | bne * | 240 | 14262 | bne * ;failed not equal (non zero)
$388f | bne * | 240 | 14267 | bne * ;failed not equal (non zero)
$389d | jmp * | 240 | 14280 | jmp * ;failed anyway
