epatel/discrete6502/pico-controller/wifi/main.c

// discrete6502 wifi firmware — control and observe the CPU from a browser.
//
// Motivation: the 6502 functional test suite is an hours-long run at our
// 10-20 kHz clock. Sitting at a serial terminal for that is no way to work,
// so this firmware puts the same controls on a web page: upload the Intel
// hex, start it, and watch test_case climb from anywhere.
//
// ARCHITECTURE — the one rule that matters:
//
//   core 1  the bus engine, and nothing else. Never touches lwIP, cyw43 or
//           stdio. It is the clock master for a DYNAMIC-logic CPU, so a
//           stretched clock phase is a correctness bug, not a hiccup.
//   core 0  wifi, lwIP, HTTP. Blocks freely; nobody cares.
//
// The two share a snapshot struct (core 1 writes, core 0 reads) and an SDK
// multicore queue for commands (core 0 writes, core 1 reads). This is why
// wifi is safe here at all: association and DHCP block for milliseconds at a
// time, which would be fatal inside the clock loop but is invisible on
// another core. functest is put in quiet mode for the same reason — its
// printf would block core 1 on USB stdio.
//
// Build: cmake -DWIFI_SSID=... -DWIFI_PASSWORD=... (never committed)
#include "bus6502.h"
#include "console.h"
#include "functest.h"
#include "functest_images.h"
#include "ihex.h"
#include "page.h"
#include "retention.h"

#include "lwip/apps/mdns.h"
#include "lwip/tcp.h"
#include "pico/cyw43_arch.h"
#include "netsrv.h"
#include "pico/multicore.h"
#include "pico/stdlib.h"
#include "pico/util/queue.h"
#include "hardware/watchdog.h"
#include "settings.h"
#include <stdio.h>
#include <string.h>

// Credentials now live in flash (common/settings.c) and are set through the
// captive portal. These remain only as optional build-time seeds for a board
// you want to arrive pre-provisioned; a plain build has neither.
#ifndef WIFI_SSID
#define WIFI_SSID ""
#endif
#ifndef WIFI_PASSWORD
#define WIFI_PASSWORD ""
#endif

#define HTTP_PORT 80
#define MIRROR_LEN 32u  // recent cycles core 0 may read
#define MAX_CONN 4

// ---- shared state ---------------------------------------------------------

// Core 1 writes, core 0 reads. Fields are word-sized and individually atomic
// on ARM; a reader can still catch two adjacent cycles mixed, which for a
// twice-a-second display is not worth a lock in the clock loop.
static volatile uint32_t s_cycle, s_half = 50, s_low = 0;  // s_low 0 = symmetric
static volatile uint16_t s_addr, s_trap_addr;
static volatile uint8_t s_data, s_flags, s_test_case, s_trapped, s_ft_on;
// The trap verdict, which the firmware already knows and never told anyone:
// with -DEMBED_FUNCTEST=ON the trap table maps a self-loop address to pass/fail
// and its line in the assembly listing. Without it, s_trap_known stays 0 and the
// page falls back to reporting the bare address.
static volatile uint8_t s_trap_known, s_trap_pass;
static volatile uint16_t s_trap_line;
static volatile bool s_running;

static bus_trace_t mirror[MIRROR_LEN];
static volatile uint32_t mirror_count;

// retention test state: core 1 runs it, core 0 only reports it. s_ret_seq
// increments once per completed trial so the page can log each result exactly
// once without needing an event channel.
static volatile uint8_t s_ret_busy, s_ret_verdict, s_ret_last_ok;
static volatile uint32_t s_ret_seq, s_ret_last_ms, s_ret_good, s_ret_bad;

static queue_t cmd_q;
typedef struct {
    uint8_t op;
    uint32_t arg;
} cmd_t;
enum { CMD_RUN, CMD_STOP, CMD_RESET, CMD_STEP, CMD_CLOCK, CMD_CLOCKLOW, CMD_FT,
       CMD_RET, CMD_RETSCAN, CMD_RESETRUN };

// ---- core 1: the bus engine ----------------------------------------------

static bool __not_in_flash_func(publish)(const bus_trace_t *t) {
    s_cycle = t->cycle;
    s_addr = t->addr;
    s_data = t->data;
    s_flags = (uint8_t)((t->rw_read ? 1u : 0u) | (t->sync ? 2u : 0u));

    uint32_t i = mirror_count;
    mirror[i % MIRROR_LEN] = *t;
    mirror_count = i + 1;

    bool go = functest_watch(t);
    const functest_state_t *f = functest_state();
    s_test_case = f->test_case;
    s_trapped = f->trapped ? 1u : 0u;
    s_trap_addr = f->trap_addr;
    s_trap_known = f->trap ? 1u : 0u;
    s_trap_pass = (f->trap && f->trap_is_pass) ? 1u : 0u;
    s_trap_line = f->trap ? f->trap->line : 0u;
    return go;
}

// Published after every trial. Runs on core 1; core 0 reads the snapshot.
static void ret_report(uint32_t us, bool survived) {
    s_ret_last_ms = us;   // microseconds since 2026-07-31
    s_ret_last_ok = survived ? 1u : 0u;
    s_ret_seq++;
}

// A scan can take minutes, during which core 1 is not reading commands. Peek
// at the queue between trials so the page's stop button still works.
static bool ret_abort(void) {
    cmd_t c;
    if (queue_try_peek(&cmd_q, &c) && c.op == CMD_STOP) {
        queue_try_remove(&cmd_q, &c);
        return true;
    }
    return false;
}

static void __not_in_flash_func(core1_main)(void) {
    // Required before core 0 may write flash. Erasing turns XIP off, so this
    // core has to be parked somewhere that is not flash; without registering,
    // flash_safe_execute() refuses and every settings/image save fails.
    //
    // Note what being parked costs: a sector erase takes tens of milliseconds
    // and the worst dynamic node holds charge for about 1.1 ms (measured, board
    // #1). A flash write therefore DESTROYS the 6502's state. Stop the CPU and
    // reset it afterwards -- never save while a program is running.
    multicore_lockout_victim_init();

    bool run = false;
    uint32_t budget = 0;   // cycles left to run; 0 = unbounded
    for (;;) {
        cmd_t c;
        while (queue_try_remove(&cmd_q, &c)) {
            switch (c.op) {
            case CMD_RET:
                s_ret_busy = 1; s_ret_verdict = 0; s_ret_seq = 0;
                run = false; s_running = false;
                retention_load_image();
                ret_report(c.arg, retention_trial(c.arg));
                s_ret_good = s_ret_last_ok ? c.arg : 0;
                s_ret_bad = s_ret_last_ok ? 0 : c.arg;
                s_ret_verdict = (uint8_t)(RET_SCAN_BOUNDED + 1);
                s_ret_busy = 0;
                break;
            case CMD_RETSCAN: {
                s_ret_busy = 1; s_ret_verdict = 0; s_ret_seq = 0;
                run = false; s_running = false;
                uint32_t g = 0, b = 0;
                retention_scan_t r = retention_scan(c.arg ? c.arg : RET_SCAN_DEFAULT_LIMIT_US,
                                                    ret_report, ret_abort, &g, &b);
                s_ret_good = g; s_ret_bad = b;
                s_ret_verdict = (uint8_t)(r + 1);   // 0 stays "not run yet"
                s_ret_busy = 0;
                break;
            }
            case CMD_RUN:
                functest_clear();
                budget = c.arg;          // 0 = until stopped or a self-loop
                run = true;
                break;
            case CMD_RESETRUN:
                // Reset and run as ONE operation. Doing them as two commands a
                // person issues in sequence does not work on this CPU: the clock
                // parks between them and the worst dynamic node holds charge for
                // about 1.1 ms, so the reset state is gone long before the run
                // starts. Anything needing a defined start must be atomic.
                functest_clear();
                bus_reset_sequence();
                budget = c.arg;
                run = true;
                break;
            case CMD_STOP: run = false; break;
            case CMD_RESET: run = false; bus_reset_sequence(); break;
            case CMD_STEP: run = false; bus_step_instruction(64); break;
            case CMD_CLOCK:
                s_half = c.arg;
                bus_set_phase_us(s_half, s_low ? s_low : s_half);
                break;
            // The LOW phase alone. Contention flows only while the clock is
            // HIGH, so a long low phase cuts the average current without
            // touching settling time. Keep low under ~500 us: the worst dynamic
            // node holds charge for 1.13 ms (measured, board #1).
            case CMD_CLOCKLOW:
                s_low = c.arg;
                bus_set_phase_us(s_half, s_low ? s_low : s_half);
                break;
            case CMD_FT:
                if (c.arg) functest_enable(FUNCTEST_CASE_ADDR_DEFAULT);
                else functest_disable();
                s_ft_on = c.arg ? 1u : 0u;
                break;
            }
            s_running = run;
        }
        if (run) {
            uint32_t chunk = 1000;      // chunked so commands stay responsive
            if (budget && budget < chunk) chunk = budget;
            bus_run(chunk);
            if (budget) {
                budget -= chunk;
                if (!budget) { run = false; s_running = false; }
            }
            if (bus_aborted()) {        // watcher saw a self-loop
                run = false;
                s_running = false;
            }
        } else {
            sleep_us(200);
        }
    }
}

static void push(uint8_t op, uint32_t arg) {
    cmd_t c = {op, arg};
    queue_try_add(&cmd_q, &c);
}


// ---- WiFi provisioning ----------------------------------------------------
//
// Credentials live in flash, not in the build. With none stored (or if the
// stored ones fail) the Pico raises its own open access point and serves a
// setup page; a phone joining it is pushed at that page by the DNS hijack in
// common/netsrv.c. Pick a network, type the password, save, reboot.
//
// The page is served FROM the Pico, deliberately. Hosting it elsewhere is
// impossible rather than merely undesirable: GitHub Pages is HTTPS, and a
// HTTPS page may not call an http:// address on a private network -- browsers
// block it as mixed content and no CORS header changes that. And in AP mode
// there is no internet at all, which is exactly when the page is needed.

#define AP_SSID "discrete6502-setup"
#define MDNS_NAME "discrete6502"   // -> discrete6502.local
#define MAX_SCAN 16
#define SCAN_TIMEOUT_MS 15000
#define LINK_POLL_MS 5000     // how often the link is examined at all
#define LINK_GRACE_MS 20000   // consecutive downtime before we act
#define AP_RETRY_MS 300000    // AP mode re-tries the stored network this often

static bool ap_mode;
static bool mdns_up;                 // responder attached to the station netif
static absolute_time_t s_reboot_at;  // nil until /wifi/save succeeds
// Set when the AP comes up, so the periodic re-try of the stored network cannot
// fire the instant setup mode is entered. It otherwise would: the deadline
// starts at zero, which is already in the past, so the board tore its own AP
// down for 40 s of retrying exactly when someone was trying to reach the portal
// -- and killed the in-flight scan with it.
static absolute_time_t next_ap_retry;
static struct {
    char ssid[33];
    int16_t rssi;
    uint8_t auth;
} scan_res[MAX_SCAN];
static volatile uint8_t scan_n;
static volatile bool scan_busy;

static int scan_cb(void *env, const cyw43_ev_scan_result_t *r) {
    (void)env;
    if (!r || !r->ssid_len) return 0;
    char ssid[33];
    size_t n = r->ssid_len < 32 ? r->ssid_len : 32;
    memcpy(ssid, r->ssid, n);
    ssid[n] = 0;
    for (uint8_t i = 0; i < scan_n; i++)          // one row per network
        if (!strcmp(scan_res[i].ssid, ssid)) {
            if (r->rssi > scan_res[i].rssi) scan_res[i].rssi = r->rssi;
            return 0;
        }
    if (scan_n >= MAX_SCAN) return 0;
    strcpy(scan_res[scan_n].ssid, ssid);
    scan_res[scan_n].rssi = r->rssi;
    scan_res[scan_n].auth = r->auth_mode;
    scan_n++;
    return 0;
}

static absolute_time_t scan_deadline;

static void scan_start(void) {
    if (scan_busy) return;
    scan_n = 0;
    cyw43_wifi_scan_options_t o = {0};
    if (cyw43_wifi_scan(&cyw43_state, &o, NULL, scan_cb) == 0) {
        scan_busy = true;
        scan_deadline = make_timeout_time_ms(SCAN_TIMEOUT_MS);
    }
}

// A scan that never finishes must not be able to hang the portal. The page
// keeps showing "scanning..." for exactly as long as busy stays true, and the
// radio can leave a scan active indefinitely when it is fighting something else
// for the antenna, so treat a stalled scan as a finished one: the list may be
// empty, but /wifi/scan then restarts it and the user sees the state change
// rather than a spinner that means nothing.
static void scan_poll(void) {
    if (!scan_busy) return;
    if (!cyw43_wifi_scan_active(&cyw43_state)) {
        scan_busy = false;
        return;
    }
    if (absolute_time_diff_us(get_absolute_time(), scan_deadline) < 0) {
        printf("[wifi] scan stalled after %d s, giving up on it\n",
               SCAN_TIMEOUT_MS / 1000);
        scan_busy = false;
    }
}

// %XX and + decoding, in place. Query strings carry passwords, and a password
// with a space or a '#' in it is otherwise silently mangled.
static void url_decode(char *s) {
    char *w = s;
    for (; *s; s++) {
        if (*s == '+') *w++ = ' ';
        else if (*s == '%' && s[1] && s[2]) {
            char h[3] = {s[1], s[2], 0};
            *w++ = (char)strtol(h, NULL, 16);
            s += 2;
        } else *w++ = *s;
    }
    *w = 0;
}

static uint32_t auth_for(const char *pass) {
    return pass[0] ? CYW43_AUTH_WPA2_AES_PSK : CYW43_AUTH_OPEN;
}

// Two attempts: an access point that is merely slow to answer should not push
// a correctly-provisioned board into setup mode.
static bool try_sta(void) {
    const settings_t *st = settings();
    if (!st->wifi_ssid[0]) return false;
    cyw43_arch_enable_sta_mode();
    for (int i = 0; i < 2; i++) {
        printf("[wifi] connecting to %s (attempt %d)\n", st->wifi_ssid, i + 1);
        if (!cyw43_arch_wifi_connect_timeout_ms(st->wifi_ssid, st->wifi_pass,
                                                auth_for(st->wifi_pass), 20000))
            return true;
    }
    return false;
}

// Announce ourselves as MDNS_NAME.local, and advertise the panel over DNS-SD so
// it also shows up in network browsers. Only on the station interface: in setup
// mode the DNS hijack in netsrv.c already sends every name here, so mDNS there
// would be answering a question nobody asks.
static void mdns_txt(struct mdns_service *svc, void *arg) {
    (void)arg;
    mdns_resp_add_service_txtitem(svc, "path=/", 6);
}

// Safe to call again after a reconnect: mdns_resp_init() must run exactly once
// per boot, and re-adding a netif that already has the responder on it is an
// error, so a rejoin only re-announces the (possibly new) address instead.
static void start_mdns(void) {
    if (mdns_up) {
        mdns_resp_announce(netif_default);
        return;
    }
    static bool inited;
    if (!inited) {
        mdns_resp_init();
        inited = true;
    }
    if (mdns_resp_add_netif(netif_default, MDNS_NAME) != ERR_OK) {
        printf("[wifi] mDNS failed; use the address\n");
        return;
    }
    mdns_resp_add_service(netif_default, MDNS_NAME, "_http", DNSSD_PROTO_TCP,
                          HTTP_PORT, mdns_txt, NULL);
    mdns_up = true;
}

static void start_ap(void) {
    // Shut the station side down FIRST. try_sta() enables station mode and
    // nothing turned it off when it failed, so the radio arrived here still
    // retrying an association -- and a station stuck retrying starves the scan,
    // which stays "active" forever and leaves the portal on "scanning..." with
    // an empty list. This is why setup worked on a virgin board and broke after
    // one wrong password: with no SSID stored, try_sta() returns before it ever
    // enables station mode, so the AP came up on a quiet radio.
    cyw43_arch_disable_sta_mode();

    ap_mode = true;
    mdns_up = false;   // the responder was on the station netif, which is gone
    cyw43_arch_enable_ap_mode(AP_SSID, NULL, CYW43_AUTH_OPEN);

    ip4_addr_t ip, mask;
    IP4_ADDR(&ip, 192, 168, 4, 1);
    IP4_ADDR(&mask, 255, 255, 255, 0);
    struct netif *nif = &cyw43_state.netif[CYW43_ITF_AP];
    netif_set_addr(nif, &ip, &mask, &ip);

    if (!dhcpsrv_start(&ip, &mask)) printf("[wifi] DHCP server failed\n");
    if (!dnssrv_start(&ip)) printf("[wifi] DNS server failed\n");
    printf("[wifi] setup mode: join \"%s\", then http://192.168.4.1/\n", AP_SSID);
    next_ap_retry = make_timeout_time_ms(AP_RETRY_MS);
    scan_start();
}

static const char PORTAL_HTML[] =
    "HTTP/1.1 200 OK\r\nContent-Type: text/html\r\n"
    "Cache-Control: no-store\r\nConnection: close\r\n\r\n"
    "<!doctype html><meta charset=utf-8><title>discrete6502 setup</title>"
    "<meta name=viewport content='width=device-width,initial-scale=1'>"
    "<style>body{font:16px system-ui;margin:0;padding:18px;background:#111;color:#eee}"
    "h1{font-size:1.2rem}input,button{font:inherit;width:100%;padding:10px;margin:5px 0;"
    "background:#222;color:#eee;border:1px solid #444;border-radius:5px}"
    "button{background:#2a5;color:#fff;border:0;font-weight:600}"
    "li{list-style:none;padding:9px;border-bottom:1px solid #333;cursor:pointer}"
    "ul{padding:0;margin:8px 0}small{color:#999}</style>"
    "<h1>discrete6502 &mdash; WiFi setup</h1>"
    "<p><small>Pick a network, or type its name.</small></p>"
    "<ul id=l><li>scanning&hellip;</li></ul>"
    "<input id=s placeholder='network name'>"
    "<input id=p type=password placeholder='password (blank if open)'>"
    "<button onclick=save()>Save and reboot</button>"
    "<p id=m><small></small></p>"
    "<script>"
    "function go(){fetch('/wifi/scan').then(r=>r.json()).then(j=>{"
    "if(j.busy){setTimeout(go,900);return}"
    "document.getElementById('l').innerHTML=j.nets.map(n=>"
    "'<li onclick=\"pick(this)\" data-s=\"'+n.ssid+'\">'+n.ssid+' <small>'+n.rssi+' dBm'"
    "+(n.open?' &middot; open':'')+'</small></li>').join('')||'<li>none found</li>'})}"
    "function pick(e){document.getElementById('s').value=e.dataset.s}"
    "function save(){var s=document.getElementById('s').value,p=document.getElementById('p').value;"
    "if(!s){alert('pick a network');return}"
    "fetch('/wifi/save?ssid='+encodeURIComponent(s)+'&pass='+encodeURIComponent(p))"
    ".then(r=>r.text()).then(t=>{document.getElementById('m').innerHTML='<small>'+t+'</small>'})}"
    "go();</script>";

static void wifi_scan_json(char *b, size_t n) {
    size_t k = (size_t)snprintf(b, n, "{\"busy\":%s,\"nets\":[", scan_busy ? "true" : "false");
    for (uint8_t i = 0; i < scan_n && k < n - 90; i++)
        k += (size_t)snprintf(b + k, n - k, "%s{\"ssid\":\"%s\",\"rssi\":%d,\"open\":%s}",
                              i ? "," : "", scan_res[i].ssid, scan_res[i].rssi,
                              scan_res[i].auth == 0 ? "true" : "false");
    snprintf(b + k, n - k, "]}");
}

// ---- core 0: HTTP ---------------------------------------------------------

typedef enum { ST_REQ, ST_HDR, ST_BODY, ST_SEND } hstate_t;

typedef struct {
    bool used;
    hstate_t state;
    char line[300];
    uint16_t line_n;
    char path[120];
    bool is_post;
    uint32_t body_left;
    bool loading;
    ihex_stats_t hx;
    const char *out;  // remaining response
    uint32_t out_len;
    char buf[1400];   // dynamic responses live here for the connection's life
} conn_t;

static conn_t conns[MAX_CONN];
static char scratch[1200];

static conn_t *conn_alloc(void) {
    for (int i = 0; i < MAX_CONN; i++)
        if (!conns[i].used) {
            memset(&conns[i], 0, sizeof conns[i]);
            conns[i].used = true;
            return &conns[i];
        }
    return NULL;
}

static void pump(struct tcp_pcb *pcb, conn_t *c) {
    while (c->out_len) {
        uint16_t room = tcp_sndbuf(pcb);
        if (!room) return;
        uint16_t n = c->out_len < room ? (uint16_t)c->out_len : room;
        // No copy: both sources (flash page, per-connection buf) stay valid
        // until the connection is freed, which happens after everything is
        // acked.
        if (tcp_write(pcb, c->out, n, 0) != ERR_OK) return;
        c->out += n;
        c->out_len -= n;
    }
    tcp_output(pcb);
}

// Send a string that already carries its own HTTP headers, straight from
// flash. No copy, so no size limit: pump() and on_sent() chunk it out.
static void send_static(struct tcp_pcb *pcb, conn_t *c, const char *s, uint32_t len) {
    c->out = s;
    c->out_len = len;
    c->state = ST_SEND;
    pump(pcb, c);
}

static void reply(struct tcp_pcb *pcb, conn_t *c, const char *status, const char *ctype,
                  const char *body) {
    // The response is assembled in c->buf, so a body that does not fit used to
    // be silently truncated WHILE the header still advertised the full length.
    // The browser then waits for bytes that never arrive and renders whatever
    // it got -- which looks like a blank page, not like an error. Anything too
    // big for this path belongs in send_static() instead.
    size_t blen = strlen(body);
    int n = snprintf(c->buf, sizeof c->buf,
                     "HTTP/1.1 %s\r\nContent-Type: %s\r\nContent-Length: %u\r\n"
                     "Connection: close\r\n\r\n%s",
                     status, ctype, (unsigned)blen, body);
    if (n < 0 || (size_t)n >= sizeof c->buf) {
        static const char oops[] =
            "HTTP/1.1 500 Server Error\r\nContent-Type: text/plain\r\n"
            "Content-Length: 46\r\nConnection: close\r\n\r\n"
            "response too large for the connection buffer";
        n = (int)(sizeof oops - 1);
        memcpy(c->buf, oops, (size_t)n);
    }
    c->out = c->buf;
    c->out_len = (uint32_t)n;
    c->state = ST_SEND;
    pump(pcb, c);
}

static const char *qparam(const char *path, const char *key, char *out, size_t cap) {
    const char *q = strchr(path, '?');
    if (!q) return NULL;
    size_t kl = strlen(key);
    for (const char *p = q + 1; p && *p;) {
        if (!strncmp(p, key, kl) && p[kl] == '=') {
            const char *v = p + kl + 1;
            size_t i = 0;
            while (v[i] && v[i] != '&' && i < cap - 1) { out[i] = v[i]; i++; }
            out[i] = 0;
            return out;
        }
        p = strchr(p, '&');
        if (p) p++;
    }
    return NULL;
}

static void status_json(char *b, size_t cap) {
    snprintf(b, cap,
             "{\"run\":%u,\"cyc\":%lu,\"half\":%lu,\"a\":%u,\"d\":%u,\"f\":%u,"
             "\"ft\":%u,\"tc\":%u,\"tr\":%u,\"ta\":%u,"
             "\"rb\":%u,\"rv\":%u,\"rs\":%lu,\"rms\":%lu,\"rok\":%u,"
             "\"rg\":%lu,\"rbad\":%lu,\"img\":%lu,\"secs\":%lu,\"tcyc\":%lu,\"tk\":%u,\"tp\":%u,\"tl\":%u,\"ar\":%u,\"low\":%lu,\"shalf\":%lu,\"slow\":%lu,\"pname\":\"%s\",\"ip\":\"%s\"}",
             s_running ? 1u : 0u, (unsigned long)s_cycle, (unsigned long)s_half, s_addr,
             s_data, s_flags, s_ft_on, s_test_case, s_trapped, s_trap_addr,
             s_ret_busy, s_ret_verdict, (unsigned long)s_ret_seq,
             (unsigned long)s_ret_last_ms, s_ret_last_ok,
             (unsigned long)s_ret_good, (unsigned long)s_ret_bad,
             (unsigned long)settings_program_len(),
             (unsigned long)settings_program_seconds(),
             (unsigned long)settings()->program_cycles,
             s_trap_known, s_trap_pass, s_trap_line, settings()->autorun,
             (unsigned long)s_low,
             (unsigned long)settings()->half_period_us,
             (unsigned long)settings()->low_period_us,
             settings()->program_name,
             ip4addr_ntoa(netif_ip4_addr(netif_default)));
}

static void trace_json(char *b, size_t cap, uint32_t want) {
    if (want > MIRROR_LEN) want = MIRROR_LEN;
    uint32_t total = mirror_count;
    if (want > total) want = total;
    size_t n = (size_t)snprintf(b, cap, "{\"t\":[");
    for (uint32_t i = 0; i < want && n < cap - 40; i++) {
        const bus_trace_t *t = &mirror[(total - want + i) % MIRROR_LEN];
        n += (size_t)snprintf(b + n, cap - n, "%s[%lu,%u,%u,%u]", i ? "," : "",
                              (unsigned long)t->cycle, t->addr, t->data,
                              (unsigned)((t->rw_read ? 1u : 0u) | (t->sync ? 2u : 0u)));
    }
    snprintf(b + n, cap - n, "]}");
}

static void do_cmd(struct tcp_pcb *pcb, conn_t *c) {
    char op[16], v[16];
    if (!qparam(c->path, "op", op, sizeof op)) {
        reply(pcb, c, "400 Bad Request", "application/json", "{\"err\":\"no op\"}");
        return;
    }
    uint32_t val = qparam(c->path, "v", v, sizeof v) ? (uint32_t)strtoul(v, NULL, 0) : 0;

    if (!strcmp(op, "run")) push(CMD_RUN, val);
    else if (!strcmp(op, "resetrun")) push(CMD_RESETRUN, val);
    else if (!strcmp(op, "stop")) push(CMD_STOP, 0);
    else if (!strcmp(op, "reset")) push(CMD_RESET, 0);
    else if (!strcmp(op, "step")) push(CMD_STEP, 0);
    else if (!strcmp(op, "clock")) push(CMD_CLOCK, val ? val : 1);
    else if (!strcmp(op, "clocklow")) push(CMD_CLOCKLOW, val);
    else if (!strcmp(op, "ft")) push(CMD_FT, val);
    else if (!strcmp(op, "ret") || !strcmp(op, "retscan")) {
        if (s_ret_busy) {
            reply(pcb, c, "409 Conflict", "application/json",
                  "{\"err\":\"a retention test is already running\"}");
            return;
        }
        push(op[3] == 's' ? CMD_RETSCAN : CMD_RET, val);
    }
    else if (!strcmp(op, "store") || !strcmp(op, "forget")) {
        // Unlike the clock, the running state changes WHAT gets stored: memory
        // is live while the CPU executes, so a snapshot taken mid-run captures a
        // partially-executed image rather than the one that was loaded. So stop
        // first and wait for core 1 to actually notice, instead of refusing.
        //
        // Core 1 checks the queue between chunks of up to 1000 cycles, which is
        // 100 ms at the default clock. Bounded at 400 ms because this blocks the
        // lwIP poll on core 0 -- long enough for every practical clock, short
        // enough that the HTTP connection survives it.
        bool was_running = s_running;
        if (was_running) {
            push(CMD_STOP, 0);
            absolute_time_t until = make_timeout_time_ms(400);
            while (s_running && absolute_time_diff_us(get_absolute_time(), until) > 0)
                sleep_ms(2);
        }
        const functest_image_t *im = functest_get_image();
        bool ok = (op[0] == 's')
                      ? settings_program_save(bus_mem(), BUS_MEM_SIZE,
                                              im ? im->name : NULL,
                                              im ? im->cycles : 0)
                      : settings_program_clear();
        if (op[0] == 'f') retention_load_image();
        // The flash write parked core 1 for longer than the dynamic nodes hold
        // charge, so the CPU has to be reset either way. Put it back how it was.
        push(was_running ? CMD_RESETRUN : CMD_RESET, 0);
        if (!ok) {
            reply(pcb, c, "500 Server Error", "application/json",
                  "{\"err\":\"flash write refused\"}");
            return;
        }
    }
    else if (!strcmp(op, "clocksave") || !strcmp(op, "autorun")) {
        // Both write flash, which parks core 1 for tens of milliseconds against
        // a ~1.1 ms retention floor -- so the CPU's state cannot survive either
        // way. Rather than refuse, note whether it was running, save, and then
        // reset it back to where it was. Losing state is unavoidable; leaving
        // the CPU in an undefined one afterwards is not.
        bool was_running = s_running;
        if (op[0] == 'c') {
            settings()->half_period_us = s_half;
            settings()->low_period_us = s_low;
        }
        else settings()->autorun = val ? 1u : 0u;
        bool ok = settings_save();
        push(was_running ? CMD_RESETRUN : CMD_RESET, 0);
        if (!ok) {
            reply(pcb, c, "500 Server Error", "application/json",
                  "{\"err\":\"flash write refused\"}");
            return;
        }
    }
    else if (!strcmp(op, "wifireset")) {
        // Forget the network and come back up in setup mode. Deliberately a
        // reboot rather than tearing the station down in place: the reply still
        // has to reach the browser that asked for it, and that browser is on
        // the very link being dropped. So save, answer, and reboot 1.2 s later
        // -- the same ceremony /wifi/save uses, for the same reason.
        settings()->wifi_ssid[0] = 0;
        settings()->wifi_pass[0] = 0;
        if (!settings_save()) {
            reply(pcb, c, "500 Server Error", "application/json",
                  "{\"err\":\"flash write refused; the network is unchanged\"}");
            return;
        }
        s_reboot_at = make_timeout_time_ms(1200);
        reply(pcb, c, "200 OK", "application/json",
              "{\"ok\":1,\"warn\":\"network forgotten -- rebooting into setup mode. "
              "Join \\\"" AP_SSID "\\\" and open http://192.168.4.1/\"}");
        return;
    }
    else if (!strcmp(op, "con")) {
        // Touches neither memory nor flash, so it needs no stop.
        console_enable(val != 0);
        if (val && functest_get_image()) {
            reply(pcb, c, "200 OK", "application/json",
                  "{\"ok\":1,\"warn\":\"a functional-test image is loaded; the suite "
                  "checksums RAM up to $3FFF and the console intercepts three addresses "
                  "inside it, so it will fail a RAM check unrelated to the CPU\"}");
            return;
        }
    }
    else if (!strcmp(op, "img")) {
        // Rewrites all of memory, which is shared with core 1, so the CPU has to
        // be stopped first -- then reset onto the new image.
        bool was_running = s_running;
        if (was_running) {
            push(CMD_STOP, 0);
            absolute_time_t until = make_timeout_time_ms(400);
            while (s_running && absolute_time_diff_us(get_absolute_time(), until) > 0)
                sleep_ms(2);
        }
        char k[4];
        if (!qparam(c->path, "k", k, sizeof k)) {
            reply(pcb, c, "400 Bad Request", "application/json", "{\"err\":\"no image\"}");
            return;
        }
        if (k[0] == 'c') {                 // the counter loop is always available
            retention_load_image();
            functest_set_image(NULL);
            functest_disable();
        } else {
            const functest_image_t *im = functest_image(k[0]);
            if (!im) {
                reply(pcb, c, "404 Not Found", "application/json",
                      "{\"err\":\"no such image; build with -DEMBED_FUNCTEST=ON\"}");
                return;
            }
            memcpy(bus_mem(), im->image, im->image_len);
            functest_set_image(im);
            functest_enable(im->case_addr);
            console_enable(false);         // it would fail the suite's RAM check
        }
        push(was_running ? CMD_RESETRUN : CMD_RESET, 0);
    }
    else if (!strcmp(op, "vector")) {
        // Patching $3FFC only matters at the next reset, so stopping and
        // resetting is not a cost here -- it is the whole point.
        bool was_running = s_running;
        if (was_running) {
            push(CMD_STOP, 0);
            absolute_time_t until = make_timeout_time_ms(400);
            while (s_running && absolute_time_diff_us(get_absolute_time(), until) > 0)
                sleep_ms(2);
        }
        bus_mem()[0x3FFC] = 0x00;
        bus_mem()[0x3FFD] = 0x04;
        push(was_running ? CMD_RESETRUN : CMD_RESET, 0);
    } else {
        reply(pcb, c, "400 Bad Request", "application/json", "{\"err\":\"bad op\"}");
        return;
    }
    reply(pcb, c, "200 OK", "application/json", "{\"ok\":1}");
}

static void dispatch(struct tcp_pcb *pcb, conn_t *c) {
    if (!strncmp(c->path, "/status", 7)) {
        status_json(scratch, sizeof scratch);
        reply(pcb, c, "200 OK", "application/json", scratch);
    } else if (!strncmp(c->path, "/trace", 6)) {
        char v[8];
        uint32_t n = qparam(c->path, "n", v, sizeof v) ? (uint32_t)strtoul(v, NULL, 10) : 16;
        trace_json(scratch, sizeof scratch, n);
        reply(pcb, c, "200 OK", "application/json", scratch);
    } else if (!strncmp(c->path, "/cmd", 4)) {
        do_cmd(pcb, c);
    } else if (!strncmp(c->path, "/images", 7)) {
        size_t n = (size_t)snprintf(scratch, sizeof scratch,
                                    "{\"have\":%u,\"l\":[{\"k\":\"c\",\"n\":\"counter loop\","
                                    "\"w\":0,\"s\":0}",
                                    functest_images_available() ? 1u : 0u);
        for (uint8_t i = 0; i < functest_image_count() && n < sizeof scratch - 140; i++) {
            const functest_image_t *e = functest_image_at(i);
            // w: the vector target is live code rather than a self-loop, so a
            // spurious interrupt is absorbed and resurfaces as a bogus failure
            // somewhere unrelated. Worth saying before an hours-long run.
            n += (size_t)snprintf(scratch + n, sizeof scratch - n,
                                  ",{\"k\":\"%c\",\"n\":\"%s\",\"w\":%u,\"s\":%lu}",
                                  e->key, e->name,
                                  (!e->nmi_is_trap || !e->irq_is_trap) ? 1u : 0u,
                                  (unsigned long)(e->cycles ?
                                      (uint32_t)((uint64_t)e->cycles * 2u * s_half / 1000000u) : 0u));
        }
        snprintf(scratch + n, sizeof scratch - n, "]}");
        reply(pcb, c, "200 OK", "application/json", scratch);
    } else if (!strncmp(c->path, "/con", 4)) {
        char text[192];
        if (qparam(c->path, "send", text, sizeof text)) {
            url_decode(text);
            uint32_t k = console_push_input(text);
            snprintf(scratch, sizeof scratch, "{\"queued\":%lu,\"pending\":%lu}",
                     (unsigned long)k, (unsigned long)console_input_pending());
            reply(pcb, c, "200 OK", "application/json", scratch);
        } else {
            // Drain what the CPU has printed since the last poll. JSON-escaped,
            // because a 6502 program prints whatever it likes.
            char out[512];
            console_take_output(out, sizeof out);
            size_t n = (size_t)snprintf(scratch, sizeof scratch,
                                        "{\"on\":%u,\"pending\":%lu,\"total\":%lu,\"s\":\"",
                                        console_enabled() ? 1u : 0u,
                                        (unsigned long)console_input_pending(),
                                        (unsigned long)console_output_total());
            for (const char *q = out; *q && n < sizeof scratch - 8; q++) {
                unsigned char ch = (unsigned char)*q;
                if (ch == '"' || ch == '\\') { scratch[n++] = '\\'; scratch[n++] = (char)ch; }
                else if (ch == '\n') { scratch[n++] = '\\'; scratch[n++] = 'n'; }
                else if (ch < 0x20 || ch > 0x7E) n += (size_t)snprintf(scratch + n,
                        sizeof scratch - n, "\\u%04X", ch);
                else scratch[n++] = (char)ch;
            }
            snprintf(scratch + n, sizeof scratch - n, "\"}");
            reply(pcb, c, "200 OK", "application/json", scratch);
        }
    } else if (!strncmp(c->path, "/wifi/scan", 10)) {
        scan_poll();
        if (!scan_busy && scan_n == 0) scan_start();
        wifi_scan_json(scratch, sizeof scratch);
        reply(pcb, c, "200 OK", "application/json", scratch);
    } else if (!strncmp(c->path, "/wifi/save", 10)) {
        char ss[SETTINGS_SSID_MAX], pw[SETTINGS_PASS_MAX];
        if (!qparam(c->path, "ssid", ss, sizeof ss) || !ss[0]) {
            reply(pcb, c, "400 Bad Request", "text/plain", "need ssid");
        } else {
            if (!qparam(c->path, "pass", pw, sizeof pw)) pw[0] = 0;
            url_decode(ss);
            url_decode(pw);
            // Stop the CPU first. A flash erase parks core 1 for tens of
            // milliseconds and the worst dynamic node holds charge for about
            // 1.1 ms, so the 6502's state does not survive this either way --
            // but a program left mid-run would look like it crashed.
            push(CMD_STOP, 0);
            sleep_ms(20);
            strncpy(settings()->wifi_ssid, ss, SETTINGS_SSID_MAX - 1);
            strncpy(settings()->wifi_pass, pw, SETTINGS_PASS_MAX - 1);
            if (settings_save()) {
                reply(pcb, c, "200 OK", "text/plain",
                      "saved. rebooting -- rejoin your own network and find the board there.");
                s_reboot_at = make_timeout_time_ms(1200);   // let the reply flush
            } else {
                reply(pcb, c, "500 Server Error", "text/plain", "flash write refused");
            }
        }
    } else if (!strcmp(c->path, "/") || !strncmp(c->path, "/index", 6)) {
        if (ap_mode) {
            send_static(pcb, c, PORTAL_HTML, (uint32_t)(sizeof PORTAL_HTML - 1));
            return;
        }
        c->out = PAGE_HTML;                       // already includes its headers
        c->out_len = (uint32_t)(sizeof PAGE_HTML - 1);
        c->state = ST_SEND;
        pump(pcb, c);
    } else if (ap_mode) {
        // Captive-portal catch-all: every unknown path is the portal, which is
        // what makes the phone's connectivity probe fail and raise "Sign in".
        send_static(pcb, c, PORTAL_HTML, (uint32_t)(sizeof PORTAL_HTML - 1));
    } else {
        reply(pcb, c, "404 Not Found", "text/plain", "no");
    }
}

static void finish_load(struct tcp_pcb *pcb, conn_t *c) {
    uint16_t vec = (uint16_t)(bus_mem()[0x3FFC] | (bus_mem()[0x3FFD] << 8));
    snprintf(scratch, sizeof scratch,
             "{\"ok\":1,\"bytes\":%lu,\"rec\":%lu,\"bad\":%lu,\"vec\":%u}",
             (unsigned long)c->hx.bytes, (unsigned long)c->hx.records,
             (unsigned long)c->hx.bad, vec);
    printf("[wifi] loaded %lu bytes, %lu bad records, vector $%04X\n",
           (unsigned long)c->hx.bytes, (unsigned long)c->hx.bad, vec);
    reply(pcb, c, "200 OK", "application/json", scratch);
}

// Feed one received byte through the request state machine.
static void feed(struct tcp_pcb *pcb, conn_t *c, char ch) {
    if (c->state == ST_SEND) return;

    if (c->state == ST_BODY) {
        if (c->body_left) c->body_left--;
        if (ch == '\n' || ch == '\r') {
            if (c->line_n) {
                c->line[c->line_n] = 0;
                ihex_line(&c->hx, c->line, bus_mem(), BUS_MEM_SIZE - 1);
                c->line_n = 0;
            }
        } else if (c->line_n < sizeof c->line - 1) {
            c->line[c->line_n++] = ch;
        }
        if (!c->body_left) finish_load(pcb, c);
        return;
    }

    if (ch == '\r') return;
    if (ch != '\n') {
        if (c->line_n < sizeof c->line - 1) c->line[c->line_n++] = ch;
        return;
    }
    c->line[c->line_n] = 0;

    if (c->state == ST_REQ) {
        c->is_post = !strncmp(c->line, "POST ", 5);
        const char *sp = strchr(c->line, ' ');
        if (sp) {
            const char *e = strchr(sp + 1, ' ');
            size_t n = e ? (size_t)(e - sp - 1) : strlen(sp + 1);
            if (n >= sizeof c->path) n = sizeof c->path - 1;
            memcpy(c->path, sp + 1, n);
            c->path[n] = 0;
        }
        c->state = ST_HDR;
    } else if (c->line_n == 0) {
        // end of headers
        if (c->is_post && !strncmp(c->path, "/load", 5)) {
            if (s_running) {
                reply(pcb, c, "409 Conflict", "application/json",
                      "{\"err\":\"stop the CPU before loading\"}");
                return;
            }
            ihex_begin(&c->hx);
            c->loading = true;
            c->state = ST_BODY;
            c->line_n = 0;
            if (!c->body_left) finish_load(pcb, c);
        } else {
            dispatch(pcb, c);
        }
        return;
    } else if (!strncasecmp(c->line, "Content-Length:", 15)) {
        c->body_left = (uint32_t)strtoul(c->line + 15, NULL, 10);
    }
    c->line_n = 0;
}

static void conn_close(struct tcp_pcb *pcb, conn_t *c) {
    if (c) c->used = false;
    tcp_arg(pcb, NULL);
    tcp_recv(pcb, NULL);
    tcp_sent(pcb, NULL);
    tcp_err(pcb, NULL);
    tcp_close(pcb);
}

static err_t on_sent(void *arg, struct tcp_pcb *pcb, u16_t len) {
    (void)len;
    conn_t *c = arg;
    if (!c) return ERR_OK;
    if (c->out_len) pump(pcb, c);
    else if (c->state == ST_SEND) conn_close(pcb, c);
    return ERR_OK;
}

static err_t on_recv(void *arg, struct tcp_pcb *pcb, struct pbuf *p, err_t err) {
    conn_t *c = arg;
    if (err != ERR_OK || !p) {
        if (c && c->loading && c->state == ST_BODY) finish_load(pcb, c);
        else conn_close(pcb, c);
        if (p) pbuf_free(p);
        return ERR_OK;
    }
    for (struct pbuf *q = p; q; q = q->next) {
        const char *d = q->payload;
        for (uint16_t i = 0; i < q->len; i++) feed(pcb, c, d[i]);
    }
    tcp_recved(pcb, p->tot_len);
    pbuf_free(p);
    return ERR_OK;
}

static void on_err(void *arg, err_t err) {
    (void)err;
    conn_t *c = arg;
    if (c) c->used = false;  // pcb is already gone
}

static err_t on_accept(void *arg, struct tcp_pcb *pcb, err_t err) {
    (void)arg;
    if (err != ERR_OK || !pcb) return ERR_VAL;
    conn_t *c = conn_alloc();
    if (!c) { tcp_abort(pcb); return ERR_ABRT; }
    tcp_arg(pcb, c);
    tcp_recv(pcb, on_recv);
    tcp_sent(pcb, on_sent);
    tcp_err(pcb, on_err);
    return ERR_OK;
}

// Everything worth knowing, printed whenever a terminal turns up.
//
// This firmware must run headless, so it cannot block on stdio_usb_connected()
// the way the tester does -- but printing the banner once at boot means nobody
// ever sees it, because you cannot be attached before the board boots. Reprint
// on the rising edge instead.
static void banner(void) {
    char d[24];
    settings_fmt_duration(d, sizeof d, settings_program_seconds());
    printf("\n=== discrete6502 ===\n");
    if (ap_mode)
        printf("setup mode: join \"%s\", then http://192.168.4.1/\n", AP_SSID);
    else
        printf("http://%s/  or  http://" MDNS_NAME ".local/\n",
               ip4addr_ntoa(netif_ip4_addr(netif_default)));
    printf("image   : %s%s\n",
           settings()->program_name[0] ? settings()->program_name
                                       : (settings_program_len() ? "stored" : "built-in counter"),
           settings_program_seconds() ? "" : " (runtime unknown)");
    if (settings_program_seconds()) printf("runtime : about %s at this clock\n", d);
    printf("clock   : %lu us high / %lu us low (%lu Hz, %lu%% duty)%s\n",
           (unsigned long)s_half, (unsigned long)(s_low ? s_low : s_half),
           (unsigned long)(1000000UL / (s_half + (s_low ? s_low : s_half))),
           (unsigned long)(100UL * s_half / (s_half + (s_low ? s_low : s_half))),
           (s_half == settings()->half_period_us &&
            s_low == settings()->low_period_us) ? "" : "  [not saved]");
    printf("tests   : %s\n", functest_images_available()
           ? "compiled in" : "not compiled in (build -DEMBED_FUNCTEST=ON)");
    printf("console : %s\n", console_enabled() ? "on" : "off");
    printf("autorun : %s\n", settings()->autorun ? "on -- clocks itself at power-up" : "off");
    printf("CPU     : %s at cycle %lu\n", s_running ? "running" : "stopped",
           (unsigned long)s_cycle);
    // The verdict, on the channel that cannot drop. A functional-test run is
    // nearly three hours; the panel is how you normally watch it, but wifi is
    // the one part of this firmware that can die mid-run without stopping the
    // CPU. If it does, USB is all that is left -- so the result has to be here
    // and not only in /status, or a completed run is unreadable.
    if (s_trapped) {
        if (s_trap_known)
            printf("VERDICT : %s -- self-loop at $%04X, listing line %u\n",
                   s_trap_pass ? "PASSED" : "FAILED", s_trap_addr,
                   (unsigned)s_trap_line);
        else
            printf("VERDICT : halted at $%04X -- address not in the trap table%s\n",
                   s_trap_addr,
                   functest_images_available() ? " for the loaded image"
                                               : " (build -DEMBED_FUNCTEST=ON to name it)");
    } else if (s_ft_on) {
        printf("progress: checkpoint $%02X, no trap yet\n", s_test_case);
    }
    printf("====================\n");
}

// ---- keeping the link ------------------------------------------------------
//
// Nothing in the SDK reconnects a dropped station link, so without this the
// board joins once at boot and then keeps a dead socket forever: an AP reboot,
// a lease expiry or a walk out of range costs you the panel until someone
// power-cycles it. That matters here because a functional-test run is nearly
// three hours long and core 1 keeps clocking right through a network outage --
// the run survives, so the observability has to as well.
//
// Both directions are handled. Station down -> retry, then fall back to the
// setup AP. And AP mode is not terminal either: a board whose network was
// merely DOWN at boot would otherwise sit in setup mode after the network comes
// back, which is the same trap in the other direction.

static bool any_conn_open(void) {
    for (int i = 0; i < MAX_CONN; i++)
        if (conns[i].used) return true;
    return false;
}

static void link_watch(void) {
    static absolute_time_t next_poll, down_since;
    if (absolute_time_diff_us(get_absolute_time(), next_poll) > 0) return;
    next_poll = make_timeout_time_ms(LINK_POLL_MS);

    if (ap_mode) {
        // Only worth retrying if there is something to retry, and only when
        // nobody is mid-way through the setup page -- tearing the AP down under
        // a phone that is typing a password is worse than waiting.
        if (!settings()->wifi_ssid[0] || any_conn_open()) {
            next_ap_retry = make_timeout_time_ms(AP_RETRY_MS);
            return;
        }
        if (absolute_time_diff_us(get_absolute_time(), next_ap_retry) > 0) return;
        next_ap_retry = make_timeout_time_ms(AP_RETRY_MS);
        printf("[wifi] setup mode: retrying %s\n", settings()->wifi_ssid);
        dhcpsrv_stop();   // both bind sockets; start_ap() rebinds them if we fail
        dnssrv_stop();
        cyw43_arch_disable_ap_mode();
        ap_mode = false;
        if (try_sta()) {
            cyw43_arch_gpio_put(CYW43_WL_GPIO_LED_PIN, 1);
            start_mdns();
            printf("[wifi] rejoined: http://%s/  or  http://" MDNS_NAME ".local/\n",
                   ip4addr_ntoa(netif_ip4_addr(netif_default)));
            down_since = nil_time;
        } else {
            start_ap();   // back to setup, unchanged from the caller's view
        }
        return;
    }

    // cyw43_tcpip_link_status(), not cyw43_wifi_link_status(): associated but
    // with no address is still unreachable, and a lapsed DHCP lease is one of
    // the ways this fails.
    if (cyw43_tcpip_link_status(&cyw43_state, CYW43_ITF_STA) == CYW43_LINK_UP) {
        if (!is_nil_time(down_since)) {
            printf("[wifi] link recovered on its own\n");
            down_since = nil_time;
        }
        return;
    }

    // Down. Give it a grace period first -- roaming and rekeying both show as a
    // brief outage, and tearing down a working setup for those would be worse
    // than the problem.
    if (is_nil_time(down_since)) {
        down_since = get_absolute_time();
        cyw43_arch_gpio_put(CYW43_WL_GPIO_LED_PIN, 0);
        printf("[wifi] link down\n");
        return;
    }
    if (absolute_time_diff_us(down_since, get_absolute_time()) < LINK_GRACE_MS * 1000)
        return;

    printf("[wifi] link down for %d s -- reconnecting\n", LINK_GRACE_MS / 1000);
    down_since = nil_time;
    if (try_sta()) {
        cyw43_arch_gpio_put(CYW43_WL_GPIO_LED_PIN, 1);
        start_mdns();
        printf("[wifi] rejoined: http://%s/  or  http://" MDNS_NAME ".local/\n",
               ip4addr_ntoa(netif_ip4_addr(netif_default)));
    } else {
        printf("[wifi] could not rejoin; raising the setup AP\n");
        start_ap();
    }
}

// ---- boot -----------------------------------------------------------------

// Boot tracing. Off by default because it BLOCKS until a terminal attaches,
// which a headless board must never do -- but when the board comes up silent,
// printing after the fact is useless: you cannot attach before it boots. Build
// with -DBOOT_TRACE=ON to have it wait for you and then narrate every stage.
#if BOOT_TRACE
#define TRACE(...)                     \
    do {                               \
        printf("[boot] " __VA_ARGS__); \
        printf("\n");                  \
    } while (0)
#else
#define TRACE(...) ((void)0)
#endif

int main(void) {
    // FIRST, before anything else can go wrong. If a previous run left the
    // watchdog armed -- which an aborted reboot does -- every boot gets reset
    // partway through and the board never reaches its main loop, never prints,
    // and cannot be held in BOOTSEL long enough to reflash. Disabling it here is
    // what lets a bad build be replaced by a good one.
    watchdog_disable();
    stdio_init_all();
#if BOOT_TRACE
    while (!stdio_usb_connected()) sleep_ms(100);
    sleep_ms(200);
    TRACE("stdio up, watchdog disarmed");
#endif

    settings_load();
    TRACE("settings loaded: ssid %s, %u chars of password",
          settings()->wifi_ssid[0] ? "set" : "EMPTY",
          (unsigned)strlen(settings()->wifi_pass));
    // Traced one call at a time. On 2026-08-30 the board died somewhere in this
    // block with no serial device ever appearing, and "somewhere in this block"
    // was not narrow enough to act on: bus_init drives exactly ONE pin (clk0,
    // LOW -- everything else becomes an input), so the obvious suspect is nearly
    // inert and the answer had to be measured rather than reasoned.
    TRACE("bus_init: driving clk0 low, all other pins to inputs");
    bus_init(settings()->clk_open_drain);  // push-pull: no board pull-up on clk0
    TRACE("bus_init returned");
    s_half = settings()->half_period_us;
    s_low = settings()->low_period_us;
    bus_set_phase_us(s_half, s_low ? s_low : s_half);
    bus_set_watch(publish);
    bus_set_io(console_io);   // dormant until the panel turns it on
    functest_set_quiet(true);  // core 1 must never block on stdio
    TRACE("clock %lu/%lu us; loading the boot image", (unsigned long)s_half,
          (unsigned long)(s_low ? s_low : s_half));
    // Prefer a stored boot image; fall back to the counter so there is always
    // something visible before any upload.
    if (!settings_program_load_into_ram()) retention_load_image();
    TRACE("boot image in RAM");
    queue_init(&cmd_q, sizeof(cmd_t), 16);
    TRACE("command queue ready");
    TRACE("launching core 1");
    multicore_launch_core1(core1_main);
    TRACE("core 1 up");

    // Start clocking BEFORE the network, not after. Associating can take up to
    // 40 s, and a board on a shelf with no network in reach should still be
    // running -- which is the case autorun exists for.
    //
    // NOTE, corrected 2026-08-26: this used to say an unclocked board sits at
    // its PEAK draw (1.4 A against 0.87 A clocked) and that clocking early saved
    // current. That is backwards on a populated board. The 1.4 A was measured
    // with NO Pico fitted, so clk0 (no pull-up on this board), the data bus and
    // reset were all floating and the dynamic nodes drifted. With the Pico on
    // and the clock parked, board #1 draws 0.30 A; executing, 1.70 A. Clocking
    // costs about 1.4 A. Autorun is still right, for the ordinary reason.
    // AUTORUN, BUT NOT ON A BOARD THAT HAS JUST BEEN ERASED.
    //
    // Clocking starts here, before cyw43_arch_init(), so a rail that cannot
    // carry the clocked current takes the Pico down before the radio is up:
    // no AP, no station, no USB, and nothing to tell you why. Measured
    // 2026-08-30 -- picotool erase -a, reflash, and the board boot-looped with
    // no serial device and no AP ever appearing.
    //
    // settings_were_stored() distinguishes "the user chose autorun" from "flash
    // is blank and these are just defaults". A blank board therefore comes up
    // QUIET: it reaches the network, serves the panel, and waits to be told to
    // clock. Save any setting from the panel and autorun behaves as it always
    // has. This costs nothing on a provisioned board and is the difference
    // between a diagnosable board and a dark one.
    if (settings()->autorun && settings_were_stored()) {
        push(CMD_RESETRUN, 0);
        TRACE("autorun: reset and run");
    } else if (settings()->autorun) {
        printf("[boot] flash is blank -- NOT autorunning. The clock is parked "
               "(the low-current state); start it from the panel.\n");
    }

    TRACE("cyw43_arch_init...");
    if (cyw43_arch_init()) {
        printf("[wifi] cyw43 init failed\n");
        return 1;
    }
    // Seed flash from the build-time credentials once, if any were given and
    // nothing is stored. That is the only thing -DWIFI_SSID still does.
    if (!settings()->wifi_ssid[0] && WIFI_SSID[0]) {
        strncpy(settings()->wifi_ssid, WIFI_SSID, SETTINGS_SSID_MAX - 1);
        strncpy(settings()->wifi_pass, WIFI_PASSWORD, SETTINGS_PASS_MAX - 1);
        settings_save();
        // That erase parked core 1 for tens of milliseconds against a ~1.1 ms
        // retention floor, so the CPU autorun just started is now executing
        // decayed state. Nothing else would ever reset it, so it would free-run
        // garbage until someone noticed. Put it back where it was.
        if (settings()->autorun) push(CMD_RESETRUN, 0);
    }

    TRACE("cyw43 ready; trying station mode");
    if (try_sta()) {
        cyw43_arch_gpio_put(CYW43_WL_GPIO_LED_PIN, 1);
        start_mdns();
        printf("[wifi] http://%s/  or  http://" MDNS_NAME ".local/\n",
               ip4addr_ntoa(netif_ip4_addr(netif_default)));
    } else {
        // No credentials, or they did not work. Raise the setup portal rather
        // than retrying forever with nobody able to tell it what to try.
        TRACE("station failed; starting the setup AP");
        start_ap();
    }
    TRACE("network stage done, opening the listen socket");

    struct tcp_pcb *pcb = tcp_new_ip_type(IPADDR_TYPE_ANY);
    if (!pcb || tcp_bind(pcb, NULL, HTTP_PORT) != ERR_OK) {
        printf("[wifi] bind failed\n");
        return 1;
    }
    pcb = tcp_listen_with_backlog(pcb, MAX_CONN);
    tcp_accept(pcb, on_accept);

    TRACE("entering the main loop");
    bool was_connected = false;
    for (;;) {
        cyw43_arch_poll();
        cyw43_arch_wait_for_work_until(make_timeout_time_ms(10));
        if (ap_mode) scan_poll();
        link_watch();   // rate-limits itself; see LINK_POLL_MS

        // A terminal just appeared: say who we are, where to reach us, and what
        // is loaded. Costs nothing when nobody is watching.
        bool now = stdio_usb_connected();
        if (now && !was_connected) banner();
        was_connected = now;
        if (!is_nil_time(s_reboot_at) && absolute_time_diff_us(get_absolute_time(),
                                                               s_reboot_at) < 0) {
            printf("[wifi] rebooting to apply new credentials\n");
            sleep_ms(60);                 // let that reach the terminal
            watchdog_reboot(0, 0, 10);
            // watchdog_reboot() arms a reset; it does not stop the caller. Without
            // this spin the loop comes round and arms it again, and an armed
            // watchdog with nothing feeding it resets the chip forever -- including
            // straight back out of BOOTSEL, which makes the board unflashable by
            // software. Never return from here.
            while (true) tight_loop_contents();
        }
    }
}
