epatel/discrete6502/(commit log)

2026-07-25 discrete6502: complete verified 6-layer board (M1-M5)
    A working discrete-transistor MOS 6502 (4,051 SOT-323 FETs, 55 register
    LEDs) as a 291x322mm 6-layer PCB that visually reproduces the original
    die: die-true FET placement from the visual6502 polygon capture,
    bond-pad ring with croc-clip holes, functional-region silk, and an
    unpopulated Raspberry Pi Pico 2 W site wired as clock master + memory
    emulator for bring-up.
    Verified end to end: netlist regeneration reproducible; switch-level
    equivalence vs the original visual6502 netlist (identical traces, real
    6502 program runs); pass-pair analog behavior on the vendor 2N7002
    model; board-vs-netlist parity; independent copper connectivity; KiCad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
    [monster6502v2.dsn]
2026-07-25 Add JLCPCB fab package; finalize silk and part numbers
    - gen/fab/: gerbers (6 copper layers + silk/mask/paste/drill), BOM
    (9 line items, 5,328 SMD placements), CPL, order README with
    settings and order-time checklist
    - FET part resolved: 2N7002W-7-F LCSC C139444 (was a verify
    placeholder); stock must be sourced at order time (~20k pcs for 5
    boards), budget alternative C5334591 noted
    - Fixed pico series resistors missing from position export: their
    DNP-era exclude-from-pos/BOM attributes were still set
    - Silkscreen finalized: labels beside (never on) the bond pads from
    per-pad geometry, library pad frames stripped, clearer Pico install
    wording; DRC now 2 benign library-internal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
    [discrete6502-B_Cu.gbl, discrete6502-B_Mask.gbs, discrete6502-B_Paste.gbp, discrete6502-B_Silkscreen.gbo, discrete6502-Edge_Cuts.gm1, discrete6502-F_Cu.gtl, discrete6502-F_Mask.gts, discrete6502-F_Paste.gtp]
2026-07-25 Add project README; refresh CLAUDE.md; add ordering checklist
    - README.md: public project overview — renders, milestone status,
    technical highlights, repo layout, regeneration pipeline, license/
    attribution (visual6502 CC BY-NC-SA, MOnSter 6502 as inspiration)
    - CLAUDE.md: reassessed for current state — accurate framing (6-layer,
    M5 done, ordering phase), naming directive codified, new Invariants
    section (equivalence gate, board checks + DRC baseline, KiCad SWIG
    rules, pipeline ordering), card triggers refreshed
    - gen/fab/ordering.html: interactive JLCPCB ordering checklist with
    persistent checkboxes and all order-time values inline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
2026-07-25 Pico firmware scaffold; FET switched to BSS138K; BOM upload fixes
    - pico-controller/: M6 bring-up firmware — common/ shared bus engine
    (clock master, 16KB mirrored memory serving, trace ring, reset
    ceremony, IO hook), tester/ interactive CLI harness (reset, run/
    trace, step-by-SYNC, peek/poke, clock control), general/ free-runner
    with $3F00 char-out port printing HELLO 6502. pico-sdk 2.x, pico2_w.
    - Logic-levels finding: board has NO pull-up on clk0 -> firmware
    defaults to push-pull 3.3V clock; full-swing 5V = external 10k from
    the PHI0 bond pad to VCC + open-drain mode. Recommended first
    bring-up at VCC=3.3V documented; SPICE-at-3.3V noted as open item.
    - Core FET: 2N7002W (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
    [discrete6502_bom.csv]
2026-07-25 Document power budget and powering arrangements
    - README.md: power budget section — pull-up static current dominates
    (~1.3W of ~1.5W total @ 5V/0.3A); 3.3V bring-up ~0.6W; clock-edge
    ~50mA peaks absorbed by the distributed decouplers. Also fix stale
    2N7002W mention (now BSS138K).
    - pico-controller/README.md: powering section — VCC/VSS bond pads are
    the power inlet (bench via croc clips powers board + Pico through
    VSYS); USB-only demo mode possible with pin 39 soldered; leave the
    pin-39 castellation UNSOLDERED during the 3.3V bring-up (USB would
    drag VSYS/VCC to ~4.8V otherwise).
2026-07-25 Audit and refresh agent files; correct stale FET value in board files
    - CLAUDE.md: standing rule to keep agent files current with the change
    that makes them stale; add pico-controller/README.md trigger
    - cards: correct board outline (290.7x322), core FET (BSS138K/C504052),
    router config as shipped (G=0.13, 4 routing layers, warm-start), full
    as-ordered BOM table, silk + fab documentation, M5 results; mark the
    M2-era part/board-size notes superseded
    - project-plan.md: prune open questions to live items, replace the
    preliminary cost estimate with the real quote, add handoff entry
    - boards: FET Value property said 2N7002W (F.Fab only, not plotted --
    gerbers unaffected); now BSS138K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
    [gen_pcb.py]
2026-07-25 Update ordering checklist and fab README to as-ordered reality
    - FET step now documents BSS138K/C504052 and why it replaced C139444,
    with the substitution criteria (SOT-323, Vgs(th)<=2.5V, Ciss<=60pF)
    - BOM step explains the 22 rows / 9 parts chunking (JLC 2048-char limit)
    - quote step replaced with the real cart figures and the "two linked
    line items, not duplicates" warning that cost a cart last time
    - waiting step points at the scaffolded firmware and the bring-up
    gotchas (3.3V first, pin-39 unsoldered, no clk0 pull-up)
    - exact board size 290.7 x 322 mm (~9.4 dm2) in both files
2026-07-25 Validate the pass-pair latch at 3.3 V (sim/passpair_33v.sp)
    Clears the last open item before bring-up. Sweeps 5.0/3.3/3.0 V across
    three FET models (onsemi vendor 2N7002 as the pessimistic case, BSS138
    typical, BSS138K worst-case Vto=1.5) on the M4 worst-path topology, with
    four explicit pass/fail gates in the deck.
    All gates pass at every rail: the clock-edge bootstrap still lifts the
    stored '1' to slightly above VCC at 3.3 V (3.39 V) and 3.0 V (3.08 V),
    the next stage is driven to ~1 mV, a source-driven '0' through a pass
    pair reaches -1.09 V, and 10k pull-up recovery slows only 19% to 1.31 us
    (7x margin in a 50 kHz half-cycle).
    The floating-island '0' limitation from M4 is unchanged --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
2026-07-25 Quantify LED tap brightness vs supply rail; fix power budget
    sim/led_tap.sp models the real LED branch (2.2k ballast, red 0603 diode
    fitted to Vf 1.90V at 2mA, tap FET) and sweeps 5.0/3.3/3.0 V. The tap
    FET saturates at 2-4 mV, so brightness is set purely by the ballast:
    1.42 mA at 5 V, 0.67 mA at 3.3 V, 0.54 mA at 3.0 V -- 47% of the current
    at 3.3 V but only ~20% less perceived brightness.
    This also corrects the README power budget: the LED row read 75 mW,
    but 55 LEDs at 1.42 mA is 78 mA / 0.39 W. Board total at 5 V is
    ~1.6-1.8 W rather than ~1.45 W; the stated current (~0.3 A) was right.
2026-07-25 Re-derive the power budget from the netlist; find the real clock ceiling
    Power budget was partly wrong. Recomputed every row from gen/netlist.json:
    - LED row read 75 mW; 55 LEDs at 1.42 mA is 78 mA / 0.39 W
    - pull-ups are 1,023 (1,018 node + 5 input), not 1,018
    - adds the Pico's ~0.12 W when VSYS is soldered to VCC
    - separates typical from absolute worst case: 0.32 A / 1.6 W typical,
    0.63 A / 3.2 W with every pull-up low and every LED lit (a 5 V / 1 A
    supply still covers it)
    Bigger finding: the >=50 kHz clock target does not hold. The M2 speed
    rule assumed one gate per node, but decode-PLA input lines drive up to
    71 discrete gates (~1.9 nF) behind a single 10k pull-up. New deck
    sim/fano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
    [bus6502.c, main.c]
2026-07-25 Correct the clk0 level claim: a 3.3 V clock into a 5 V core is fine
    The board genuinely has no pull-up on clk0 -- it is a pure input (two FET
    gates, 100R series, clamp diodes), so the clock must be driven push-pull
    and an open-drain driver would leave it floating. That part stands.
    But the stated reason for wanting a full-rail clock was wrong. clk0 does
    not gate the pass transistors: it drives two pull-down gates, and the
    internal phases (cclk 482 gates, cp1 198 gates) are regenerated on-board
    at full VCC swing. Simulated, a 3.3 V clk0 into a 5 V core gives an
    input-inverter low of 1.7 mV and 17 ns delay vs 1.4 mV / 7 ns at 5 V.
    The external 10k croc-clipped from the PHI0 bond pad to VCC i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
2026-07-25 Drop the now-unnecessary open-drain clock step from the bring-up path
    Follow-on to fb45b12: moving to 5 V no longer implies switching to an
    open-drain clock with an external pull-up.
2026-07-25 Audit the docs for wrong claims; fix what the data contradicts
    Checked every quantitative and causal claim in the docs against
    gen/netlist.json, the board file and the fab package.
    Wrong, now fixed:
    - cards/architecture.md described a "standard 6502 bus pinout exposed on a
    header" -- there is no connector at all (36 THT bond pads + the Pico
    site). The card was still M1-era: static-vs-dynamic listed as an open
    decision, "4,000+ placed components", "repo layout not yet established".
    Rewritten as-built.
    - README said 783 pass transistors (that is the pre-dedup source figure;
    the netlist has 778) and 1,018 pull-ups (1,023: 1,018 node + 5 input).
    - cards/layout.md step 3 said the VCC p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
2026-07-25 Record the via-class and edge-rail findings in the order docs
    - min via hole: recommend the 0.2mm/(0.3/0.35mm) class (~+EUR 25). All
    14,454 vias are 0.2 mm holes in 0.45 mm pads; the default 0.3 mm class
    would enlarge them, thinning the annular ring from 0.125 to 0.075 mm.
    Verified this is a ring question only, not a spacing one: the closest
    hole pair on the board is 0.520 mm centre-to-centre, so hole-to-hole
    stays >= 0.22 mm even at 0.3 mm drills (0 violations either way).
    - via covering: keep "Epoxy Filled & Capped" -- 3,817 vias sit on SMD pad
    copper, so this is required, not an upsell.
    - the quote's 300.7 x 322 mm is JLC's two 5 mm assembly edge rails, not an
    error; plane c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
2026-07-25 Map the DNP ballast caps; drop the stale "1k-DNP" value label
    The bare pad pairs visible on the back in JLC's preview are the 56
    intentionally-unpopulated 100pF ballast caps, C101-C156, spread over the
    six main buses (ab x16; db/idb/adl/adh/sb x8 each). They are the M4
    bring-up insurance against clock-edge charge injection. gen/dnp_ballast_map.svg
    plots them bottom-view so the empty sites can be checked against the list.
    Verified nothing else is unpopulated: the back holds 1,279 footprints and
    1,222 appear in the CPL; the 57 absent are those 56 caps plus the Pico site,
    all DNP-flagged and excluded from the position file.
    Also cleared a stale label: the 26 Pico series resistors still carrie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
2026-07-25 Add the rotation/orientation note to the ordering checklist
    Step 6 now carries the ready-to-paste PCBA remark documenting the CPL
    rotation convention (SOT-323 pin1=Gate upper-left; LED and SOD-323 pad
    1 = cathode), our exact pad geometry to compare against JLC's placement
    preview, and the caveat that the 3D viewer is reference-only -- it
    places JLC library models at their own orientation, so a body drawn 180
    degrees out there is not evidence of a wrong build.
    Also records where the real risk is: a flipped SOT-323 cannot physically
    seat on the pads, whereas a flipped LED or clamp diode looks correct and
    is fatal.
2026-07-25 Keep silkscreen off pad copper; regenerate the fab package
    The first gerber review showed the fab subtracting pad openings from
    silk, so region titles printed half-eaten ("CONTROL LOGIC" as "COITROL
    LOGIC", the datapath title badly broken up).
    add_silk.py now builds a 2 mm occupancy grid of front-side footprints and
    places every free-standing text in a pad-free block:
    - the logo picks first, since it is the signature element, and its
    attribution is split over two lines (one long line needs more clear
    width than exists anywhere on the die)
    - band titles then take ONE uniform height that all three bands can
    honour, each using the longest wording that fits at it, so the die
    density dec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
    [discrete6502-B_Cu.gbl, discrete6502-B_Mask.gbs, discrete6502-B_Paste.gbp, discrete6502-B_Silkscreen.gbo, discrete6502-Edge_Cuts.gm1, discrete6502-F_Cu.gtl, discrete6502-F_Mask.gts, discrete6502-F_Paste.gtp]
2026-07-25 Add a register LED map; document why per-LED silk labels are impossible
    Measured what fits: only 3 of 55 LEDs have a pad-free spot for a label
    even at 1.0 mm text, and marking just each column's two end bits manages
    1 of 12. The LEDs sit inside the transistor rows -- the die-true
    placement that makes the board look like the die is exactly what leaves
    no silk room. The remaining free front blocks are 20x6 mm and none are
    near the LED columns.
    Instead: gen/led_map.svg plots all 55 with their bit/flag names, and the
    firmware README gains a "Reading the LEDs" table. The six register
    columns are regular (bit 0 top to bit 7 bottom, y 183-270 mm); the 7 P
    status flags are scattered at die-true pos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
2026-07-26 Re-work vias for JLCPCB's free 0.3mm drill class
    The 0.2mm drill class costs about EUR 25; 0.3mm is free on 6 layers but
    would have thinned our annular ring from 0.125 to 0.075mm. Per the user's
    suggestion -- find what breaks and see whether a nudge is enough -- vias
    now drill 0.30mm with pads grown to keep the ring:
    13,028 vias at 0.55mm pad (ring 0.125mm)
    534 vias at 0.52mm pad (ring 0.110mm)
    892 vias at 0.45mm pad (ring 0.075mm)
    All within JLC capability (they pair a 0.3mm hole with a 0.4mm via, i.e.
    a 0.05mm ring). Only 5 vias actually had to move; 1,421 resolved by
    dropping one size in place, which keeps geometry churn minimal.
    Three defects DRC caught before this shipped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
    [discrete6502-B_Cu.gbl, discrete6502-B_Mask.gbs, discrete6502-B_Paste.gbp, discrete6502-B_Silkscreen.gbo, discrete6502-Edge_Cuts.gm1, discrete6502-F_Cu.gtl, discrete6502-F_Mask.gts, discrete6502-F_Paste.gtp]
2026-07-26 Release fab package rev A
    Pins down what is being ordered: gen/fab/RELEASE.md records sha256
    fingerprints of the three upload files, the board spec, the verification
    results and the order settings that matter.
    The zip was byte-compared against a fresh plot of the golden board --
    15/15 files identical apart from creation timestamps -- so the package on
    disk provably matches the board.
    All four gates re-run against this exact board:
    switchsim PASS (traces identical, program correct)
    check_parity 5,421 components, 0 errors
    check_gaps 0 broken nets
    kicad-cli pcb drc 2 errors (benign Pico-library items), 0 unconnected
    + 199 same-net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
2026-07-26 Re-render board images with the corrected silkscreen
    The README renders predated the silk fix and still showed the clipped
    region titles ("C3ITROL LOGIC", the mangled datapath heading). Re-rendered
    both sides from the current board at the same 2384x2576, quality high,
    transparent background as before.
    Note kicad-cli render must be run in the foreground here -- backgrounding
    it exits 0 without writing the file.
2026-07-26 Record the verified rev A quote and the Standard-PCBA constraint
    Every line item in the JLCPCB quote for the rev A upload
    (discrete6502_gerbers_Y6) has now been checked against the design, so the
    cost figures in project-plan.md and ordering.html are measured rather
    than estimated.
    PCB EUR 131.44
    PCBA, both sides, 5x EUR 715.83
    shipping (5.12 kg) EUR 64.54
    coupon EUR -8.78
    cart subtotal EUR 903.03
    depaneling EUR 2.88 (billed after review)
    Swedish import VAT 25% EUR 226.48
    landed ~ EUR 1132 (~EUR 226 per assembled CPU)
    Two lines confirm the board settings survived the re-upload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
2026-07-26 Order 4 assembled boards, keep the fifth bare
    User decision: the fifth PCB stays unpopulated. The die artwork with no
    parts on it photographs far better than a populated board, and it doubles
    as a free spare.
    Assembly does not scale linearly -- setup 44.90 + stencil 14.42 + feeders
    12.10 are one-time, so dropping the fifth saves EUR 118.39 in absolute
    terms while raising the per-CPU cost EUR 6.19:
    5 assembled EUR 715.83 (EUR 143.17 per board)
    4 assembled EUR 597.44 (EUR 149.36 per board)
    Cart now: PCB 131.44 + PCBA 597.44 + shipping 59.37 (4.84 kg) - coupon
    8.78 = EUR 779.47 subtotal; plus EUR 2.88 depaneling and ~EUR 195.59
    Swedish import VAT gives ~EUR 978 landed, ~EUR 245 p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
2026-07-26 Add a project introduction page
    A single self-contained page in docs/ describing the project for a general
    reader: what a discrete 6502 is, why the board reproduces the die layout,
    how the dynamic NMOS logic was preserved, how the whole thing is generated
    rather than drawn, and what has and has not been proven.
    Every figure is re-derived from gen/netlist.json rather than quoted from
    the docs: 4,051 transistors (2,276 pulldown + 778 pass pairs as 1,556 +
    164 vcc-side + 55 LED drivers), 1,023 pull-ups, 55 LEDs, 5,421 components
    across 2,624 nets.
    The status section says plainly that no physical board exists yet and that
    the bootstrap effect the design depends on has been simulated but never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
2026-07-26 Drop the two artifacts still carrying the old working-title name
    gen/monster6502v2.dsn is the Specctra export from the abandoned
    Freerouting attempt (superseded by tools/route_nc.*), and
    gen/monster6502v2.kicad_prl is KiCad editor-local state. Neither is an
    input to anything, and the project directive is that our artifacts are
    never named "monster6502" -- which would be hard to defend with those two
    filenames sitting in the tree. Ignored so they cannot come back.
    References to the MOnSter 6502 in prose stay: it is acknowledged as
    inspiration, and cards/monster6502-lessons.md is a card about it.
    [monster6502v2.dsn]
2026-07-26 Stop the README claiming the CPU works
    Now that the repo is public the opening line is the landing text, and
    "A working MOS 6502 CPU built from 4,051 discrete transistors" reads as a
    claim that it runs. No board exists; the design is verified in simulation
    and geometry only. Opening line is now "A complete, verified design for a
    ...", followed by an explicit sentence saying nothing has been proven in
    copper, pointing at Status.
    Same fix in the bring-up highlight, which said "solder a Pico on, flash
    firmware, and the CPU runs programs" -- the firmware is written and builds
    but has never met hardware. Reworded as the intended workflow, with the
    untested state stated outright.
    This matches ho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
2026-07-26 Link the repo from the introduction page
    The page described the project in detail and never said where the source
    was: a hero button, an inline link on the pipeline section, and a footer
    line naming what is in the repo.
2026-07-26 Adopt Klaus Dormann's functional test as the bring-up acceptance test
    6502.org's Tools -> Emulators page lists test programs for 6502
    re-implementations. Klaus Dormann's suite fits our hardware: checked
    against its source, the stock config ends the image around $3800, so it
    sits inside the 16 KB mirrored window with the reset vector clear - the
    ab14/ab15 sacrifice does not block it.
    The suite has no I/O, so the Pico now reads its two side channels off the
    bus: writes to test_case as live progress, and a repeated opcode-fetch
    address (branch-to-self) as the verdict.
    - bus6502: optional per-cycle watcher that can stop a long run early
    - common/functest.c/.h: the functional-test watcher
    - tes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
    [bus6502.c, functest.c, functest.h, main.c]
2026-07-26 Record that the Pico firmware is now verified to build
    Both firmwares compiled for the first time against pico-sdk 2.1.1 with
    PICO_BOARD=pico2_w: tester 37K text / 32K bss, general similar, no
    warnings from our sources. The docs previously claimed 'builds' without
    that ever having been checked.
2026-07-26 Add wifi firmware: browser control panel for bring-up
    The functional test is an hours-long run at 10-20 kHz, which is no way to
    work from a tethered terminal. This serves a dependency-free page from
    flash: upload Intel hex, run/stop/step/reset, set the clock, and watch
    the bus and test progress live.
    The core split is load-bearing, not tidiness. The bus engine runs alone
    on core 1; wifi, lwIP and HTTP on core 0. This is dynamic logic, so a
    stretched clock phase is a correctness bug, and association plus DHCP
    block for milliseconds. The same reasoning forced functest quiet mode:
    pico stdio_usb blocks up to 500ms when a terminal is attached but not
    draining, which on core 1 would stretch a 50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
    [functest.c, functest.h, ihex.c, ihex.h, lwipopts.h, main.c, page.h]
2026-07-26 Record the local pico-sdk location in the firmware README
2026-07-26 Add a Makefile for the Pico firmware builds
    Wraps the three cmake invocations: make (tester + general), make wifi,
    all-wifi, size, flash-<name>, clean. Guards on PICO_SDK_PATH and on the
    wifi credentials, which still have no defaults; wifi.local.mk (gitignored)
    keeps them out of shell history.
2026-07-26 Wipe between the board and the real die on the intro page
    Cursor-tracked reveal in the spirit of memention.com/Julkort-08, but
    left/right since both images are taller than wide, and with the split
    following the pointer rather than a handle to drag.
    The two layers are registered, not eyeballed: the die render is placed
    using the board's own die-coordinate transform (CORE rect from
    layout_params.json over the die bbox from netlist.json), with the die
    image's scale derived from its extreme bond-pad centres. Verified by
    blending the two and looking at it - PLA, datapath and die extent
    coincide.
    Touch: pan-y so the page still scrolls vertically off this near-full
    height image, and a bare pointe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
2026-07-26 Put the board on the left and the die on the right
    Swap the clip so the overlay is cut away to the left of the split, and
    move the rest position to 66% so the board still dominates with the die
    teased on the right.
    Also drop loading=lazy from the die layer - it is half of this figure and
    loading it late leaves an empty panel where the die should be (caught in
    a screenshot). Attribution corrected to the actual source: the visual6502
    6502 images page, MOS 6502 revision D photographed in 2009.
2026-07-27 Add reverse validation: rebuild the netlist from the copper
    Every existing gate reads forwards and trusts KiCad's net bookkeeping.
    check_parity compares pad net labels to the netlist; check_gaps groups
    copper BY KiCad's net codes before asking whether each net is connected,
    and never looks at zones at all - so the GND/VCC planes were covered only
    by KiCad's own unconnected count.
    extract_netlist.py discards every net label and unions copper purely
    geometrically (pads, tracks, vias, zone fills, exact SHAPE::Collide),
    reports LVS in both directions, and emits a netlist switchsim simulates
    as a third input.
    Golden board: 2,639 conductors, 0 opens, 0 shorts, 4,051 FETs recovered,
    VCC identifie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
    [extract_netlist.py, switchsim.py]
2026-07-27 Quantify the clock's lower bound, and make the reverse gate's teeth a real test
    Dynamic logic is bounded on both sides. tools/dynamic_nodes.py finds the
    456 dynamic storage nodes and the worst of them: the special-bus bits
    sb1..sb7, one gate driven (32 pF) against twelve FET channels leaking
    them. The big nets are the safe ones - cclk holds 13 nF against 2
    channels for 259 ms.
    The decisive number: at the measured 20 kHz ceiling the worst node must
    leak under 53 nA per FET, or the floor rises above the ceiling and there
    is no working clock at all. Typical parts are ~1 nA (378 Hz floor, ~57 C
    of headroom); at the 500 nA datasheet guardband it would be 187 kHz and
    the design would not run.
    si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
    [dynamic_nodes.py, test_extract.py]
2026-07-27 Add the clock-stop retention test to the tester
    The clock's lower bound is the one number simulation could not supply:
    the worst node's retention spans 2.6 ms to 5.3 us across the plausible
    leakage range, and sim/retention.sp documents why ngspice cannot narrow
    it. So measure it on copper.
    'w MS' freezes the clock for MS milliseconds; 'W [MAXMS]' bisects for the
    boundary. Detection uses the counter image: note one store to $0300,
    freeze, and require the next store to be exactly one greater - a
    forgotten register breaks the sequence, a forgotten PC stops the stores.
    W runs a 0 ms control first. If the CPU cannot survive no stall at all
    the harness is broken and every later number would be m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
    [main.c]
2026-07-27 Share the retention test, and add it to the wifi panel
    The measurement moves to common/retention.c so both firmwares run the
    same code: load the counter image, note a store to $0300, freeze the
    clock, require the next store to be exactly one greater. The bisection
    (with its 0 ms control) is shared too, parameterised by a report callback
    and an abort callback - the tester prints and aborts on a keypress, the
    wifi firmware publishes to the snapshot and aborts on a stop command.
    That also removed the duplicated counter-image loader both mains carried.
    On the wifi side the test runs on core 1 with the bus engine, since it
    drives the clock; core 0 only triggers it and reports. A scan can take
    m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
2026-07-27 Correct the core FET name: BSS138K -> BSS138W
    Verified on LCSC: C504052 is JSCJ BSS138W, SOT-323, 50V, 220mA, Ciss
    27pF, Vgs(th) 1.5V. There is no BSS138K behind that code - the name was
    an error made at order time and it had spread to 17 files.
    No engineering consequence. The LCSC code was always right, and every
    figure the analysis depends on matches the real part: 27 pF is what
    fanout_speed.sp and dynamic_nodes.py assume, and the 3.3V pass-pair and
    LED decks already simulate the Vth=1.5V worst case.
    The BOM is deliberately untouched - its sha256 is pinned in RELEASE.md
    and already uploaded, and JLC matches on the LCSC code, so the Comment
    text is cosmetic. gen_netlist.py keeps emitting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
    [dynamic_nodes.py, gen_netlist.py, gen_pcb.py]
2026-07-27 Refresh the stale generated netlists, correct the FET quantity
    gen/discrete6502.net and gen/netlist.json still carried the pre-order
    part (2N7002W / C82175-verify), never having been regenerated after the
    2026-07-25 switch to C504052. Inert - the board was already built, the
    BOM comes from netlist.json's components and check_parity reads those -
    but a KiCad re-import would have picked up the wrong part.
    Verified the refresh changes nothing else: all 5,421 components and all
    2,624 nets are identical; only meta.fet and the .net component records
    move to BSS138K/C504052. The value string stays BSS138K on purpose so
    the released BOM keeps its hash.
    ordering.html said 20,300 FETs for 5 boards;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
2026-07-27 Make the two board renders the same size in the README
    They already were the same size: both PNGs are exactly 2352x2552. A
    markdown table sizes its columns to their content, and the header
    'Back (passives + Pico site)' is 27 characters against 'Front (the
    die)' at 15 - so that column came out wider and its image, being
    max-width:100% of the cell, rendered ~7% larger.
    Measured in a browser against GitHub-like table CSS: 407x442 vs 434x471
    before, 400x434 for both after, with the table at 854px inside the 896px
    content column so nothing scrolls.
2026-07-27 Point the README board images at the lighter JPEGs
    Same two renders, indistinguishable at the 400px they display at, but
    5.7 MB of PNG becomes 1.4 MB - a 3.9x lighter repo page. The gen/*.png
    originals stay as the full-resolution artifacts.
    Both JPEGs are 1474x1600, so the explicit widths still keep the two
    columns matched.
2026-07-27 Rewrite the pico-controller README in Simplified Technical English
    Applied the ste-writing skill in STE-flavored mode: form only, no facts
    changed. 14 semicolons removed, 29 over-length sentences down to 0, the
    one contraction expanded, passive voice with a known actor made active,
    and nominalizations and phrasal verbs replaced with plain verbs.
    Verified nothing was lost: all 77 inline-code identifiers, every link,
    all 12 section headings and every measured number survive unchanged.
    Code blocks, tables and command syntax were left alone, as the skill
    requires.
2026-07-27 Remove the em dashes from the pico-controller README
    STE bans the semicolon but not the em dash, so the skill left them. Each
    one is replaced by judged punctuation rather than a blind substitution:
    headings that glue a label to a gloss take a colon, the parenthetical in
    the pin-map heading takes a comma, and the dashes inside the example
    transcripts become parentheses or a sentence break.
    No anchor links pointed at the renamed headings, so nothing broke.
    Re-checked: 0 em dashes, 0 semicolons, 0 sentences over 25 words, no
    identifier or number dropped, and the 4 en dashes in numeric ranges are
    left alone.
2026-07-27 Rewrite the intro page in Simplified Technical English
    Applied the ste-writing skill in STE-flavored mode, and removed the em
    dashes as on the firmware README. Prose blocks: 11 over-length sentences
    down to 0, the semicolon and both contractions gone, 23 em dashes gone,
    passive voice with a known actor made active, and British spellings
    (millimetres, modernised, labelled) made American as STE requires.
    Fixed a real inconsistency while rewriting: the 'Prove it' step still
    said four independent checks after the fifth gate was added. It now says
    five, matching the heading above it.
    Verified nothing else moved: all 8 links, 4 images, 9 ids and 26 classes
    are unchanged, no number was dropped, a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
2026-07-27 Add the clock's lower bound to the intro page
    The page gave only the ceiling. The floor is the more interesting half
    and it is a live risk, so it belongs there.
    A note under 'How it works' explains that a dynamic node must be
    refreshed before its charge leaks, which bounds the clock at both ends.
    It gives the typical floor (~380 Hz), the datasheet-worst case where the
    floor would rise to 187 kHz and cross the ceiling, and the fact that the
    firmware measures the real figure at bring-up because simulation cannot
    resolve currents that small.
    The specification table now lists a ceiling and a floor rather than one
    clock figure, and the risk note says that leakage above ~53 nA per
    transistor wou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
2026-07-28 Restructure the bring-up sequence around a 5 V board-alone smoke test
    The 3.3 V-first plan existed to avoid the 5 V core / 3.3 V GPIO question,
    but the Pico site is DNP: the boards arrive with no 3.3 V part on them, so
    the first checks have no level question at any rail. 3.3 V is also the
    tighter operating point (ceiling 20 -> 10 kHz, leakage budget 53 -> 27 nA
    per FET, usable clock window ~50x -> ~13x), which makes a failure there
    ambiguous between an assembly fault and reduced margin.
    Bring-up is now four ordered steps: VCC-VSS resistance, board-alone current
    draw at 5 V against the 0.35 A prediction, mount the Pico, 5 V logic
    bring-up. 3.3 V becomes a documented diagnostic fallback.
    Als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
2026-07-28 Clarify that either end can supply board power
    A soldered pin 39 makes board VCC and Pico VSYS one node, so the bond pads
    are not mandatory once a Pico is fitted: USB into the Pico runs the whole
    CPU from one cable. Only bring-up Step 2 needs the pads, because no Pico is
    fitted at that point.
2026-07-28 Document the wifi firmware's power behaviour
    The firmware does not manage power at all: no cyw43_wifi_pm, no clock
    scaling, no sleep, and a core 1 bus loop that never idles. It only adds
    load. Record why the transmit bursts matter more than the average: a
    200-300 mA step lands on the rail holding 456 dynamic nodes with only
    ~50 uF of bulk behind it, and over a USB cable that dip reads back as a CPU
    logic fault rather than as a power problem. This firmware is for the
    overnight functional-test run, so it is the longest exposure to that.
2026-07-28 Document the optional VBUS-to-VSYS bridge for demo boards
    Pin 40 is nc40, a single-pad net, so bridging 39/40 bypasses the module
    Schottky and touches nothing else. It buys the full 5 V rail and a stiffer
    supply in USB-only mode, but it removes the reverse blocking, so a bridged
    board must never see a bench supply on its bond pads. Documented as a
    per-board modification for a demonstration unit, not a general change.
2026-07-28 Record the expected fab yield before the boards arrive
    Published DPMO ranges applied to this board's real joint count: 5,328
    placements and ~14,700 joints per board, ~95% of them fatal if defective
    because the netlist has no redundancy. Central estimate 0.5-2 defects per
    board, so a perfect first power-up is a coin flip and four boards is what
    makes that acceptable.
    Also records that the systematic risks dominate, since they hit all four
    boards identically: SOT-323 rotation, via-in-pad capping, wrong reel. Names
    bring-up Step 2 (board-alone current draw) as the detector for those, and
    the functional test's per-test_case progress as the localiser for random
    single-joint defects.
    Co-Authored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
2026-07-28 Compare our clock window against the original 6502's
    Verified from the MOS 6500-family datasheet rather than memory: the
    Electrical Characteristics header states "Minimum clock frequency = 50 KHz",
    and the cycle-time row gives only a minimum (1000/500/333/250 ns), with no
    maximum cycle time at all. So the original's window was 50 kHz to 1 MHz, a
    ratio of 20x, and it had a floor for exactly our reason.
    Ours is ~378 Hz to ~20 kHz: the ceiling is 50x lower, but the floor is 130x
    lower, so the window is wider in ratio while sitting two decades further
    down. Large discrete gate capacitance hurts speed and helps retention, and
    here it helps more than it hurts. Also notes that the MOnSter's ~50 kH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
2026-07-28 Record the placed order, keeping the identifiers out of git
    M6 has started: 5 PCBs, 4 assembled, EUR 775.88 paid, ~EUR 973 landed,
    estimated ship 2026-08-06. Adds an as-ordered cost table, resolves the
    order-status open question and records the pre-payment review.
    Two settings were fixed before paying. Depaneling was off, and measured
    against the golden board the nearest SMD joint to a rail break line is
    8.55 mm with 130 pads inside 10 mm, all MLCCs, so EUR 2.60 and one build
    day removes the risk of hand-snapping four populated boards. The PCB Remark
    was empty and now carries the stackup in words, as a third guard on inner
    layer order beside the .g1-.g4 extensions and the .gbrjob.
    The JLCP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
2026-07-28 Pin the exact paid total and payment timestamp
    Order confirmed Paid: merchandise $816.10 (net of the $10 coupon) plus
    $67.59 shipping = $883.69, matching the EUR 775.88 checked in the cart.
2026-07-28 Correct the carrier to UPS and record the invoiced unit prices
    The commercial invoice, not the cart panel, is the authority: Ship Via is
    UPS Worldwide Express Saver and the incoterm is CPT. An earlier note said
    DHL, read off a clipped cart label.
    Also records the invoice's split of the PCB line: 1 bare board at EUR 26.28
    plus 4 that go on to assembly, with the populated boards at EUR 174.76 each.
2026-07-29 Record the depaneling charge as paid
    Priced at EUR 2.60 / USD 2.96 when the advanced-option review finished and
    paid separately on 2026-07-29, bringing the total paid to JLCPCB to
    EUR 778.48 / USD 886.65. The two payments sum exactly to the order total;
    advanced options are excluded from the checkout figure by design.
2026-07-29 Settle the density question by measurement, and state the yield in one line
    The intuition that packing this many parts raises the per-joint defect rate
    does not survive measurement: across 14,912 SMD pads the closest gap between
    different parts on different nets is 0.955 mm, roughly 4x more relaxed than
    routine SMT. Density is a dividend of the die-mimicry directive. Closeness is
    not the risk; count is, and the DPMO model already captures count.
    Records the three risks the model does not capture, all driven by board size
    rather than density: thermal mass, warpage over a 300 mm span, and two reflow
    passes. These make defects more likely to cluster by region, which is useful
    at bring-up. Adds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
2026-07-29 Verify the stackup from JLC's production files by measurement
    File sizes only prove that planes sit at L2/L5; they cannot tell which plane
    is which, and a GND/VCC swap is the catastrophic case. Aligning JLC's CAM
    gerbers to the golden board and counting polygon vertices around the 2,501
    vss and 1,349 vcc via positions identifies each plane with no reference to
    any label: a plane floods over its own net's vias and cuts an antipad around
    foreign ones. l2 voids at VCC vias (GND plane), l5 voids at VSS vias (VCC
    plane), l3 and l4 show no plane behaviour. All four are where they should be.
    Records the trap that one board-wide alignment is required, since a per-layer
    search finds spurious optima,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
2026-07-29 Record that the PCB production file was confirmed and released
    The bare boards are committed; the assembly/DFM confirmation is the remaining
    gate and SOT-323 rotation the last all-four-boards risk.
2026-07-30 Verify the DFM placement and close the SOT-323 rotation risk
    Ground truth first: all 4,051 FETs are at 0 degrees, LEDs at 0 with cathode
    on -x, and the 12 SOD-323 clamps at 180 on the bottom with cathode on +x. The
    DFM's uniform pin-1-upper-left appearance is therefore correct, which closes
    the last all-four-boards failure mode.
    The diodes needed care because the bottom view's mirroring was unknown and
    the verdict flips with it. Resolved three ways: D66/D67 are the rightmost
    pair yet render leftmost, the cursor readout fits Y = 322 - y_board, and our
    own silk asymmetry lands on the same side as JLC's cathode bar.
2026-07-30 Mark the full order released to production
    Both gates passed: PCB stackup verified by measurement, SMT placement
    verified on the DFM image.
2026-07-31 Revise the clock floor's failure mode: shoot-through, not just data loss
    The MOnSter's designer documents its low-clock failure as both pullup and
    pulldown turning on, which he needed protective resistors to survive. This
    plan had assumed the floor was a correctness failure only.
    Re-derived our exposure from the netlist: all 1,018 pull-ups are 10k
    resistors and so are current-limited, but 266 nets have a FET-to-FET path
    with no series resistance, worst being cclk at 33 VCC-side FETs against 31
    pull-downs. The tester's w and W commands deliberately create that condition.
    Adds a safety block to the firmware README (0.5 A current-limited bench
    supply, never USB, 3.3 V first, sub-millisecond s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
2026-07-31 Ramp the retention scan from sub-millisecond
    The stall itself is the hazardous state, so the scan must approach the
    boundary from below rather than open with a long freeze. The whole retention
    path is now in microseconds: w and W take microseconds, the scan ramps from
    64 us doubling to a 4 s ceiling, and the bisection stops at about 6 percent
    precision instead of chasing 1 us for ~18 extra trials.
    The unit change fails safe: an old habit of typing w 5 now stalls 5 us
    rather than 5 ms.
    All three firmwares rebuilt clean against pico-sdk (tester, general, wifi).
    [main.c, retention.c, retention.h]
2026-07-31 Find and quantify driver contention: the power budget was 6x low
    Asking whether the MOnSter has a clock floor led to its designer describing
    shoot-through, which led to re-deriving our own exposure rather than assuming
    the two designs were equivalent.
    The transform preserved topology but not device ratios. The 1,018 depletion
    loads became 10k resistors, so their ratio is fine, but the 164 enhancement
    VCC-side FETs kept the same BSS138W as their pull-down: a 1:1 ratio where the
    die had a deliberately weak load. Eight nets, all data-bus output drivers, are
    contended 47-93 percent of the time because RnWstretched holds the pull-down
    on through every read while the stale dor bit holds the pull-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
2026-07-31 Correct the supply-rating line that contradicted the new budget
    The 1 A claim sat immediately below the 6x correction. Also notes that the
    old MOnSter comparison was the clue that went unread, and that the 8.8 W is
    concentrated in eight parts rather than spread over the board.
2026-07-31 Implement the rev B fix: series resistors on every VCC-side FET
    DISCRETE6502_REV_B=1 makes gen_netlist emit a series resistor for each of the
    164 VCC-side FETs, restoring the load ratio that ratioed NMOS needs and that
    the transform dropped.
    Off by default, and rev A output is byte-identical by sha256 against the
    fabricated netlist. Rev A is in production and pinned in RELEASE.md, so it
    must not move.
    A blanket 10k would have destroyed the clock: cclk carries 13 nF and cp1
    5.4 nF, where 10k gives a 286 us rise against a 25 us half-cycle. The value
    is therefore sized per net from its gate load to keep the RC rise inside
    5 us, and snapped to values already in the BOM: 158 10k, 5 1k, 2 100R.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
    [gen_netlist.py, switchsim.py]
2026-07-31 Add illustrated rework instructions for the eight series resistors
    Method settled by measuring the copper. Cutting the track between pad 3 and
    its VCC via does not work: only 0.25 mm of that track is bare, and the via is
    epoxy-filled with mask over it, so there is nothing to solder to on the far
    side. Lifting pin 3 avoids both problems, and pin 3 is the lone pin on its
    side of the SOT-323, 1.78 mm from the other two.
    docs/rework-dor-series-r.html has a scale diagram of a site before and after,
    the coordinates of all eight, the procedure and the verification steps.
2026-07-31 Add true-scale renders of all eight rework sites
    Generated from the golden board rather than drawn: every pad, track and via
    is real geometry, front face, 8 x 8 mm around each target, with neighbouring
    designators so the right part can be identified among identical neighbours.
    Labelled as renders, not photographs, since no board exists yet.
2026-07-31 Note that retention must be measured after the rework
    The stall test is precisely the condition the rework makes safe, and a
    pre-rework floor would read pessimistically because eight FETs at 0.8 W warm
    the board and leakage roughly doubles per 10 C. If both are measured, a floor
    that moves is evidence the eight sites were heating their neighbours.
2026-07-31 Document rev A vs rev B in the README and the intro page
    Rev A is what is being built and carries the ratio defect found after the
    order was placed. Records the fix for boards in flight, the generator fix for
    a future revision, and the point that matters: five green gates could not see
    it because they all check topology and none checks strength.
2026-07-31 Fix two errors on the intro page found by viewing it
    The "By the numbers" table still said 1.6 W typical, contradicting the notes
    a few centimetres below it on the same page. And "the eight boards-in-flight"
    attached the eight to the boards rather than to the transistors; there are
    four assembled boards.
2026-07-31 Sweep the remaining stale power figures
    The 6x correction had been applied in prose but several summary figures still
    read standalone as if the old budget were current.
    - cards/pass-pair-validation.md claimed "the power estimate held" at 1.4-1.5 W
    with no qualification; struck and corrected.
    - README's total row now carries an inline warning and an as-built row, so the
    table cannot be read without the correction even if the note below is missed.
    - pico-controller/README used 0.35 A in three places that describe the CLOCKED
    board: the USB rail drop, the Schottky dissipation, and the wifi budget. All
    now use the real ~2.1 A, which also strengthens the point that USB-only is
    not viab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
2026-07-31 Correct the claim that pull-ups consume nearly all the power
    They draw 1.3 W of about 10 W. Driver contention in eight transistors burns
    most of the rest. Found by reading the rendered page rather than the diff.
2026-07-31 Say plainly what all five verification gates miss
    The gates section presented the chain without qualification while the status
    section said those same gates could not see the ratio bug. The two now meet:
    every check asks what is connected, none asks how strongly, and a switch-level
    model that resolves any contention as low will approve a pull-down no stronger
    than the pull-up it fights.
2026-07-31 Redraw the before/after diagram from real geometry
    The hand-drawn version rendered badly: labels overlapping pads, the SOT-323
    caption cut through by a pad, and pad spacing computed at an inconsistent
    scale so the package geometry was simply wrong.
    Now generated from the same Q205 coordinates as the site renders, at 95 px/mm,
    with the labels moved out of the drawing into the caption so nothing collides.
    The AFTER panel greys the dead track and the lifted pad, which the previous
    version did not show at all.
2026-07-31 Fix the track direction in the before/after diagram
    The pad-3 track runs straight down in +y to its via; the generator passed
    0.75 for both x and y, drawing it diagonally. In a diagram whose whole job is
    to show which piece of copper is which, that had to be right.
2026-07-31 Correct a wrong figure: cclk is not a 33-against-31 near-short
    The claim came from a query that counted FETs GATED BY cclk rather than FETs
    ON it. Re-measured, every one of the 164 VCC-side nets has exactly one pull-up
    FET, cclk included: 1 up, 1 down, and 482 gates hanging off it.
    So there is no near-short net and no net worse than another; each contended
    net is the same ~262 mA pair already measured in sim/driver_contention.sp.
    The 8-net finding, the 1.76 A total and the rev B sizing are unaffected, since
    those came from channel-based analysis and from fanout respectively.
2026-07-31 Narrow rev B to the 142 nets that can actually contend
    22 of the 164 VCC-side nets have no pull-down, so contention there is
    impossible and a series resistor would be dead weight: 22 parts and, more
    importantly, 22 more nets to route on a board that was hard to route.
    Also records the check that motivated the question: none of the 164 is a
    parallel push-pull superbuffer where a strong pull-up would be intentional.
    Every one is a single pull-up against pull-downs, so the ratio error is
    uniform and the fix is not over-fitted.
    Equivalence gate green at 142 sites; rev A output still byte-identical.
    [gen_netlist.py]
2026-08-01 Validate rev B in SPICE: the series-resistor fix holds
    Rev B was implemented against a green switchsim run, which
    cards/verification.md had just recorded as structurally incapable of
    judging a ratio change -- so the fix rested on the same gate that missed
    the bug. sim/revb_driver.sp supplies the levels switchsim cannot.
    The chain is taken out of gen/netlist.json rather than invented:
    dor1 -> Q401 -> n798 -> Q192 -> db1, the worst-measured contender at 90%
    duty, carried two stages deep to a real chip output. Rev A and rev B run
    side by side at both rails and at typical and datasheet-max Vth.
    contention current 262 mA -> 0.499 mA (525x)
    contended level 1.86 V -> 2.9 mV (invali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
2026-08-01 Put the rev B simulation results on the rework page
    The page told people to add eight resistors on the strength of an
    argument. sim/revb_driver.sp has since measured that exact modification
    two stages deep to the db1 output pad, so the page now shows the
    before/after numbers: 262 mA -> 0.499 mA, an invalid 1.86 V "low" -> 2.9 mV,
    18 ns -> 271 ns of rise against a 25 us budget, fall unchanged.
    Two things the simulation added that change what the page should say:
    - The output gets STRONGER, not weaker (db1 3.81 -> 4.38 V), because the
    10k keeps bootstrap charge that a stiff VCC drain conducts back into
    the supply. Worth calling out, since a series resistor sounds like it
    should cost dr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
2026-08-01 Add a marked-up board photo of the eight rework sites
    The page could say where the sites are in coordinates and show the copper
    at each one, but nothing showed them on the actual board, which is what
    you look at while holding the iron. This adds JLCPCB's top-side assembly
    view with all eight ringed: magenta for the SOT-323, cyan for pad 3 --
    the lone VCC-side pin to lift.
    The marker positions are not eyeballed. The 36 bond pads were detected in
    the image and the mm-to-pixel transform least-squares fitted against all
    of them, worst residual 0.07 mm against a 0.65 mm pad pitch; the fit also
    confirms the view is not mirrored, which mattered because a mirrored top
    view would put every marker on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
2026-08-08 Add a step-by-step bring-up guide, and settle where the rework belongs
    docs/bring-up.html: the sequence for the boards as delivered (4 assembled,
    1 bare), from receiving inspection through the overnight functional test.
    Each step is tagged with its power state, gated on a stated measurement, and
    followed by what a wrong reading means. Assembled from
    pico-controller/README.md, "Driver contention" and "Expected fab yield" in
    project-plan.md, and the tester's own help text.
    Three things it decides rather than transcribes, each now fixed in the README
    too rather than only in the new page:
    - The eight-site rework sits between the unpowered checks and the first
    clocked run. Steps 1-2 are the o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
2026-08-08 Build the acceptance suite by script, and prove both images pass first
    tools/build_functest.py turns a sibling checkout of Klaus Dormann's
    6502_65C02_functional_tests into images this board can run. It drives the
    suite's own AS65 1.42 (an i386 binary, via docker --platform linux/386, per
    that repo's BUILDING.md) and then does the four board-specific things:
    - sets ram_top = $40, the suite's own preset for a 16k mirrored system
    - folds 64 KB to 16 KB the way the hardware does, and FAILS on a genuine
    aliasing collision rather than letting last-writer-win. The vectors at
    $fffa alias onto $3ffa, so this is a real check, not a formality
    - patches the reset vector, which the suite aims at res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
    [6502_decimal_test_traps.csv, 6502_functional_test_traps.csv]
2026-08-08 Map the 55 register LEDs onto the board, generated from the board file
    tools/mark_leds.py writes docs/leds-marked.jpg: the top-face render with every
    register LED ringed in its register's colour and numbered by bit, plus the
    seven P flags named individually. Linked from Step 6 of the bring-up guide,
    which is where "watch the A LEDs count" has to become "watch these eight, this
    one is bit 0".
    Nothing is drawn by hand. LED positions come from footprint origins in
    gen/board_routed_golden.kicad_pcb; the register grouping and bit index come
    from the `role` and `origin` fields in gen/netlist.json.
    The mm-to-pixel mapping is fitted on the render's own board extents and then
    verified before anythi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
2026-08-08 Downscale the LED map to 1600 px, matching the rework image
    993 KB instead of 1.8 MB, and the same width as
    docs/rework-8-sites-marked.jpg so the two read as one set.
    Drawing still happens at the render's full 2352 px and the finished image is
    downsampled with LANCZOS, rather than drawing small directly. That keeps ring
    weights and text proportional and preserves the layout that was already
    checked, and the bit numbers survive the reduction legibly. `--width 0` keeps
    full resolution if a detail view is ever wanted.
    [mark_leds.py]
2026-08-09 Close the optional-LEDs question: the 55 register LEDs stay as designed
    Bus and IR LED taps were left open as a possible future revision. Closed on
    the user's decision, with the reasoning recorded rather than just the verdict.
    - Bus LEDs would duplicate what is already visible. ab0-15, db0-7, R/W and
    SYNC all land on the bond-pad ring, and the Pico captures the whole bus
    every cycle with the wifi panel already showing it live. The register LEDs
    earn their place because A/X/Y/S/P/PC are internal and nothing outside can
    see them. IR is the one genuinely internal candidate, and even IR is
    derivable: at SYNC the data bus carries the opcode being fetched.
    - A 7-segment alternative was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
2026-08-10 Give the site a real link-preview card
    The page already had an og:image, but it pointed at a relative path that
    crawlers do not reliably resolve, and at a 1474x1600 portrait render that
    the 1.91:1 preview slot crops badly. There was also no og:url, no og:type
    and no Twitter card, so X and Slack fell back to a square thumbnail.
    tools/make_og_image.py composes docs/img/og-card.jpg at 1200x630 from the
    board render, using the palette out of docs/index.html so the preview
    matches the page it links to. Generated rather than hand-edited, so it can
    be re-run after any board re-render.
    [make_og_image.py]
2026-08-12 Log the real bring-up, and fix the Step 1 gate it proved wrong
    The boards arrived and Step 1 read about 195 ohm on all four, which the
    guide's "must read high" gate calls a solder bridge. It is not one.
    There is no resistor-only path between VCC and VSS at all, so the meter is
    reading a junction: 1,899 FET body diodes across 947 nets, each conducting
    VSS to drain and out through that net's 10k pull-up. The display is a diode
    drop divided by the range's test current, so the same board reads 195, 314
    and 3770 ohm on the 200, 2k and 20k ranges while the voltage across it stays
    at 0.36-0.47 V. A reading that changes with range is not a resistance, and a
    plane-to-plane bridge would read under an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
    [step1_model.py]
2026-08-12 Add the receiving-inspection photos to the bring-up log
    Four photos of the delivered boards, wired into Step 0 with captions that
    carry the evidence rather than just describing the picture: the uniform FET
    orientation and single marking code are the rotation and wrong-reel checks
    repeated on real hardware, having previously been verified only on JLC's DFM
    render.
    The underside photo earns its place by failing to settle anything: a 0402 on
    a green board is a few pixels at this scale, which is exactly why Step 1's
    electrical confirmation of the pull-up network matters.
    tools/prep_photo.py downscales to the docs/img convention of 1600 px and
    rebuilds each image from pixel data so no metadata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
    [prep_photo.py]
2026-08-12 Record why the back has empty pads, and what they are for later
    Answers a receiving-inspection question with the census rather than with
    reassurance: 5,421 netlist components less 57 DNP and 36 THT bond pads is
    5,328, which is exactly the CPL row count, so every part that was meant to
    be fitted was fitted.
    The 56 empty 0402 footprints are the DNP ballast capacitors from M4, one per
    bit across the six buses. Worth flagging because sb0-7 are the worst dynamic
    nodes on the board -- no pull-up, 13 FET pins each -- so these pads are the
    built-in remedy if the Step 7 retention floor lands too close to the clock
    ceiling. Noted as a trade: capacitance buys retention and costs speed.
    Co-Authored-By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
2026-08-13 Add the Arduino recipe for Step 3's external clock
    Wiring table plus a four-line sketch. The two facts that make it worth
    writing down rather than leaving to the bench: clk0 has no pull-up, so the
    driver must be push-pull; and RES, IRQ and NMI all float, so they have to be
    tied while RDY and SO must not be.
2026-08-16 Let the tester carry the test images, behind an opt-in build flag
    Pasting 37.6 kB of Intel hex through a terminal by hand is the bring-up step
    most likely to go wrong at the hour you are least fresh. tools/embed_functest.py
    turns gen/functest/ into a C source the firmware links, giving 'T f' / 'T d',
    and a trap map so a self-loop is reported as PASS/FAIL with its listing line
    rather than as a bare address to look up in a CSV.
    Off by default, for licensing rather than technical reasons: the suite is GPLv3
    and this repo is CC BY-NC-SA 4.0, which GPLv3 forbids combining with. Separate
    files in gen/functest/ are aggregation; a binary with the images compiled in is
    not. So the generated functest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
    [embed_functest.py, functest.c, functest.h, functest_images.h, functest_images_none.c, main.c]
2026-08-16 Record the rev A bond-pad order defect
    Four of the 36 pads (A6, VSS, D7, R/W) sit out of die order, found by
    comparing the board against visual6502's JSSim. Nothing is miswired or
    mislabelled -- every pad carries the net its silk names, checked against
    copper -- so the silk is trustworthy and the die photo is not: locate a pad
    by its label, never by counting positions.
    Cause is rim_slot's greedy first-come allocation running in component order
    while the address pads project at a 16.0 mm pitch against 19.7 mm spacing;
    the push accumulates until A6 has nowhere legal and wraps 116 mm back up the
    edge. R/W and VSS separately project inside the corner exclusion. Confidence
    is high because re-sim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
2026-08-16 Log the embeddable test images, and correct the IRQ-trap claim
    The 2026-08-08 entry said a spurious interrupt was benign because
    identifiable. True for NMI ($380B is a real self-loop), false for IRQ:
    $3819 is irq_trap, the BRK-test handler, live code -- so a spurious IRQ is
    absorbed and resurfaces as a failure somewhere unrelated. A wrong verdict is
    worse than a stopped run, which makes tying irq high necessary rather than
    prudent.
2026-08-16 Echo characters as they are typed in the tester CLI
    This is a raw USB CDC link, not a tty, so nothing echoes for us -- screen
    showed a blank line while you typed and only printed the command back after
    Enter. Echo each character and flush it immediately; buffering to the newline
    is the behaviour being fixed.
    Backspace now rubs out on screen as well as in the buffer, or the two
    diverge. Arrow keys (ESC [ A..D) are swallowed instead of landing in the
    command buffer as '[A', with a timeout so a bare ESC cannot wedge the reader.
    Pasted Intel hex ('L') keeps echo off -- 37.6 kB back down the same link
    doubles the traffic for no benefit.
    Verified on hardware: characters return before any newline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
    [main.c]
2026-08-16 Add 'T c' to get the default counter image back
    Loading a test image with 'T f' overwrote the counter loop with no way to
    restore it -- the only paths that reload it were 'w' and 'W', which also run a
    stall trial. 'T c' is the obvious home for it: T already means load a built-in
    image, and the counter is one. Always available, since it is our own code.
    Bare 'T' now lists the counter too, so a default build without the GPLv3
    images gets a useful listing rather than only an error, and an unknown key
    says so instead of silently listing.
    Also corrected a stale comment in retention.h: it called cclk the worst case at
    '33 VCC-side FETs against 31 pulldowns', which counted FETs gated by cclk
    rath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
    [main.c, retention.h]
2026-08-24 Add the VCC-side FET map used for the thermal sweep
    tools/mark_hotsites.py rings all 164 enhancement-mode VCC-side FETs on the
    top-face render, grouped by what they drive, reusing mark_leds.py's fitted and
    verified mm-to-pixel mapping.
    Two facts from the netlist narrow the search rather than just plotting it:
    - 22 of the 164 have no pull-down on their net, so they can never contend and
    can never be hot. Drawn hollow. The 142 that can independently reproduces
    the rev B site count in project-plan.md.
    - the 8 gated by dor0..7 are the sites the rev A hand rework fixes, so on a
    reworked board they must be cold. A hot one there is a bad joint, which is a
    different fault from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
    [mark_hotsites.py]
2026-08-24 Log bring-up steps 2, 2b, 3, 3b — and correct the contention model
    Four steps ran on board #1 over two days. Every one produced a number the plan
    did not have, and the last one falsified a model that has driven planning since
    2026-08-01.
    Step 2 (5 V, unclocked): no bench supply was available, so a fixed 5 V source
    plus series power resistors was used, which is arguably better here — the
    resistor makes the limit physical rather than behavioural, and stepping it down
    IS the voltage ramp. The board draws 1.4 A against a written 0.35 A. A short is
    excluded arithmetically: at 1.50 V it draws 35 mA, so any parallel ohmic path is
    >= 43 Ohm and could contribute at most 116 mA at 5 V.
    Step 2b (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
2026-08-24 Flag the supply arrangement as suspect; mark today's LED spectra provisional
    Hypotheses, not findings, written down so the next session starts with the right
    three measurements instead of more video analysis.
    The supply path ran charger -> junc1 -> junc2 -> ammeter -> board VCC with a
    matching return: six croc segments carrying ~0.9 A. The board's own Step 2 I-V
    curve puts 0.66 A at V_board ~= 3.7 V, so ~1.3 V is being lost in the leads. The
    junc1->junc2 segment is the prime suspect because it doubles as the on/off
    switch, so it is a repeatedly made-and-broken clip contact in the highest-current
    path.
    More seriously, the Arduino was fed from VIN at ~3 V with no USB of its own. The
    NCP1117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
2026-08-25 The CPU executes: the program counter found in a video of the LEDs
    Board #1, 2250 Hz external clock, data bus tied to $EA through 10k, irq/nmi
    clipped to VCC, supply rewired. On a NOP free-run the CPU only fetches and
    increments, so PC bit b must toggle at (clock/2)/2^(b+1) Hz. Either those
    frequencies are in the LEDs or they are not -- and no LED has to be identified,
    mapped or named for the test to work.
    Measured: 92 LEDs land on a predicted PC frequency, zero strong peaks match
    anything else, agreement within 0.15-1.8%.
    The aliased bits are what make it conclusive, not the direct ones. At 29.9 fps
    the fast PCL bits fold back to frequencies that are natural for nothing:
    PCL2 140.6 Hz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
2026-08-25 Add an LED picker so PC bits can be checked by name, not just statistically
    tools/pc_ripple.py proves the program counter is running without knowing which
    LED is which -- it only asks whether the predicted set of frequencies is present
    somewhere. That is deliberately unfalsifiable-by-mislabelling, but it also cannot
    say "this LED is PCL7".
    tools/led_picker.py closes the gap. It builds a max projection of the clip, so
    every LED that ever lit appears in one image, serves it over a local HTTP server
    with a magnifier, and lets a human click and name each one. The result feeds back
    as --labels, and pc_ripple.py then reports each named bit's measured frequency
    against the one arithmetic demands,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
2026-08-25 Track the LEDs through the clip instead of sampling fixed coordinates
    The board drifts in frame. Measured on the 2026-08-25 breakthrough clip by phase
    correlation: 76 pixels of total excursion, 44 px vertical and 76 px horizontal.
    Every analysis so far sampled fixed coordinates with a +/-3 px window, so those
    windows were sitting on bare board for most of the recording.
    That explains two things that had been puzzling. It is why 110 "LED spots" were
    found where the board has 55 LEDs -- a drifting LED leaves several blobs in a max
    projection. And it is why the detections sat at 5-11x SNR rather than far higher:
    the signal was there, but each window only caught its LED while it happened to
    pas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
    [led_picker.py, pc_ripple.py]
2026-08-25 Retract the aliasing argument; the proof is four named bits in a measured ladder
    Naming the LEDs falsified the centrepiece of yesterday's write-up, which is what
    the named test was built to be able to do.
    The claim was that fast PCL bits folding back to "unnatural" frequencies -- 35.16
    Hz appearing at 5.256 Hz, 140.6 Hz at 8.875 Hz -- were the decisive evidence.
    That is wrong. Aliasing requires point sampling, and a camera integrates over its
    exposure, which low-passes the signal. A 562 Hz LED averaged over even a 1/500 s
    exposure spans ~1.1 cycles and comes out a constant half-brightness glow. PCL0
    through PCL5 are physically unmeasurable from video, and the apparent detections
    at their al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
    [pc_ripple.py]
2026-08-25 Add a flash settings store, and clock the board at boot instead of parking it
    Two pieces, the first of which the rest of the firmware work depends on.
    1. common/settings.c reserves the top 64 KB of flash: one sector for a
    CRC-checked settings record (clock period, boot behaviour, WiFi credentials,
    image metadata) and four for a 16 KB 6502 image. 1.6% of a 4 MB part. A tester
    command 'S' shows and edits it.
    Three things this had to get right. Writes go through a RAM staging buffer,
    because flash_range_program needs a source pointer that stays valid while XIP is
    off and a pointer into flash does not. Writes go through flash_safe_execute, and
    the wifi build's core 1 now calls multicore_lockou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
2026-08-25 WiFi provisioning: a captive portal instead of credentials in the build
    The wifi firmware needed WIFI_SSID and WIFI_PASSWORD at compile time, so
    changing network meant rebuild and reflash. Credentials now live in the flash
    settings store and are set from a browser.
    On boot it tries what is stored, twice -- an access point that is merely slow to
    answer should not push a correctly-provisioned board into setup mode. With
    nothing stored, or after two failures, it raises an open AP called
    "discrete6502-setup", serves a setup page with a live scan list, and reboots onto
    the chosen network once saved.
    common/netsrv.c implements the two servers that requires, written from the
    protocols rather than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
    [main.c, netsrv.c, netsrv.h]
2026-08-25 Store a 6502 image as the boot program, on all three firmwares
    Completes the flash-store work. An image saved to flash is what runs at
    power-up: tester stores with 'S store' after L / T f / T d, the wifi panel gets
    store and forget buttons plus a status line saying whether one is stored and how
    large, and general runs whatever is stored in preference to its built-in demo.
    Storing refuses while the CPU is running rather than doing it anyway. A flash
    erase parks the bus engine's core for tens of milliseconds against a measured
    ~1.1 ms retention floor, so the 6502's state cannot survive one either way;
    refusing keeps that from looking like a crash in a run that seemed healthy a
    moment earlier.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
    [main.c, page.h]
2026-08-25 mDNS: the board answers to discrete6502.local
    Finding the board after it joins a network meant the router's admin page or a
    serial console. lwIP has a responder built in, so it now announces itself as
    discrete6502.local and advertises the panel over DNS-SD for network browsers.
    Configuration this needed: LWIP_IGMP, since mDNS is multicast; one netif
    client-data slot for the responder's per-interface state; and MEMP_NUM_UDP_PCB
    raised from the default 4 to 8, because the DHCP client, our DHCP server, our DNS
    hijack and mDNS can all want one at the same time.
    It runs on the station interface only. In setup mode the DNS hijack already sends
    every name here, so a responder there would answer a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
2026-08-25 Carry the runtime estimate through to the board
    Storing a program already persisted the current clock, because
    settings_program_save() writes the whole record. That is the behaviour you want
    -- a program and the speed it should run at belong together -- but it was an
    undocumented side effect, and getting it wrong is quiet and expensive: the
    functional test is 2 h 41 m at 10 kHz and 26 h 52 m at 1 kHz. Store the
    acceptance suite while the clock happens to sit low, perfectly reasonable if you
    had been watching LEDs, and nothing tells you until it has not finished
    overnight.
    So the board now says it. The measured cycle counts from the emulator validation
    (96,779,996 functional, 46,089,513 deci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
    [build_functest.py, embed_functest.py, functest_images.h, main.c, page.h, settings.c, settings.h]
2026-08-25 Rebuild the control panel around the summary, and drop the fiction of stepping
    The old page put a hex trace table, a retention scan you run twice ever, and the
    Run button at the same visual weight in one column. The question you actually
    have on opening it -- is it alive and how far along -- was one green word among
    hex.
    Now: a state pill, what is loaded, a progress bar and time remaining; one primary
    button that says Stop when running and Run when not; then program, clock,
    activity, bus trace and diagnostics folded behind <details>. Nothing was removed,
    only ranked.
    Progress comes from cycles rather than checkpoints. program_cycles divided into
    bus_cycle_count is exact, needs no checkpoin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
2026-08-25 A memory-mapped console: the CPU can print, and you can type at it
    common/console.c gives all three firmwares $3F00 out, $3F01 in and $3F02 status,
    replacing the bare character-out port that only `general` had. The panel gets a
    Console section with the CPU's output and a field to send text; the tester gets
    'C' to show, enable and send; `general` enables it at boot and still mirrors
    output to USB serial.
    The read at $3F01 is deliberately non-destructive, with acknowledgement as a
    separate write. Consume-on-read is the more usual design but it punishes
    perfectly ordinary 6502 code: LDA $3F01 followed by CMP $3F01 reads twice and
    would silently eat a character. Read as often as you like, then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
2026-08-25 Load built-in tests from the panel, and make the wifi firmware observable
    Two bugs found by actually flashing it, both of which would have looked like
    hardware faults at the bench.
    The embedded tests were being silently discarded from the wifi build. CMake
    reported "functest images: EMBEDDED" and the binary grew 280 bytes instead of
    41 KB, because nothing in wifi/main.c referenced the image table and the linker
    garbage-collected it. The real gap underneath: the panel had no way to load a
    built-in image at all. There is now a /images route listing what is compiled in,
    an op=img&k= command to load one, and buttons in the Program section that show
    each image's runtime at the current clock. Loa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
    [main.c, page.h]
2026-08-25 Fix the setup portal being truncated into a blank page
    Joining discrete6502-setup produced an empty captive-portal page, and
    192.168.4.1 served a dark page with no content.
    The DNS hijack and the catch-all were both working -- the phone's gstatic probe
    did reach us. The bug was in reply(), which assembles the whole response in the
    per-connection 1400-byte buffer. PORTAL_HTML is 1560 bytes, so snprintf
    truncated the copy at ~1300 bytes of body WHILE the header still advertised
    Content-Length: 1560 from strlen(body). The browser waits for 260 bytes that
    never arrive, gives up, and renders what it has: the CSS made it, the markup did
    not. A blank dark page, which looks like a hang rather than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
    [main.c]
2026-08-25 Stop the provisioning reboot from bricking the board into a watchdog loop
    Saving WiFi credentials left pico-board-1 in a state where it enumerated as a
    USB serial device, printed nothing, never joined the network, and -- the telling
    detail -- acknowledged a reboot-to-BOOTSEL request without ever staying in
    BOOTSEL. That last symptom is what identifies it: an armed watchdog resets the
    chip out of BOOTSEL and straight back into the application, so the board cannot
    be reflashed by software at all.
    The cause is watchdog_reboot(0, 0, 0) with nothing after it. That call arms a
    reset; it does not stop the caller. Control returns, the main loop comes round
    and arms it again, and the watchdog ends u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
    [main.c]
2026-08-25 Pay for the mDNS and IGMP timers; lwIP was panicking on join
    Joining a network killed the board. It enumerated over USB, printed nothing,
    never appeared on the network, and would not enter BOOTSEL by software, so it
    could only be recovered with the button. Adding boot tracing behind a build flag
    turned that into one line:
    *** PANIC *** sys_timeout: timeout != NULL, pool MEMP_SYS_TIMEOUT is empty
    Enabling LWIP_MDNS_RESPONDER and LWIP_IGMP without raising MEMP_NUM_SYS_TIMEOUT.
    Every protocol that schedules work draws on that pool -- TCP, DHCP, DNS, ARP,
    IGMP, mDNS -- and lwIP panics when it runs dry rather than degrading. Now 16.
    The reason this hid for so long is that start_mdns() only r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
2026-08-25 Autorun in the wifi firmware too, and expose it in the panel
    The tester and general clocked the CPU at boot; wifi did not. That was backwards
    -- a headless board on a shelf is exactly the case autorun exists for, and it is
    the one firmware likely to be left running unattended.
    It now resets and runs immediately after core 1 comes up, deliberately BEFORE the
    network stage rather than after. Associating can take up to 40 s across two
    attempts, and an unclocked board sits at its peak draw the whole time: 1.4 A
    against 0.87 A clocked, measured on board #1, because the dynamic nodes drift to
    undefined levels and thousands of FETs end up biased near threshold. Starting
    first also means a board wi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
    [main.c, page.h]
2026-08-25 Make the clock's live and saved values distinct, and savable
    Changing the clock from the panel did not persist: CMD_CLOCK sets it live and
    never touches the settings record, so the board went back to its stored value on
    the next power-up with nothing saying so.
    Auto-saving on every change would be worse than the bug. A flash write parks the
    bus engine for tens of milliseconds against the ~1.1 ms retention floor measured
    on board #1, so persisting on each click would destroy the CPU's state every
    time somebody tried a different speed -- which is exactly what you do while
    hunting for the clock ceiling.
    So the two values are now distinguished rather than conflated. /status carries
    the saved h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
    [main.c, page.h]
2026-08-25 Give the clock its own Save button, and restart the CPU afterwards
    The Save action now sits next to Set as a plain button rather than appearing only
    when the live and saved values diverge, and it no longer refuses while the CPU is
    running.
    Refusing was the wrong shape. Writing flash parks the bus engine for tens of
    milliseconds against the ~1.1 ms retention floor, so the CPU's state cannot
    survive a save under any arrangement -- making the user stop first only moved the
    work to them without saving anything. It now notes whether the CPU was running,
    writes, and then resets it back to where it was. State loss is unavoidable;
    leaving the CPU in an undefined state afterwards is not.
    Autorun sh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
    [main.c, page.h]
2026-08-25 Every command now stops, acts and restarts instead of refusing
    store, forget, img and vector no longer return 409 when the CPU is running. They
    stop it, do the work, and reset it back to where it was -- running if it was
    store and forget differ from the clock in one way worth keeping in mind: memory
    is live while the CPU executes, so a snapshot taken mid-run captures a
    half-executed image rather than the one that was loaded. They therefore stop and
    WAIT for core 1 to notice, rather than merely not refusing. Core 1 checks its
    queue between chunks of up to 1000 cycles, which is 100 ms at the default clock;
    the wait is bounded at 400 ms because it blocks the lwIP poll on core 0 -- lon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
    [main.c, page.h]
2026-08-25 Keep the network link, and stop a failed join from breaking setup mode
    Three faults, found by asking what happens when wifi does not connect.
    The verdict now prints in the serial banner. It existed only in /status, so
    a functional-test run -- nearly three hours -- was readable only over the
    network. Core 1 keeps clocking through an outage, so the run survives one;
    the result has to survive it too.
    Nothing watched the station link. try_sta() ran once at boot and the link
    was never examined again, so an AP reboot, a lapsed lease or a walk out of
    range cost the panel until someone power-cycled the board. link_watch()
    polls tcpip link status every 5 s, allows 20 s of grace so roaming and
    rekey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
    [main.c]
2026-08-25 The tester no longer waits for a terminal to exist
    It blocked in two places at boot, and the second was the harmful one: with
    autorun off it sat in a sleep loop while clk0 stayed an output driven LOW,
    which is the 1.4 A peak-draw state its own comment warns about. A board on
    a shelf with nobody attached still has a CPU on it.
    There is now one wait, in the main loop, and it does not block. With
    autorun on the CPU free-runs in 500-cycle chunks while nobody is looking;
    otherwise it polls cheaply. read_line() polls instead of calling getchar()
    and returns -1 when the terminal goes away, so a disconnect mid-line -- or
    mid-paste, which load_intel_hex now handles -- unwinds instead of wedging.
    Th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
    [main.c]
2026-08-25 A Network section in the panel, with a way to forget the wifi
    New "wifireset" op clears the stored credentials, saves, and reboots into
    setup mode. A reboot rather than tearing the station down in place, because
    the reply still has to reach the browser that asked for it and that browser
    is on the link being dropped -- so it answers first and reboots 1.2 s later,
    the same ceremony /wifi/save already uses.
    The button lives in a new Network <details> alongside the address and a note
    that the link is watched, and it confirms first: this page stops responding
    and getting back means joining discrete6502-setup. The CPU keeps running
    throughout; only the way you talk to it changes.
    Also fixed whil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
    [main.c, page.h]
2026-08-25 Reset the CPU after the one-time credential seed, and record the session
    The pre-seed path (-DWIFI_SSID on a board with nothing stored) saves flash
    AFTER autorun has already started the CPU. That erase parks core 1 for tens
    of milliseconds against a ~1.1 ms retention floor, so the CPU was left
    free-running decayed state with nothing to ever reset it. It now resets.
    Rare -- only a pre-provisioned build's first boot -- but the same class of
    bug as everything else fixed today.
    Docs brought up to date with the firmware, per the standing rule: the
    README gains the link-watching behaviour, the Network/Forget control, the
    wrong-password scan trap, and the fact that no firmware blocks on a
    terminal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
    [main.c]
2026-08-25 Stop the firmware README restating the bring-up procedure badly
    It duplicated docs/bring-up.html under its own numbering and drifted out of
    date against it in every way that matters. Step 1 still carried the gate
    hardware falsified on 2026-08-12 -- "it must read high", when there is no
    resistor-only path between the rails at all and the meter reads 1,899 body
    diodes, so the value legitimately changes with the range. Step 2 still led
    with the 0.35 A prediction against 1.4 A measured, and had the direction of
    the clocked change backwards. Step 2b still read as pending work. Three
    places in Powering still built arguments on the 2.1 A contention figure
    that thermal imaging retracted on 2026-08-2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
2026-08-25 Measure contention duty, and find why the thermal test missed adh
    switchsim proves topology and is structurally blind to a ratio error --
    _value() returns low as soon as vss is in the group, i.e. it assumes the
    pull-down wins, which is how the 1:1-ratio defect passed five green gates.
    Contention is still visible in the same model, just not through the value:
    a net is contended when its VCC-side FET conducts while its group reaches
    vss. This measures that, under two workloads.
    The second workload is the point. On 2026-08-24 a FLIR image of board #1
    found no localised hot spot and the contention model was retracted. On
    2026-08-25 the same board, running a real program through the Pico, showed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
    [contention_duty.py]
2026-08-25 Map the eleven address-path rework sites
    docs/rework-adh-marked.jpg: an overview plus a zoomed panel per cluster.
    The eleven sit in two groups 40 mm apart and none of them is findable by
    counting, so the zoom panels print the neighbouring designators -- you
    navigate to a part rather than measuring to it.
    Red is the five measured at ~80 C on board #1; amber is the six with the
    same defect that have not been confirmed hot. Positions come from the
    fabricated board, roles and driven nets from the netlist, duty from
    tools/contention_duty.py. The tool asserts all eleven resolve and all
    eleven are on the top face rather than trusting either.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
    [mark_rework_adh.py]
2026-08-25 The FLIR found sites my filter had excluded; remove the filter
    Board #1 showed adl4..adl7 among the hottest parts. contention_duty.py
    had dropped all four before measuring them, on the grounds that they have
    no pull-down and therefore cannot contend. They have no pull-down FET
    sitting directly between the net and vss -- but they are pulled low
    through a pass-gate chain, and that contends with the cclk precharge
    device exactly the same way.
    The FETs the filter did find on those nets are gated BY adl4..adl7, i.e.
    loads those nets drive rather than pull-downs of them. That is the same
    "counted FETs gated by X rather than on X" error already recorded against
    cclk on 2026-08-01, repeated.
    The d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
    [contention_duty.py, mark_rework_adh.py]
2026-08-25 The CPU runs off the Pico, and the contention retraction is retracted
    Board #1 with the Pico soldered: the A LEDs count. Step 6 passed, and the
    first execution from emulated memory rather than a tie-off.
    It draws 2.3 A, and three independent lines say why. The current is the
    same at 500 Hz as at 10 kHz, which switching loss cannot be and static
    contention must be. The FLIR shows discrete 80 C spots, which 2026-08-24
    recorded as absent. And contention_duty.py reconciles the two thermal
    images: the hot sites contend 35% of the time under real code and 0.3%
    under the NOP free-run the earlier image was taken in.
    So the 2026-08-24 observation was sound and the generalisation drawn from
    it was n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
2026-08-25 An all-NOP image, to reproduce the 2026-08-24 thermal condition
    gen/nopfill.hex: 16 KB of $EA, reset vector included ($3FFC reads EAEA,
    PC starts at $EAEA, which 14 address bits fold to $2AEA, which is also
    $EA). Loading it through the Pico reproduces the workload the 2026-08-24
    FLIR image was taken under, so that image and the 2026-08-25 one differ in
    workload and nothing else.
    The generator parses its own output back and asserts full coverage,
    correct checksums and uniform fill rather than trusting the writer.
    [make_nop_image.py]
2026-08-25 Log Steps 5/6, and scope the Step 3b correction that is now itself corrected
    docs/actual-bring-up.html gains the Pico going on and the CPU running a
    real program off it -- the A register counts -- along with the 2.3 A that
    came with it and the three lines of evidence that identify address-path
    contention: current identical at 500 Hz and 10 kHz, discrete 80 C spots,
    and measured duty. Also the two loose ends: an ammeter wandering 1.9-2.8 A
    that is more likely the wiring than the board, and the board singing at
    the clock rate, which is MLCC piezoelectricity and therefore evidence of
    rail ripple rather than a fault.
    Step 3b said "the concentrated-contention model is falsified on hardware".
    Its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
2026-08-25 Embed the video of the board running from its own Pico
    "discrete6502 running from Pico" goes on the front page, under a short
    paragraph saying what it is, and in the bring-up log at the Step 5/6
    section it evidences. Vertical Shorts aspect, capped at ~20rem so it does
    not dominate either page, lazy-loaded, and youtube-nocookie so a reader is
    not tracked for looking at a PCB.
    Both pages keep a plain link alongside the embed, so the page still works
    if the iframe is blocked.
2026-08-25 Reassess the front page: the board is built and running
    The Status section still opened "Designed and verified, not yet built" and
    led with "No physical board exists yet. Nothing here is proven in copper" --
    written before the boards arrived on 2026-08-12, and left standing through
    delivery, power-up, the charge-retention measurement, the program counter
    being found counting, and the CPU executing from its own Pico. Later facts
    had been appended to the bottom, so the section argued the board did not
    exist and then, five paragraphs on, showed a video of it running.
    Rewritten in the order the reader needs: it works, here is the clip, here
    is what is left. The milestone table now distinguishes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
2026-08-25 Put a photograph of the real board on the front page
    Every image on index.html was a render. board-front.jpg in particular is
    the synthetic top view -- flat, no shadows, empty pads -- which is a fine
    illustration of the layout and poor evidence that anything was built.
    bringup-front.jpg has been in the repo since the boards arrived on
    2026-08-12 and was only ever used in the bring-up log. It now sits in the
    Status section between the claim and the video: the reader gets the
    assertion, then a still of the physical object that loads immediately,
    then the clip of it running, which costs a click.
    Alt text describes what is actually in the frame, including the foam and
    the pen, because scale is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
2026-08-25 A photograph of the board actually running, with its LEDs lit
    The delivered-board photo proves the object exists and gives the scale;
    it cannot show that anything works, because it is unpowered. This one is
    the board mid-run: register LEDs lit, and the two hand-written orange
    labels marking A0 and PCH0 that made the program-counter measurement
    falsifiable -- naming the bits instead of asking whether some frequency
    existed somewhere among 55 LEDs.
    The two now sit side by side in the Status section, which is the section
    that claims the thing works. Grid collapses to one column under 46rem.
2026-08-25 Kapton in the rework procedure, and correct its whole-board check
    The amber patches in the photographs are Kapton tape, not the resistors:
    board #1 has a slip between each added resistor and the transistor leg
    lifted to make room for it. That is worth writing into the procedure
    rather than leaving as a photograph nobody can interpret. The leg is
    springy and sits millimetres from something it must not touch, and a leg
    that relaxes back shorts the resistor out silently -- the board keeps
    working and simply runs hot again, which is the worst way for a repair to
    fail. Sixteen more sites are about to get the same operation.
    The whole-board check afterwards was wrong twice over. It told you VCC-V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
2026-08-25 Instructions for the sixteen address-path sites
    Same operation as the data-bus eight, and that is checked rather than
    assumed: on all sixteen pin 3 is the VCC side, all sixteen are on the
    front face, and the resistor value is computed with the same
    series_r_for() rule gen_netlist.py uses so the hand fix and a future rev B
    cannot drift apart. All want 10k -- each net drives exactly one gate, so
    the rise is ~0.6 us against a 25 us half-cycle. Do not generalise that:
    cclk drives 482 gates and needs 100R.
    Two things make these easier than the last eight: nearest neighbour is
    2.80 mm against 1.94 mm, and the contact sheet marks pin 3 on every crop,
    which is the only thing you actually need to id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
    [make_rework_adh_page.py]
2026-08-25 A plan for rev B, and the finding that changes what it emits
    cards/rev-b-plan.md collects everything only a new board can fix, with the
    evidence for each: the site filter, the two 100R clock sites that want an
    0805, the bond-pad ring order defect, and a strength gate to replace the
    five topology gates that all missed the original bug.
    The headline is item 1, and it was found by a thermal camera rather than
    by reading the code. Rev B emits 142 of 164 sites, skipping the ones with
    "no pull-down". Measured: 164 nets have a path to vss, ZERO are genuinely
    isolated, 40 contend in at least one workload, and 21 of those 40 are
    missed by the filter -- including adl6 and adl7 at 45.7%, the two busie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
2026-08-25 Rev B: a resistor on all 164 sites, and its own output files
    The has_pulldown filter is gone. It recognised only a transistor with vss
    directly on a channel pin, so it missed nets pulled low through a
    pass-gate chain -- which contend identically. Measured: zero of the 164
    VCC-side nets are genuinely isolated, 40 contend under at least one
    workload, and 21 of those were in the skipped set, including adl6 and adl7
    at 45.7% duty, the two busiest sites on the board. There is no filter now
    because the correct filter admits everything.
    Rev B also writes gen/netlist_revb.json and gen/discrete6502_revb.net
    instead of sharing rev A's path. It used to overwrite gen/netlist.json --
    the netlist check_p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
    [gen_netlist.py, switchsim.py]
2026-08-26 The workload split was an artifact; all sixteen contend
    The rework page told you five of these sites contend 35% of the time under
    real code and 0.3% under a NOP free-run, and to measure with the CPU doing
    real work. Both halves were wrong, and hardware said so first: under a NOP
    free-run every one of them runs hot.
    The cause is a 150-cycle simulation. The program counter barely moves in
    that window, so PCH sat at $EA throughout -- and adh IS the high byte of
    the address during a fetch. The bits that measured 0% were exactly the bits
    SET in $EA: a bit already high is not being pulled low, so it cannot
    contend. Re-run with PCH = $00 and all eight measure 48%.
    So contention here is ADDRESS-d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
    [make_rework_adh_page.py]
2026-08-26 Sweep out the workload-dependence claim; it was my artifact
    The NOP test predicted adh3/5/6/7 would go cold and adh4 get hotter. Every
    adh site stayed hot. The cause: contention_duty.py ran 150 cycles, in which
    the program counter barely moves, so PCH sat at $EA throughout -- and adh IS
    PCH during a fetch. A bit already high is not being pulled low and cannot
    contend. The bits that read 0% were exactly the bits set in $EA; re-run at
    PCH = $00 and all eight read 48%.
    So contention here is address-dependent, not workload-dependent, and the
    claim has been removed from every file that carried it: the two rework
    pages, index.html, actual-bring-up.html, cards/rev-b-plan.md, and the three
    tools. c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
    [contention_duty.py, make_nop_image.py, mark_rework_adh.py]
2026-08-26 A stopped board draws 0.30 A, which retires the 1.4 A question
    Measured with the Pico fitted and the clock parked: 0.30 A, against a
    design prediction of 0.35 A typical and a 0.548 A passive ceiling. Nothing
    is wrong with the board at rest and never was.
    The 1.4 A that drove a fortnight of reasoning was measured with NO Pico on
    the board, so clk0 -- which has no pull-up here -- along with the data bus
    and reset were all floating. That condition really does drift the dynamic
    nodes and bias thousands of FETs near threshold, which is what the
    2026-08-24 correction proposed. It is simply not the state a populated
    board sits in.
    Executing draws 1.70 A, so contention is 1.40 A: about 180 mA per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
    [main.c, page.h]
2026-08-28 Fix the stack: Q2577 gate-drain leak pinned S bit 0 high
    Board #1 failed the decimal test at $02F3. Traced to a single transistor:
    Q2577 (pull-down, gate s0, drain n983) had a 20k gate-to-drain leak against
    177k on its matched twin Q3793. n983 carries a 10k pull-up (R585) and s0 is a
    pure dynamic node with no pull-down, so S bit 0 could never fall -- PHA could
    not decrement S, RTS pulled flag bytes instead of a return address, the PC
    landed in the zero-filled void, $00 = BRK, int_trap. Repaired by transplanting
    the FET from Q4050, a P2-flag LED driver the CPU does not use.
    A random fab defect on a net the rework never touched, matching the recorded
    yield estimate of 0.5-2 per board.
    New: t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
    [board_probe.py, mark_adl7_site.py, mark_probe_points.py, mark_q2577_swap.py, mark_s0_probe.py, mark_stack_sites.py, quick_selftest.py]
2026-08-28 Board navigator: find any of 5,425 parts, and point at them live
    Bring-up keeps asking the same question — where on 300 x 322 mm is the
    thing I just found in the netlist? — and the answer was a one-off
    tools/mark_*.py that baked a JPEG. This is the live version.
    navigator/server.py serves both board renders with every placed part
    overlaid at its true position: search by ref, net, role, value or layer,
    click a part for its pins and nets, click a net for everything else on
    it, and ask for the twelve nearest neighbours, which is what you can
    actually read under a magnifier when identifying a site. An HTTP API
    plus a hand-rolled WebSocket (no dependencies) lets an agent or a second
    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
2026-08-28 Card: when and how an agent should reach for the navigator
    cards/navigator.md, in the trigger list in place of the README pointer —
    the README is the reference, the card is the judgement about when to use
    it and what its answers do and do not prove.
    Three things it insists on. Use it to ANSWER, not only to display:
    `navctl part <ref>` returns the eight nearest neighbours, which is the
    method that finally found Q2577 after three wrong calls, because an
    in-circuit reading measures the part and everything around it. Derive
    group membership and state the expected count, so the has_pulldown
    failure — missing nets pulled low through a pass-gate chain, dropping
    adl6/adl7 — is structurally im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
2026-08-29 Self-test firmware: a verdict that needs nobody watching
    Measured twice on 2026-08-29, at the identical step both times: attach a
    terminal to the tester and the USB port dies about a second later, while
    the same board had free-run 108,008 cycles quite happily with nobody
    looking. The banner says why -- "CPU free-ran N cycles while waiting;
    stopped now" -- the tester stops clocking when a terminal appears, and a
    parked clock is the board's high-current state (2.2 A against 1.70 A
    executing, 0.27 A at rest). On a marginal supply the observer destroys
    the thing it is observing, and every interactive route to a verdict runs
    into that.
    pico-controller/selftest/ never waits for anybody. It loads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
2026-08-29 Selftest: measure in 60 ms, then stop loading the rail and talk
    Reshaped around what board #1's supply actually allows, measured this
    evening rather than assumed. VSYS is board VCC (pin 39 soldered), so the
    board's draw browns the Pico out: clocking, it survives about a second;
    with clk0 floating, about sixteen -- long enough for 29 clean printed
    lines at two per second. Trying to hold a USB link while clocking is
    therefore hopeless, and every firmware theory tried tonight (USB task
    starvation, enumerate-before-clock ordering) was excluded by experiment.
    So: run the 23 subtests once at boot (reset + 600 cycles, ~60 ms), latch
    the verdict address, float clk0 -- the light-load state the diagn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
    [main.c]
2026-08-29 The board dies 15 ms after the clock starts, and that is the whole story
    Shortened the test window from 60 ms to 15 ms (300 cycles at 20 kHz, the
    design ceiling) to see whether the verdict could be taken before the rail
    collapses. It cannot: five attempts out of five printed "link up, running
    23 subtests now" and dropped the link inside the test.
    That bounds the fault precisely. Unclocked, the Pico runs at least 16 s
    and prints 29 clean lines at 2 Hz. Clocked, it dies in under 15 ms. VSYS
    is board VCC through soldered pin 39, so the board takes the module with
    it, and no firmware change can reach that: the current is clock-
    independent, so it cannot be slowed under the limit, and riding out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
    [main.c]
2026-08-29 Navigator: the precharge FETs nobody reworked, found at 80 C
    The idb column ran hot on 2026-08-29 with the adh/adl rework already
    done, and the navigator is what named it: Q1830 resolved to a vcc_side
    FET gated by cclk, precharging idb7, and the seven parts above it in the
    same column are idb0-6.
    They carry the identical 1:1 ratio defect as the sixteen address-path
    sites and take the identical fix -- 10k in series with pin 3 -- but were
    never in that rework set. Their gate is cclk, so a stopped clock parked
    high turns all eight on at once against whatever holds the bus low;
    eight at the simulated 262 mA is 2.1 A, which is the order of the draw
    that folded a 2.4 A charger back to 3.6 V and t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
2026-08-29 Asymmetric clock: contention is a duty-cycle problem, so change the duty
    Traced through the netlist tonight, not assumed: clk0 low parks cclk low
    and every one of the 32 cclk-gated precharge FETs is off; clk0 high turns
    them all on at once against whatever holds their bus low. The chain is
    clk0 -> Q2229/Q2420 -> n519/n358 -> n1129/n1467 -> Q432/Q3504 -> cclk.
    So contention current flows almost entirely during the HIGH phase, and
    the average scales with duty cycle.
    bus_set_phase_us(high, low) splits the two phases; bus_set_half_period_us
    still sets both, so nothing else changes. The bounds are measured, not
    guessed: high >= ~25 us to settle (sim/fanout_speed.sp, PLA lines drive
    up to 71 gate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
    [bus6502.c, main.c]
2026-08-29 Handoff: the 2 A has a name, and clk0 must be parked low
    Records what tonight found after the 15 ms result: the hot column is the
    cclk-gated idb precharge FETs, never in the adh/adl rework set (sb0-7 are
    eight more), and the clk0 -> cclk chain that makes clk0 low the 0.30 A
    state and clk0 high the 2 A one. That reconciles the plan's two
    contradictory "clock parked" figures.
    Also records the user's pull-down suggestion and why a pull-up would be
    the worst choice, the unpowered meter check matching the 2026-08-12
    baseline, and the epoxy strain relief with the one failure mode it can
    cause -- a lifted pin pressed back onto its pad shorts out the series
    resistor, so the sixteen reworked sites w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
2026-08-29 Navigator: the board map becomes a URL, with writes behind a token
    Deploys navigator/ to https://ai.memention.net/d6502navigator/ — nginx on the
    ai VPS proxying a systemd unit, redeployed by navigator/deploy.sh. Nothing
    about the board, the netlist or the fab package changes; this is tooling.
    Two things had to give. The page was root-absolute throughout, so serving it
    under a prefix takes a --base argument: the server strips it from every request
    and injects it into the page as <body data-base>, which is where app.js gets
    the prefix for its fetches and its WebSocket. With no --base the navigator is
    byte-for-byte what it was, at the root of its own port.
    And the write API had no auth a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
2026-08-29 Card: the navigator now has a public URL, and it is read-only to us
    The deploy landed in 8880aed but cards/navigator.md still described a
    localhost-only tool, and a stale card is worse than a missing one. Records
    the URL, deploy.sh, and the one fact an agent will otherwise learn by
    getting a 401: writes need a token that lives on the VPS, so annotations
    and view commands go to the local server. Also notes that the deployment
    ships a prebuilt board.json, so a placement change needs build_data.py plus
    a redeploy or the two disagree.
    Also ignores pico-controller/*/build_*/ — the USB_ONLY diagnostic build
    directory was showing up as untracked.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
2026-08-29 Split the plan: it was 158 KB, and every session paid for all of it
    CLAUDE.md @-imports project-plan.md, so 1,577 lines of mostly-closed history
    loaded into context before anyone typed anything -- roughly 40k tokens of
    standing cost for a file whose live part is the last few handoff entries.
    Nothing is edited or deleted; four cards take the history verbatim, each with
    a trigger in CLAUDE.md so it loads when it is relevant:
    cards/bring-up-log.md boards on the bench, 2026-08-12 .. 2026-08-26
    cards/build-log.md design, fab package, firmware, 2026-07-18 .. 08-08
    cards/fab-order.md both cost tables, stackup + DFM verification, yield
    cards/driver-contention.md the ra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
2026-08-29 Trim Decisions too: keep what binds, link the rest
    The section mixed two kinds of entry. Short directives and settled choices --
    the 6-layer decision, the FET part, the die-mimicry directive -- are a few
    lines each and are the reason the log is read at all. Sixteen others were
    hardware findings and milestones filed as decisions, 10-30 lines apiece, and
    those were 230 of the section's 238 lines.
    Every decision is still here. The narrative ones are condensed to the part
    that still binds -- "a fault is <1 Ω, or a value that does not change with
    range", "tie the data bus to $EA through 10k", "locate a pad by its label,
    never by counting", "never write Pico flash while the CPU is running" --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
2026-08-30 Write up the CLK0 pull-down proposal for review
    Standalone brief on the suggested 10k/47k from CLK0 to VSS, so another agent
    can review it without reading the plan. The load-bearing claim is the two
    inversions between clk0 and cclk -- clk0 -> Q2229/Q2420 -> n519/n358 ->
    n1129/n1467 -> Q432/Q3504 -> cclk -- which makes the chain non-inverting and
    means clk0 high turns all 32 cclk-gated precharge FETs on at once. That is
    traced from gen/netlist.json with a snippet that regenerates it, and both
    directions are walked in a table rather than asserted.
    Two things the write-up turned up that were not in the plan. TP25 and TP35
    are on opposite edges -- 308 mm apart on a 322 mm board, and there is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
2026-08-30 The asymmetric clock did not save it: the brownout is peak-limited
    Flashed the 9%-duty selftest after picotool erase -a. Two attaches, identical
    both times: the banner prints and the link drops 0.32-0.36 s later, which the
    firmware's 300 ms post-banner sleep places within 20-60 ms of the first clock
    edge. The Pico returns after ~27 s, its own USB wait, so it is rebooting
    rather than hanging.
    This falsifies the half of last night's proposal that was testable without
    hardware. Cutting duty to 9% does cut the average current as predicted, but
    VSYS browns out on the 40 us peak and duty does not touch the peak. The same
    entry made bulk capacitance a condition and it was never fitted, so what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
2026-08-30 Wifi: split clock phases, and do not autorun a board whose flash is blank
    Two changes, both from this morning's measurement. A picotool erase -a plus
    wifi.uf2 produced no AP, no station and no USB device, and the boot order says
    why: main() starts clocking on autorun at line 1158, BEFORE cyw43_arch_init(),
    so a rail that cannot carry the clocked current takes the Pico down before the
    radio is up. There is then nothing to tell you what happened.
    settings_were_stored() already distinguishes "the user chose autorun" from
    "flash is blank so these are defaults", so a blank board now comes up QUIET --
    it reaches the network, serves the panel, and waits to be told to clock. Save
    any setting and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
2026-08-30 Map the 16 remaining precharge sites, with their duty measured
    tools/mark_rework_precharge.py draws idb0-7 and sb0-7 the way the adh/adl
    sixteen were drawn: an overview plus a zoomed panel per cluster, with
    neighbouring designators, because neither group is findable by counting.
    The duty figures are measured, not carried over. contention_duty.py --halves
    600 puts all sixteen at 14.7-16.0% under real code -- about half the address
    path's 34%, and well above the dor eight that were reworked first. Sixteen
    sites at 15% is ~2.5 nets contending continuously, ~0.65 A at the simulated
    262 mA per net. The near-zero nop figures are the address-dependence the tool
    documents, not idleness.
    Q1830 i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
    [main.c, mark_rework_precharge.py]
2026-08-30 Flash the Pico without the BOOTSEL button
    Pin 39 is soldered, so VSYS is board VCC: unplugging USB does not reset the
    module, and BOOTSEL is only sampled at reset. Entering it therefore means
    cycling the BOARD supply while holding the button, which on a board that is
    simultaneously being probed and reworked cost most of an hour today.
    pico_stdio_usb already implements the 1200-baud touch, so opening the port at
    1200 baud and closing it reboots straight into BOOTSEL -- no button, no power
    cycle. tools/pico_flash.py waits for a port, touches it, waits for the volume,
    and copies; it polls at 20 Hz because on a boot-looping board the port exists
    for a fraction of a second.
    It uses cp rather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
    [pico_flash.py]
2026-08-30 A plan forward, and the measurement that reframes the evening
    The user's observation is the important one: a serial port exists only while
    the board draws 2.5 A, and there is no port at 0.24 A. The Pico running and
    the board drawing 2.5 A start and stop together, which makes this a boot loop
    rather than a dead board -- boot, draw, fold, reset, repeat. The ~2 Hz S1
    blink seen on 2026-08-29 is the same loop.
    docs/plan-2026-08-30.md orders the next steps so each removes a variable, and
    separates the two that need parts from the two that do not. Step 1 costs
    nothing and halves the possibilities: run the whole board from USB alone, since
    0.24 A is within a port's budget and pin 39 already tie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
    [pico_flash.py]
2026-08-30 clk0 pull-down: mechanism confirmed, sizing corrected from 47k to 4.7k
    The proposal was fitted as 31k and measured: 0.77 V with the board at 0.24 A,
    1.76 V with it at 2.5 A, straddling the 0.8-1.5 V threshold band. That
    confirms the two-inversion trace and the 32-FET consequence exactly.
    It also falsifies the sizing. The document assumed the node's only DC load was
    two FET gates drawing nothing; the hardware sources 25-57 uA into it, so 31k
    sits at 1.76 V and the recommended 47k would have sat at ~2.7 V -- fully on,
    the failure the resistor was meant to prevent. 4.7k is right.
    The original table is left visible rather than edited away, with a correction
    box above it, and a fifth review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
2026-08-30 Withdraw Step 1: the risk is the Pico's VBUS diode, not the Mac
    [user caught it] Running the whole board from USB alone would pass the board
    current through the Pico's VBUS->VSYS Schottky, a small part sized for USB's
    500 mA rather than for 2.5 A. A host port current-limits and recovers; that
    diode does not, and losing it kills the module's power path -- trading a
    diagnosable board for a dead one to answer a question that is free to answer
    another way.
    Replaced with the passive measurement that answers the same question: volts
    across TP36/TP35 while the board draws 2.5 A. Below ~4.5 V means the supply is
    folding, which the iPhone charger's 3.6 V at 2.5 A has probably already
    established.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
2026-08-30 Isolate the fault to one line: driving clk0 low kills the board
    Three builds, each removing a variable, all flashed without the BOOTSEL button
    via the 1200-baud touch.
    USB_ONLY (never touches a pin): 91 lines over 45 s, link rock stable. That
    clears the Pico, the cable, the port and the rail at rest -- every failure today
    is caused by something the firmware does to the board.
    BUS_ONLY (bus_init and nothing else): died inside the call, before its return
    line. bus_init sets 22 pins to inputs and drives exactly one, clk0, LOW.
    So BUS_ONLY became an A/B in a single run: [A] bus_init(open_drain=true), which
    releases the 22 pins and leaves clk0 an input, then [B] driving clk0 low. [A]
    surviv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
    [main.c, mark_precharge_rework.py, pico_flash.py]
2026-08-30 The clk0 note traced cclk and forgot cp1, which is half the clock
    clk0 LOW gives cclk LOW *and* cp1 HIGH -- complementary, as a two-phase clock
    must be, and cp1 gates 198 loads. In a 6502 phi1 is when the pass gates
    conduct, so "clk0 low is the quiet state" was only ever half-established: the
    32 precharge FETs really do turn off, and 198 gates really do turn on, and only
    the first half was ever checked. Traced from gen/netlist.json:
    clk0 -> n358 -> n1715 -> n1399 -> Q2482 -> cp1, with n1105/Q1705 agreeing.
    Found by experiment, not by rereading. Three builds on board #1: nothing
    driven holds a link for 45 s; bus_init with clk0 left an input is healthy for
    8.5 s; driving clk0 low is dead i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
2026-08-30 Session log for 2026-08-30, written as a handoff
    docs/session-2026-08-30.md is written for an agent that has read CLAUDE.md and
    project-plan.md and nothing else: the state of the hardware as it sits on the
    bench, what was established today and by what measurement, the contradiction
    that is still open, the next action, and the traps that cost time.
    The headline is an isolation. Three builds each removing one variable: a
    firmware touching no pin holds USB for 45 s, bus_init with clk0 left an input
    is healthy for 8.5 s, driving clk0 low kills the module in 230 ms and a 1 ms
    pulse is enough. That clears the Pico, the cable, the port and the rail at
    rest, and puts the whole fault on one GPIO t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
2026-08-30 Handoff log: the stack defect thread, and the idb/sb precharge map
    docs/handoff-2026-08-30-stack-defect.md covers 2026-08-26 (FAILED at $02F3)
    through 2026-08-28 (23 datapath subtests passing). Scoped deliberately: the
    concurrent bench-power thread is another agent's docs/session-2026-08-30.md,
    and section 6 says where the two touch rather than duplicating it.
    Also adds the map for the sixteen un-reworked precharge sites, idb0-7 and
    sb0-7 -- the standing hardware fault. Generator derives them from the netlist
    and board file; verified against the navigator's independent resolver, all
    sixteen agree. The legend carries the hazard that smoked board #1: pin 1 on
    every one of these is cclk itself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
2026-08-30 The polarity is inverted: CLK0 low is the quiet state
    Measured on the bench tonight, two ways. CLK0 grounded through 1k reads
    60 mV, the board draws 0.24 A and the scope shows a stable rail. Undriven
    it sits at 1.7 V and the current swings 1-2 A. So the board is well behaved
    when the clock pad is held low and badly behaved when it is left undefined.
    That reconciles the contradiction this plan has carried since 08-29 --
    "clock parked, 2.2 A" against "clock parked, 0.30 A" were the same words
    describing opposite pin states. It also withdraws the 08-30 proposal to
    invert clk_park_low() in selftest, tester and wifi: the clip test was run
    and park-low is correct.
    Retracts an established fact: "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
2026-08-30 The board has hysteresis, which is why every model kept dying
    Scoping the CLK0 pad shows it wandering across the switching threshold on
    its own, and tty presence tracks the voltage rather than the current. The
    same voltage was seen with both 0.27 A and 1.5-2.5 A, which is the tell:
    the board's state is not a function of CLK0's present level.
    The sequence that proves it should be impossible. With tty up, fitting the
    1k killed it; removing the 1k did not bring it back; the tty returned only
    when a ~1 MOhm scope probe was clipped across VSS and CLK0 -- thirty times
    weaker than the pull-down already fitted, so it cannot pull the node
    anywhere. It can only give stored charge somewhere to go.
    So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
2026-08-30 All sixteen precharge sites heat, and the 08-29 model was right
    sb0-7 and idb0-7 all got hot -- the first thermal evidence on the sb half.
    The heat tracks tty, i.e. it appears when CLK0 is above ~1.5 V, which is
    exactly what the 2026-08-29 cclk trace predicted: clk0 HIGH turns all 32
    precharge FETs on at once, and the 16 with no series resistor contend.
    So the 08-30 cp1 worry is retired and park-clk0-low is correct. My "the
    polarity is inverted" framing in the entry above overstated it: nothing
    inverted, the 08-29 model was right and is now confirmed thermally.
    The sharp point is that a stuck-high CLK0 is worse than clocking. Clocking
    gives those sites ~50% duty; sitting at 1.9 V gives 100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
2026-08-30 The 62 uA is down to two candidates, and D66 is not one of them
    A twin comparison against IRQ and NMI -- identical clamp pairs, identical
    100 Ohm series resistors, and like clk0 no pull-up -- clears D66. That
    matters because the clk0 net is small: R1079, the two clamps, two FET gates
    and R1107 to the Pico. Gate oxide passes no DC unless punctured, so with the
    diodes gone only two things can source 62 uA into that node.
    Either GP22's ESD diode is degraded -- the board is 5 V, RP2350 pads are not
    5 V tolerant, and that diode has conducted every time clk0 went high for
    three days -- or Q2229 or Q2420 has a gate-drain leak. The second is the
    Q2577 failure mode on the same board, and the arithme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
2026-08-30 Rev B gets rules, and the first one is that pads go where the die puts them
    Documentation only -- nothing on the board, in the netlist or in the fab
    package changed. Rev B has not been generated or fabricated, so rev B is the
    next board and every deferred item was retargeted to it; there is no rev C.
    cards/rev-b-plan.md section 0, five binding rules [user directive]:
    R1 bond pads sit at their die-true positions, in die order, on all four
    edges, with a per-edge assertion that placed order equals die order and
    a feasibility check that fails loudly instead of relocating silently.
    R2 VCC and VSS come off the ring's order constraint and become large
    solderable B.Cu pads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
